PhilippSchmaelzle/speedoino/doc/Pointer/with_light.jpg

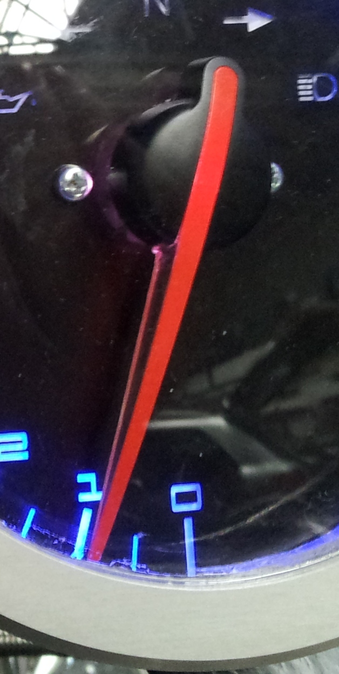
doc/Pointer/with_light.jpg
