PhilippSchmaelzle/speedoino/doc/Pointer/no_light.jpg

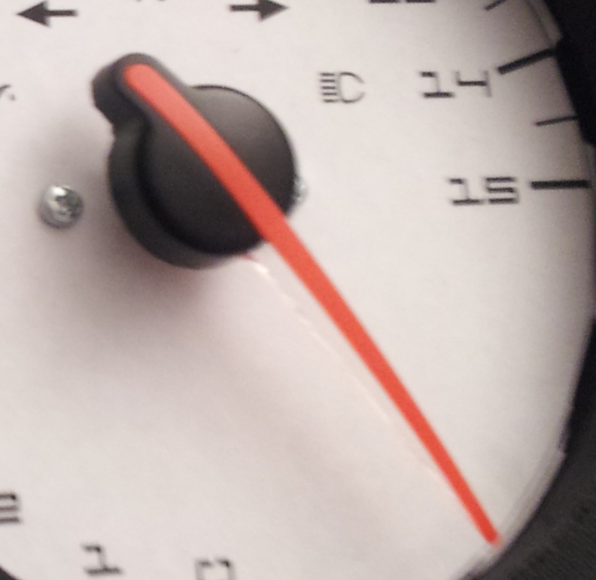
doc/Pointer/no_light.jpg
