PhilippSchmaelzle/speedoino/README.md

# speedoino
A DIY Speedometer with OLED Display, GPS, Bluetooth, etc
Please refer to www.speedoino.de
