PhilippSchmaelzle/speedoino/FirmwareReleases/README.txt

07.04.2013 	Speedoino_Phil_1v1	Lief stabil keine Interrupts auf Ölleuchte, nur polling. Keine MSG 530 Verarbeitung, letze Version aus der Einbauaktion mit Phil

07.04.2013 	Speedoino_1v11		Sollte Stabil laufen, nur schöner programmiert (Interrupts für alle V7 Platinen wenn Triumph nicht aktiv)

08.04.2013 	Speedoino_1v12		Alle Filter, alle lichter, MIL deaktiv im stand

21.06.2013	Speedoino_2v1		CAN stable @Phil (center bug)
								Gear Calibration Menu fixed
								Subdir support added (GPS)
								Demo Mode started
								Animation menu automatic
								Resolve I2C Bug leading to rare reboots
