PhilippSchmaelzle/speedoino/calculations/CAN/USB_CAN_BRIDGE/1M_pegel.BMP

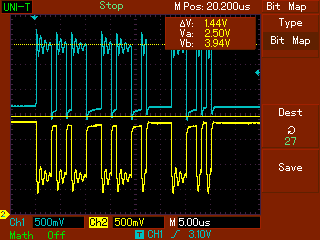
calculations/CAN/USB_CAN_BRIDGE/1M_pegel.BMP
