PhilippSchmaelzle/speedoino/calculations/CAN/USB_CAN_BRIDGE/10khz_adr123.BMP

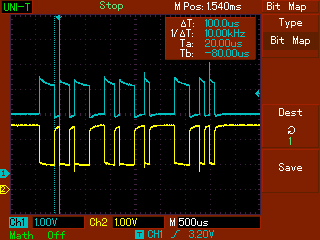
calculations/CAN/USB_CAN_BRIDGE/10khz_adr123.BMP
