PhilippSchmaelzle/speedoino/calculations/CAN/USB_CAN_BRIDGE/10khz_adr555.BMP

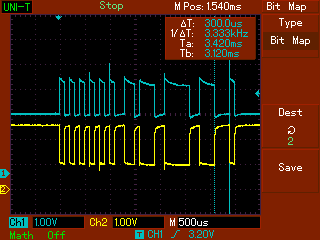
calculations/CAN/USB_CAN_BRIDGE/10khz_adr555.BMP
