PhilippSchmaelzle/speedoino/calculations/CAN/USB_CAN_BRIDGE/500khz_adr123.BMP

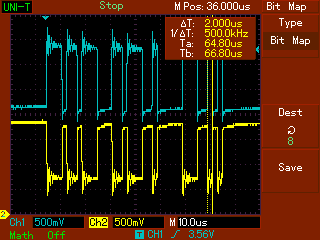
calculations/CAN/USB_CAN_BRIDGE/500khz_adr123.BMP
