PhilippSchmaelzle/speedoino/doc/Pointer/needle.bmp

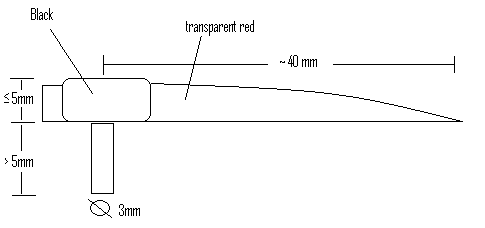
doc/Pointer/needle.bmp
