PhilippSchmaelzle/speedoino/doc/Stepper/avr446/code/IAR/doxygen/graph_legend.png

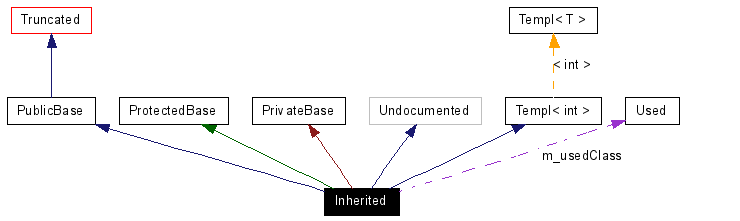
doc/Stepper/avr446/code/IAR/doxygen/graph_legend.png
