PhilippSchmaelzle/speedoino/doc/Stepper/avr446/code/IAR/doxygen/main_8c_a4_cgraph.png

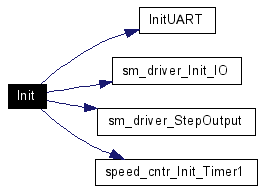
doc/Stepper/avr446/code/IAR/doxygen/main_8c_a4_cgraph.png
