PhilippSchmaelzle/speedoino/doc/Stepper/exel/floating.png

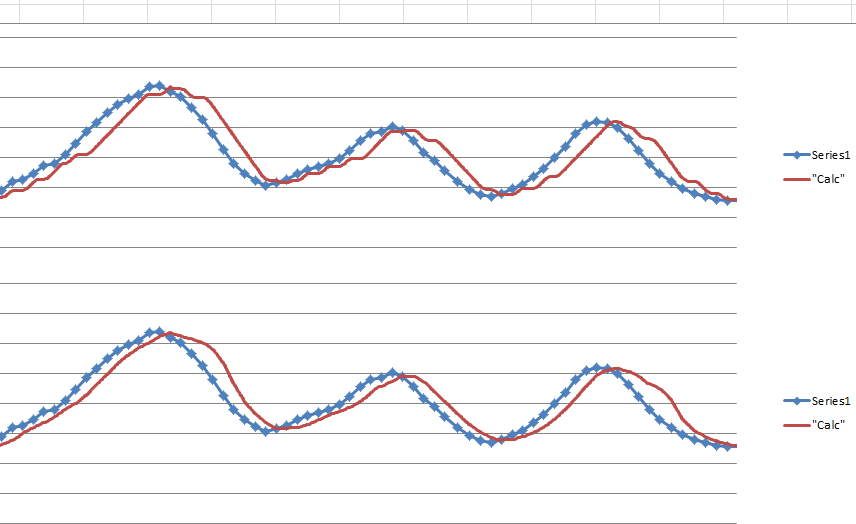
doc/Stepper/exel/floating.png
