PhilippSchmaelzle/speedoino/doc/Stepper/exel/pos_verlauf.png

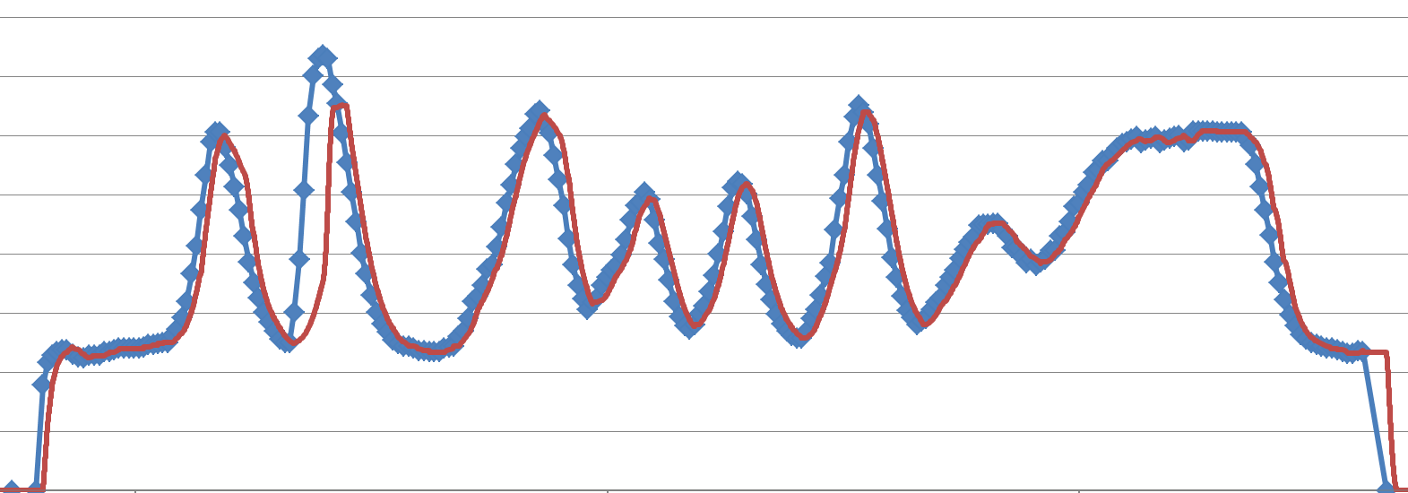
doc/Stepper/exel/pos_verlauf.png
