PhilippSchmaelzle/speedoino/pub/animation/31daf8fb84e5.gif

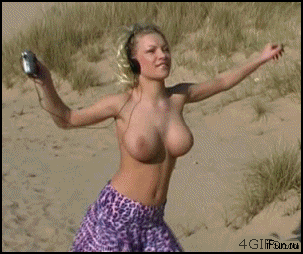
pub/animation/31daf8fb84e5.gif
