PhilippSchmaelzle/speedoino/pub/animation/659.gif

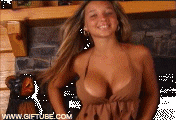
pub/animation/659.gif
