PhilippSchmaelzle/speedoino/pub/animation/Bluetop.gif

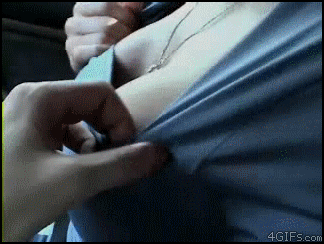
pub/animation/Bluetop.gif
