PhilippSchmaelzle/speedoino/pub/animation/doggy.gif

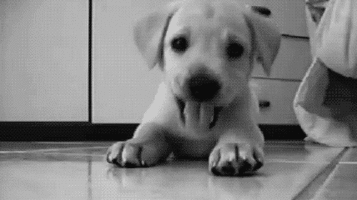
pub/animation/doggy.gif
