PhilippSchmaelzle/speedoino/pub/animation/Fluidboobs1.gif

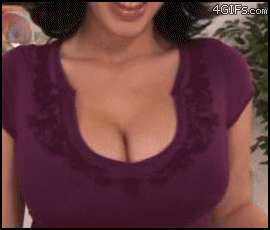
pub/animation/Fluidboobs1.gif
