PhilippSchmaelzle/speedoino/pub/animation/HarleyD.gif

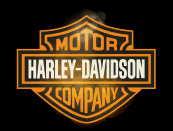
pub/animation/HarleyD.gif
