PhilippSchmaelzle/speedoino/pub/animation/Hitomi_Tanaka_oiled.gif

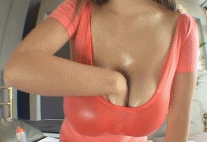
pub/animation/Hitomi_Tanaka_oiled.gif
