PhilippSchmaelzle/speedoino/pub/animation/MILF_boob_squeeze.gif

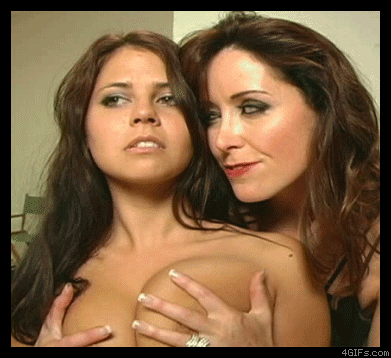
pub/animation/MILF_boob_squeeze.gif
