PhilippSchmaelzle/speedoino/pub/animation/Octojiggle.gif

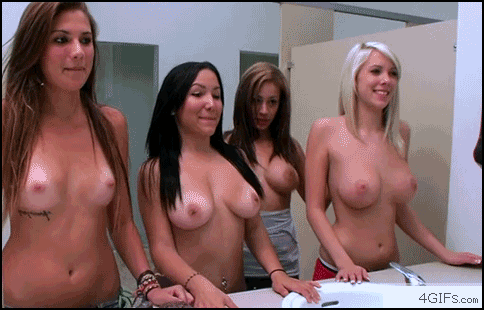
pub/animation/Octojiggle.gif
