PhilippSchmaelzle/speedoino/pub/animation/TgC_comic191.gif

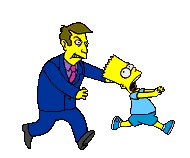
pub/animation/TgC_comic191.gif
