PhilippSchmaelzle/speedoino/pub/animation/Tiara_flasher.gif

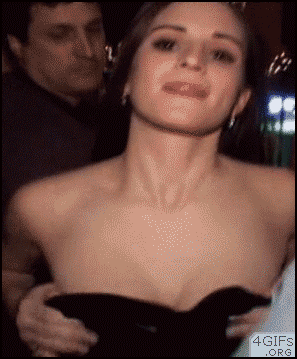
pub/animation/Tiara_flasher.gif
