PhilippSchmaelzle/speedoino/pub/speedoinocasev4zsb.jpg

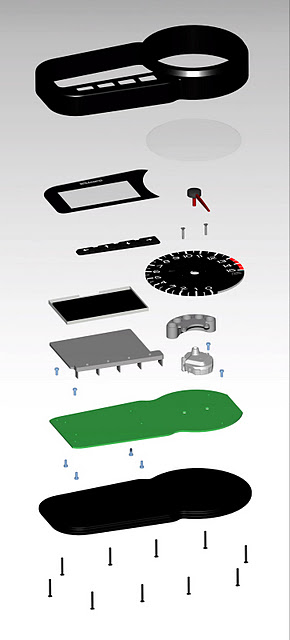
pub/speedoinocasev4zsb.jpg
