PhilippSchmaelzle/speedoino/schematics/Eagle3d/eagleUp_JKW_standalone_board_bottom.png

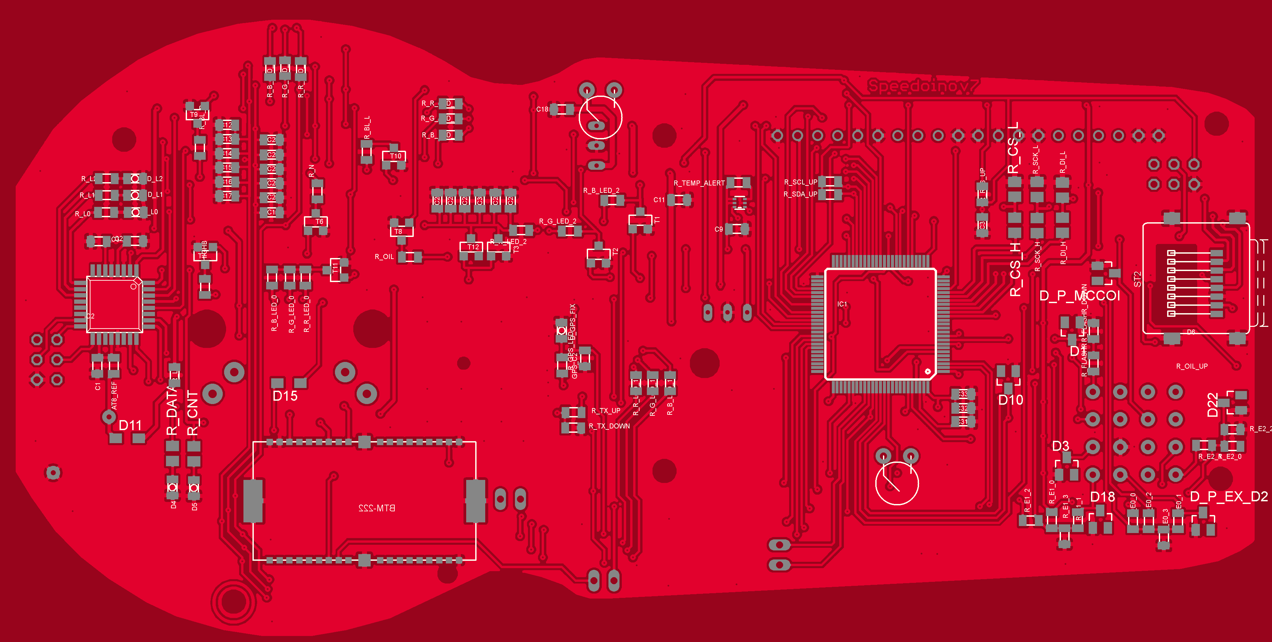
schematics/Eagle3d/eagleUp_JKW_standalone_board_bottom.png
