PhilippSchmaelzle/speedoino/schematics/Eagle3d/eagleUp_JKW_standalone_board_top.png

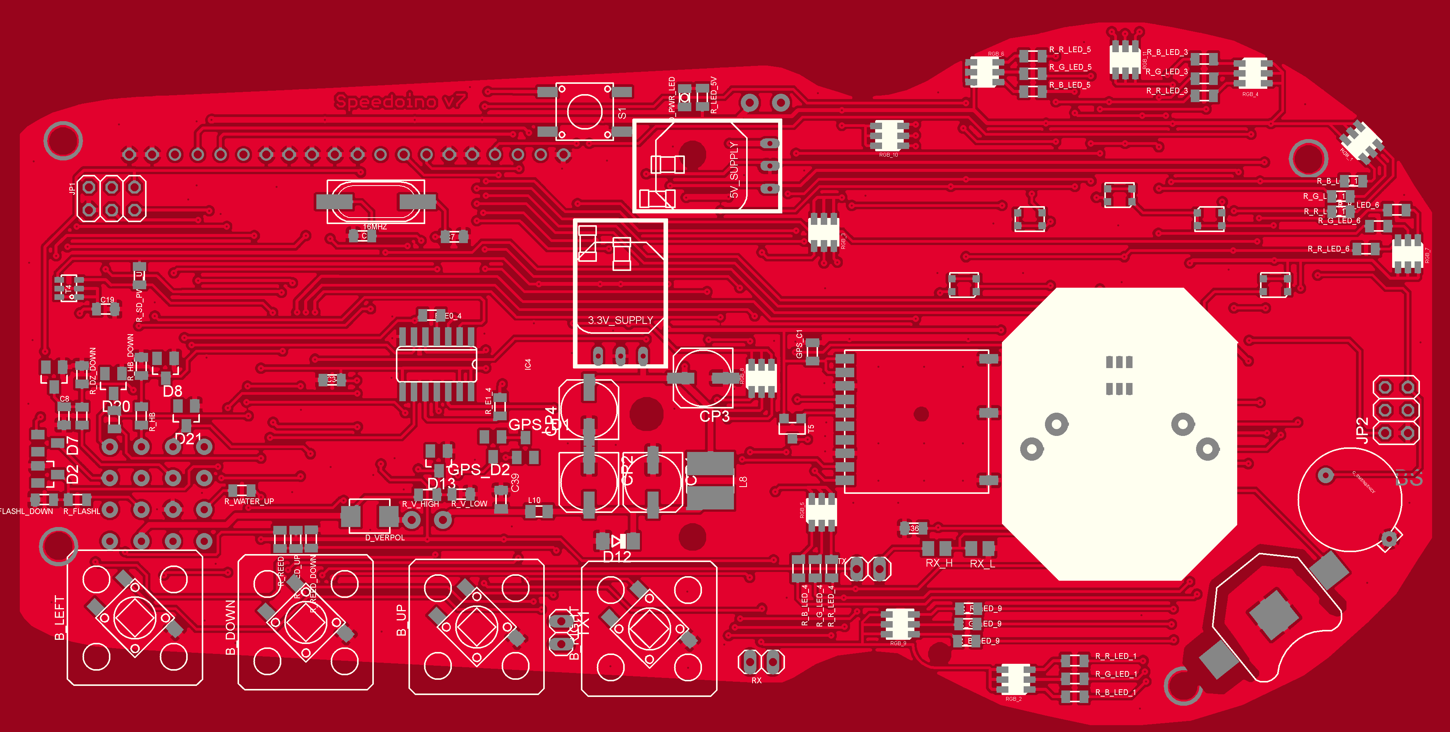
schematics/Eagle3d/eagleUp_JKW_standalone_board_top.png
