PhilippSchmaelzle/speedoino/schematics/Eagle3d/eagleUp_JKW_standalone_imagesize.png

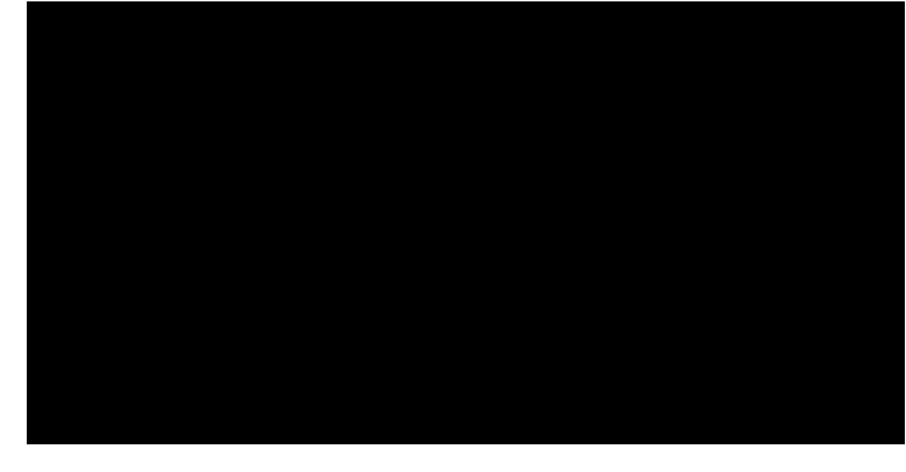
schematics/Eagle3d/eagleUp_JKW_standalone_imagesize.png
