PhilippSchmaelzle/speedoino/schematics/Eagle3d/eagleUp_JKW_standalone_outline.png

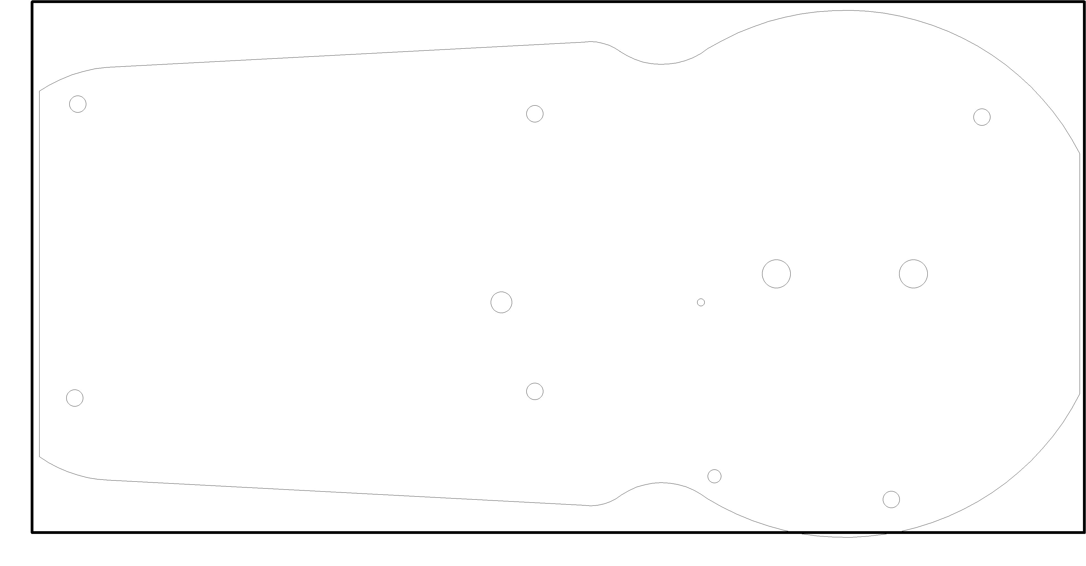
schematics/Eagle3d/eagleUp_JKW_standalone_outline.png
