PhilippSchmaelzle/speedoino/schematics/Eagle3d/eagleUp_JKW_standalone_top.png

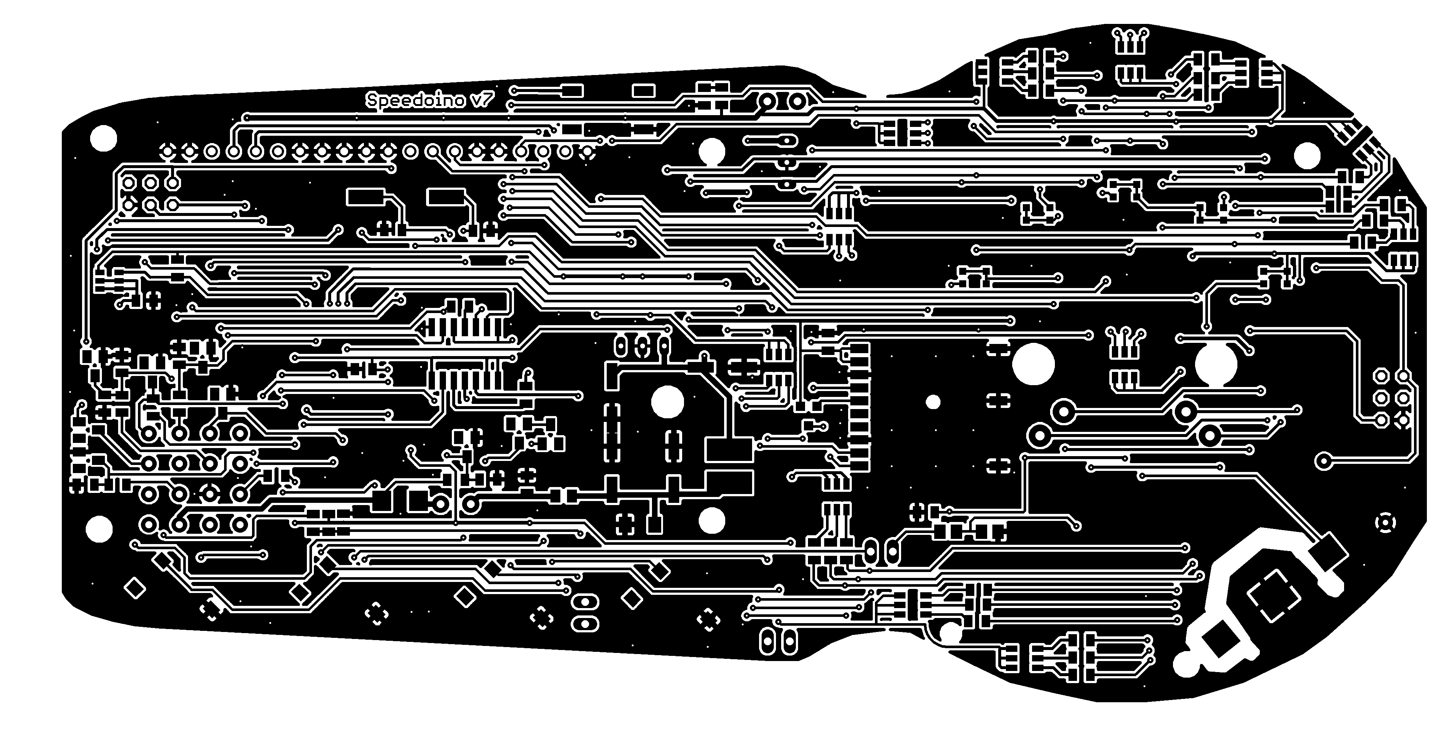
schematics/Eagle3d/eagleUp_JKW_standalone_top.png
