PhilippSchmaelzle/speedoino/schematics/Eagle3d/eagleUp_JKW_standalone_top_mask.png

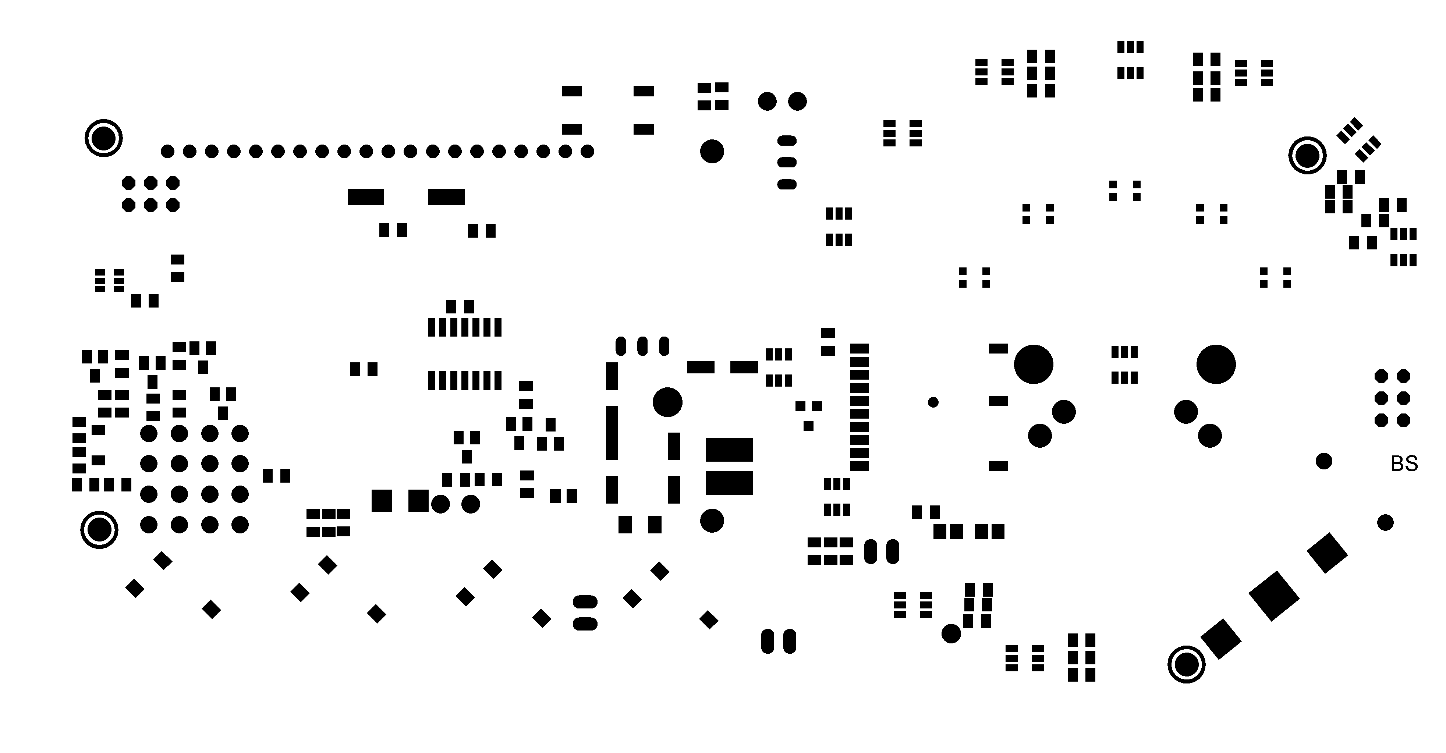
schematics/Eagle3d/eagleUp_JKW_standalone_top_mask.png
