PhilippSchmaelzle/speedoino/Tachofolie/drawing.png

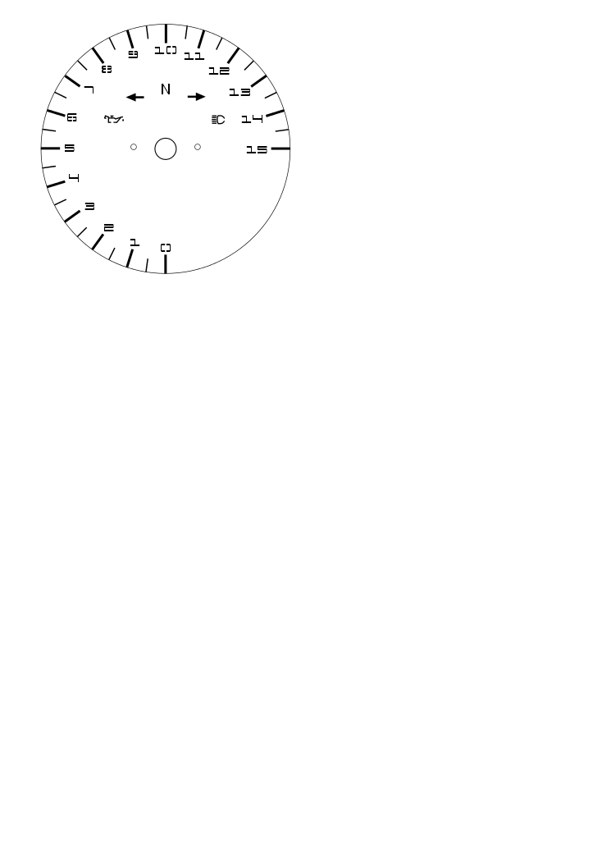
Tachofolie/drawing.png
