PhilippSchmaelzle/speedoino/webpage/kol_33.JPG

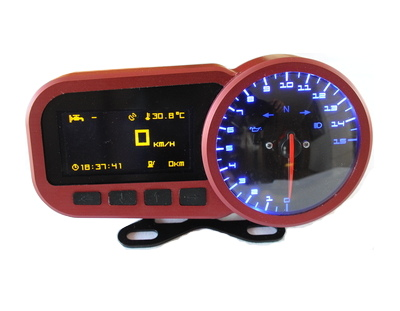
webpage/kol_33.JPG
