PhilippSchmaelzle/speedoino/webpage/status_bg.png

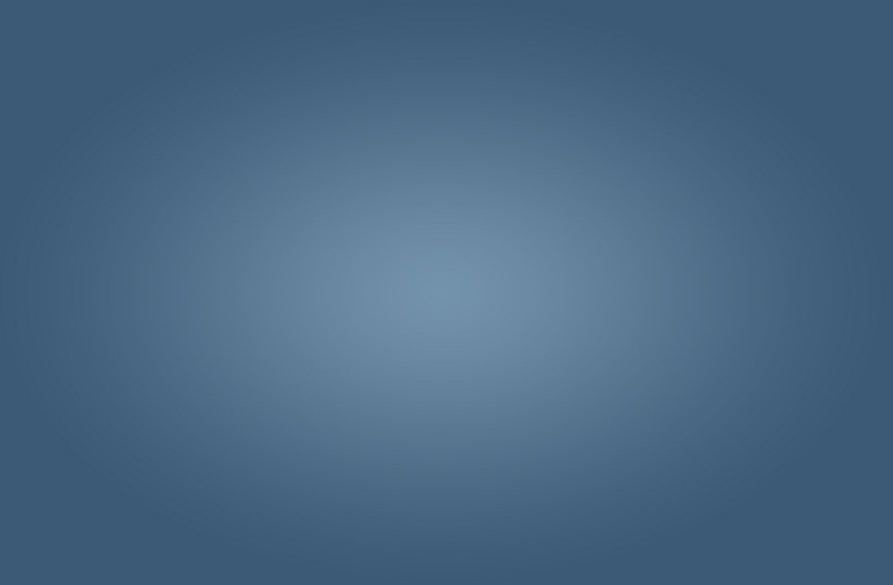
webpage/status_bg.png
