PhilippSchmaelzle/speedoino/Teile/Teileliste_2012_09_30_smd.xlsx

Sheet: Tabelle1
Anzahl | Layout Bez | Beschreibung | Beschaffung
Kondensatoren, Bauform soweit nicht anders angegeben 0805 min 6V
22 | C1, C2, C3, C4, C8, C9, C10, C12, C13, C19, C31, C32, C33, C34, C35, C36, GPS_C1, GPS_C2, GPS_C3, GPS_C4, GPS_C5, PE | 100nF | http://de.mouser.com/ProductDetail/AVX/08055C104JAT2A/
1 | C6 | 10µF min 16V | http://de.mouser.com/ProductDetail/Murata/GRM21BR61C106KE15K/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
2 | C11, C18 | 100 nF min 16V
4 | C5, C7, C_QUA_4, C_QUA_5 | 22pF | http://de.mouser.com/ProductDetail/Xicon/140-CC501N220J-RC/?qs=sGAEpiMZZMvQvaS66kI3TgKhK8TKNbtYmKg4de0aUhE%3d
1 | C39 | 2µ2 min 25V | http://de.mouser.com/ProductDetail/Vishay-Vitramon/VJ0805V225ZXQTW1BC/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
4 | CP1,CP2,CP3,CP4 | 100µF / 16V | http://de.mouser.com/ProductDetail/Panasonic/EEE-1CA101WP/
1 | C_EMERGENCY | n.b. | http://de.mouser.com/ProductDetail/Elna/DX-5R5H334U/
Widerstände, Bauform soweit nicht anders angegeben 0805 0.1W, 5%
11 | R_B_LED_1, R_B_LED_2, R_B_LED_3, R_B_LED_4, R_B_LED_5, R_B_LED_6, R_B_LED_7, R_B_LED_8, R_B_LED_9, R_B_LED_10, R_B_LED_11 | 80
11 | R_R_LED_1, R_R_LED_2, R_R_LED_3, R_R_LED_4, R_R_LED_5, R_R_LED_6, R_R_LED_7, R_R_LED_8, R_R_LED_9, R_R_LED_10, R_R_LED_11 | 92
11 | R_G_LED_1, R_G_LED_2, R_G_LED_3, R_G_LED_4, R_G_LED_5, R_G_LED_6, R_G_LED_7, R_G_LED_8, R_G_LED_9, R_G_LED_10, R_G_LED_11 | 110
1 | AT8_ref | 10 | http://de.mouser.com/ProductDetail/Panasonic-Electronic-Components/ERJ-6GEYJ100V/
2 | R_OIL_UP,R_R_LED_12 | 220 >0,25W | http://de.mouser.com/ProductDetail/Panasonic-Electronic-Components/ERJ-6GEYJ221V/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
2 | R_CNT, R_DATA | 220 | http://de.mouser.com/ProductDetail/Panasonic-Electronic-Components/ERJ-6GEYJ221V/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
2 | RX_H, R_TX_UP | 1,2k | http://de.mouser.com/ProductDetail/Panasonic-Electronic-Components/ERJ-6GEYJ122V/
17 | R_TEMP_OS, R_B_LED_12, R_B_LED_13, R_B_LED_14, R_B_LED_15, R_B_LED_16, R_B_LED_17, R_B_LED_18, R_B_LED_19, R_B_LED_20, R_FLASHL, R_FLASHR, R_HB, R_RES_UP, R_SD_PWR_UP, R_DEAKT_DAUER_P, R_DEAKT_DAUER_P1 | 10k | http://de.mouser.com/ProductDetail/Panasonic-Electronic-Components/ERJ-6GEYJ103V/
10 | R_GPS_LED, R_L0, R_L1, R_L2, R_L3, R_OIL_OV, R_OIL_OV1, R_SCL_UP, R_SDA_UP, R_V_LOW | 1k | http://de.mouser.com/ProductDetail/Panasonic-Electronic-Components/ERJ-6GEYJ102V/
2 | R_TX_DOWN, RX_L | 2,7k | http://de.mouser.com/ProductDetail/Panasonic-Electronic-Components/ERJ-6GEYJ272V/
1 | R_LED_5V | 2k | http://de.mouser.com/ProductDetail/Panasonic-Electronic-Components/ERJ-6GEYJ202V/
5 | R_DZ, R_FLASHL_DOWN, R_FLASHR_DOWN, R_HB_DOWN, R_DEAKT_DAUER_P2 | 5k | http://de.mouser.com/ProductDetail/Vishay-Dale/CRCW08055K00FKTA/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
1 | R_REED | 7k | http://de.mouser.com/ProductDetail/Xicon/292-715K-RC/
0 | R_E0_0, R_E0_2, R_E0_4, R_E1_0, R_E1_2, R_E1_4, R_E2_0, R_E2_2, R_E0_1, R_E0_3, R_E1_1, R_E1_3, R_E2_1 , R_REED_UP, R_REED_DOWN | n.b.
1 | R_DELAY | 300 | http://de.mouser.com/ProductDetail/Bourns/CR0805-JW-301ELF/
4 | R_HB1, R_HB2, R_HB3, R_HB4 | 604 | http://de.mouser.com/ProductDetail/Xicon/292-604-RC/
1 | R_WATER_UP | 390 1% | http://de.mouser.com/ProductDetail/Bourns/CR0805-FX-3900GLF/
2 | R_OIL , R_R_LED_0 | 51 >0,25W for RED LED | http://de.mouser.com/ProductDetail/Panasonic-Electronic-Components/ERJ-P06J510V/
1 | R_HIGHB | 46 >0,25W for BLUE LED | http://de.mouser.com/ProductDetail/KOA-Speer/SG73P2ATTD47R0F/
3 | R_BL_L, R_BL_R, R_N | 33 >0,25W for GREEN LED | http://de.mouser.com/ProductDetail/KOA-Speer/SG73P2ATTD33R0F/
1 | R_V_HIGH | 2,2k | http://de.mouser.com/ProductDetail/Xicon/260-22K-RC/
1 | R_DZ_DOWN | 3,3k | http://de.mouser.com/ProductDetail/Xicon/260-33K-RC/
LEDs, Bauform soweit nicht anders angegeben 0805
5 | D4, D_GPS_FIX, D_PWR_LED ,D_L0, D_L1 | LED 1.7V 20mA Red | https://de.mouser.com/Search/ProductDetail.aspx
2 | D5,D_L2 | LED 3.2V 20mA Blue | https://de.mouser.com/Search/ProductDetail.aspx
2 | U$11, U$22 | CLM4B-RKW-CWAXBAA3 | http://de.mouser.com/ProductDetail/Cree-Inc/CLM4B-RKW-CWAXBAA3/
11 | L1,L2,L3,L4,L5,L6,L7 | RGBLED | http://de.mouser.com/ProductDetail/OSRAM-Opto-Semiconductors/LRTBGFTM-ST7-1+VV9-29+Q5R/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
1 | U$3 | Blue 500mcd CLM4B-BKW-CTBVA363 | http://de.mouser.com/ProductDetail/Cree-Inc/CLM4B-BKW-CTBVA363/
2 | U$11,U$22 | Red 1600mcd CLM4B-RKW-CWAXBAA3 | http://de.mouser.com/ProductDetail/Cree-Inc/CLM4B-RKW-CWAXBAA3/
0 |  | White 14kmcd CLP6B-WKW-CD0E0233 | http://de.mouser.com/ProductDetail/Cree-Inc/CLP6B-WKW-CD0E0233/
3 | R_GR_BL_L, R_GR_BL_R, R_N | Green 1800 mcd CLM4BGKWCWBYA693 | http://de.mouser.com/ProductDetail/Cree-Inc/CLM4B-GKW-CWBYA693/
Dioden, Bauform soweit nicht anders angegeben SOT23
2 | D6, D12 | 20V-Zdiode | http://de.mouser.com/ProductDetail/Vishay-Semiconductors/DZ23C20-V-GS08/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
3 | D7, D12, D14 | 771-PMBD7000235 | http://de.mouser.com/ProductDetail/NXP-Semiconductors/PMBD7000235/
2 | GPS_D1, GPS_D2 | 771-BAV23C,215 | http://de.mouser.com/ProductDetail/NXP/BAV23C215/
9 | D1, D2, D3, D8, D10, D13, D20, D21, D22 | 5.6V Z-Diode 78-MMBZ5232B-V | http://de.mouser.com/ProductDetail/Vishay-Semiconductors/MMBZ5232B-V-GS08/
2 | D9,D15 | 726-BAT60AE6327 | http://de.mouser.com/ProductDetail/Infineon/BAT-60A-E6327/
2 | D_VERPOL, D_VERPOL1 | SS24T3G | http://de.mouser.com/ProductDetail/ON-Semiconductor/SS24T3G/
2 | D18, D_P_MCCOI | ZENER-DIODESOT23 | http://de.mouser.com/ProductDetail/Vishay-Semiconductors/MMBZ5232B-V-GS08/
Sonstige Bauteile
6 | PWR, PWR1, RX, TX, TX1, TX2 | n.b. | http://de.mouser.com/ProductDetail/Molex/22-28-5020/?qs=sGAEpiMZZMtsLRyDR9nM1xLIxIpBOgV0bdXNdjSfe88%3d
1 | NHD_2.7 | n.b. | http://de.mouser.com/ProductDetail/FCI/68001-420HLF/
11 | T1, T2, T3, T6, T7, T8, T9, T10, T11, T12, T13 | 2N7002BKW,215 | http://de.mouser.com/ProductDetail/NXP/2N7002BK215/
2 | JP1,JP2 | n.b. | http://de.mouser.com/ProductDetail/Harwin/M20-9980346/
1 | IC4 | Atmega2560, TQFP100 | http://de.mouser.com/ProductDetail/Atmel/ATmega2560-16AU/?qs=sGAEpiMZZMtkfMPOFRTOl4TPj%252bk4h3O1
1 | IC2 | Atmega8L-8AU, TQFP32 | http://de.mouser.com/ProductDetail/Atmel/ATmega8L-8AU/?qs=sGAEpiMZZMtkfMPOFRTOl3USJvjndwHJ
1 | BAT | n.b. | http://de.mouser.com/ProductDetail/Renata/CR2016-MFRTS/?qs=sGAEpiMZZMuauSEoLDNvSu7sAmakP0ZEzrmnmvSYEgo%3d
1 | BAT_CLIP | Batteriehalter | http://de.mouser.com/ProductDetail/Keystone-Electronics/3000TR/
1 | BTM222 | Bluetooth
1 | 3.3V_SUPPLY | n.b. | http://de.mouser.com/ProductDetail/Murata-Power-Solutions/OKI-78SR-33-15-W36H-C/
1 | 5V_SUPPLY | n.b. | http://de.mouser.com/ProductDetail/Murata-Power-Solutions/OKI-78SR-5-15-W36H-C/
1 | NHD_2.7 | n.b. | http://de.mouser.com/Search/ProductDetail.aspx
1 | DZM | n.b.
1 | ST2 | Micro SD Sockel | https://de.mouser.com/Search/ProductDetail.aspx
1 | GPS | MediaTek MT3339 | http://shop.trenz-electronic.de/catalog/product_info.php?products_id=1000
2 | 5V_F,12V_F1 | n.b. | http://de.mouser.com/ProductDetail/Littelfuse/72R050XU/?qs=sGAEpiMZZMu7EFbsM1w0nYqj83OvMWW8AHhRQEUj9io%3d
2 | 16Mhz | Quarz | http://de.mouser.com/ProductDetail/ABRACON/ABLS-16000MHZ-B4-T/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
4 | S6,S7,S8,S9 | n.b.
1 | IC1 | Schmitttrigger | http://de.mouser.com/ProductDetail/Texas-Instruments/CD4093BNSRG4/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
1 | S1 | Simpler Taster | https://de.mouser.com/Search/ProductDetail.aspx?R=101-0364-EVvirtualkey12040000virtualkey101-0364-EV
1 | SE95D | TempSensor | http://de.mouser.com/ProductDetail/NXP-Semiconductors/SE95D118/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
4 |  | n.b. | http://de.mouser.com/ProductDetail/RAF-Electronic-Hardware/M0503-25-AL/
1 | U$14 | Bus Transiver SD Karte | http://de.mouser.com/ProductDetail/Texas-Instruments/SN74LVCH245APW/
1 | U$19 | MCP23017 Port Expander | http://de.mouser.com/ProductDetail/Microchip-Technology/MCP23017-E-SO/
1 |  | n.b.
1 |  | n.b.
Spulen
1 | L8 | Spitzenfilter, 22µH 1A | http://de.mouser.com/ProductDetail/Sumida/CR54NP-220MC/
1 | L10 | BLM21PG221SN1 | http://de.mouser.com/ProductDetail/Murata/BLM21PG221SN1D/?qs=N%2fLoXOA9PTJ4i6RHFrsqmw%3d%3d
 |  | Transistoren
11 | Q1, Q2, Q3, Q4, Q5, Q6, Q7, Q8, Q9, Q10, Q11 | BSS84 RGB LED Transistoren | http://de.mouser.com/ProductDetail/Fairchild-Semiconductor/BSS84/?qs=sGAEpiMZZMvAvBNgSS9LqoXv9kllCDUW
1 | T5 | 771-2N7002BK215 | http://de.mouser.com/ProductDetail/NXP/2N7002BK215/
2 | T_P_BRIDGE, T_P_BRIDGE1 | PMV160UP215 | http://de.mouser.com/ProductDetail/NXP/PMV160UP215/

Sheet: Patrick
Bluetooth | 13.65 | Summe | 74.94
Mouserparts | 49.75
Atmega | 11.54

Sheet: Tabelle1_2
Menge | Wert | Device | Bauteile
1 | 0R | R0805 | R_L3
8 | 1k | R0805 | R_GPS_LED, | R_L0, | R_L1, | R_L2, | R_SCL_UP, | R_SDA_UP, | R_TEMP_ALERT, | R_V_LOW
1 | 1k2 | R0805 | R_TX_UP
1 | 2k | R0805 | R_LED_5V
1 | 2k2 | R0805 | R_V_HIGH
1 | 2k7 | R0805 | R_TX_DOWN
1 | 3k3 | R0805 | R_DZ_DOWN
1 | 7k | R0805 | R_REED
1 | 10R | R0805 | AT8_REF
5 | 10k | R0805 | R_FLASHL, | R_FLASHR, | R_HB, | R_RES_UP, | R_SD_PWR_UP
3 | 24R | R0805 | R_B_LED_0, | R_G_LED_0, | R_R_LED_0
1 | 490R | R0805 | R_HIGHB
1 | 565R | R0805 | R_OIL
3 | 33R | R0805 | R_BL_L, | R_BL_R, | R_N
12 | 90R | R0805 | R_B_LED_1, | R_B_LED_2, | R_B_LED_3, | R_B_LED_4, | R_B_LED_5, | R_B_LED_6, | R_G_LED_1, | R_G_LED_2, | R_G_LED_3, | R_G_LED_4, | R_G_LED_5, | R_G_LED_6
6 | 100R | R0805 | R_R_LED_1, | R_R_LED_2, | R_R_LED_3, | R_R_LED_4, | R_R_LED_5, | R_R_LED_6
1 | 220R | R0805 | R_OIL_UP
1 | 390R | R0805 | R_WATER_UP
4 | 5k | R0805 | R_DZ, | R_FLASHL_DOWN, | R_FLASHR_DOWN, | R_HB_DOWN
8 | n.b. | R0805 | R_E0_0, | R_E0_2, | R_E0_4, | R_E1_0, | R_E1_2, | R_E1_4, | R_E2_0, | R_E2_2
61 | 0.005 | 0.305
1 | 2µ2/100V | C0805 | C39
1 | 4.7µF | C0805 | C4
1 | 10uF | C0805 | C6
1 | 22p | C0805 | C35
2 | 100n/20V | C0805 | C11, | C18
33 | 100nF | C0805 | C1, | C2, | C3, | C5, | C7, | C8, | C9, | C10, | C12, | C13, | C14, | C15, | C16, | C17, | C19, | C20, | C21, | C22, | C23, | C24, | C25, | C26, | C27, | C28, | C29, | C30, | C31, | C32, | C33, | C34, | C36, | GPS_C1, | GPS_C2
4 | 220µF/16V | C_SMD_SMP | CP1, | CP2, | CP3, | CP4
9 | 5.5V | ZENER-DIODESOT23 | D1, | D2, | D3, | D8, | D10, | D13, | D20, | D21, | D22
1 | 20V-Zdiode | ZENER-DIODESOT23 | D6
3 | 78-MMBZ5232B-V | ZENER-DIODESOT23 | D18, | D_P_EX_D2, | D_P_MCCOI
1 | 20V-Zdiode | ZENER-DIODESOD80C | D12
1 | SS24T3G | D-SSMB-A+K | D_VERPOL
3 | LED0805 | D_L0, | D_L1, | D_L2
3 | PINHD-1X2 | RX, | TX, | TX1
1 | SW-TASTERECO-DIAGONAL | S1
1 | 1.1A | POLY_FUSE | 12V_F1
4 | 1k2 | R-EU_M0805 | RX_H, | R_CS_H, | R_DI_H, | R_SCK_H
4 | 2k7 | R-EU_M0805 | RX_L, | R_CS_L, | R_DI_L, | R_SCK_L
1 | 5k | / | n.b. | (Reed) | R0805 | R_REED_DOWN
1 | 22µH | 1A | LPD54 | L8
2 | 220R | R-EU_M0805 | R_CNT, | R_DATA
1 | 600mA | POLY_FUSE | 5V_F
2 | 771-BAV23C,215 | D-A1-C3 | GPS_D1, | GPS_D2
1 | 771-PMBD7000235 | D-A1-C3 | D7
1 | 4093D | 4093D | IC1
1 | BLM21PG221SN1 | L0808+0603 | L10
1 | Blue | LED0805 | D5
1 | DX-5R5H334U | DX-5R5H334U | C_EMERGENCY
1 | F_908642 | BATTERY12MM | GPS_BAT
1 | HighB | _ | 645-598-8191-107F | CHANGE | LED0805 | D_BL_HB
2 | ICSP | PINHD-2X3 | JP1, | JP2
1 | LXDC2HL33A-055 | LXDC2HL33A-055 | DC3.3
2 | Mouser | 726-BAT60AE6327 | DIODE-SOD323-W | D11, | D15
10 | Mouser: | 771-2N7002BK215 | 0 | N-Channel, | 60V | 350mA, | SOT-23, | 0,052€ | T-P-FETBSS139 | T1, | T2, | T3, | T5, | T6, | T7, | T8, | T9, | T10, | T11
1 | Mouser: | 941-CLP6BWKWCD0E0233 | RGB_LED | POINTER_WHITE
1 | OIL | M | 645-598-8110-107F | CHANGE! | LED0805 | D_RE_OIL
3 | PLCC4_LED | PLCC4_LED | D_GR_BLR, | D_GR_N, | R_GR_BL_L
1 | R-7805-1.0 | R-7805-1.0 | PWR_R78
6 | RGB_LED | RGB_LED | RGB_2, | RGB_3, | RGB_4, | RGB_5, | RGB_6, | RGB_7
3 | Red | LED0805 | D4, | D_GPS_FIX, | D_PWR_LED
4 | SMD_TASTER_MIT_KAPPE | SMD_TASTER_MIT_KAPPE | B_DOWN, | B_LEFT, | B_RIGHT, | B_UP
1 | T-IRLMS6702 | T-IRLMS6702 | T4
1 | TMP102 | TMP102 | TMP102AIDRLT
5 | n.b. | / | 0R | R0805 | R_E0_1, | R_E0_3, | R_E1_1, | R_E1_3, | R_E2_1
1 | n.b. | / | 5k | (Reed) | R0805 | R_REED_UP
1 | 16Mhz | XT-HC49-SMD | 16MHZ
1 | AT-MEGA-8 | AT-MEGA-8 | IC2
1 | ATMEGA2560-16AU | ATMEGA2560-16AU | IC4
1 | STEPPER | STEPPER | STEPPER
1 | NHD_2.7_SOLO_RO | NHD_2.7_SOLO_RO | NHD_2.7
1 | BTM-222 | BTM-222 | BLUETOOTH
1 | SD_MICRO | SD_MICRO | ST2
1 | SPEEDOSTECKER | SPEEDOSTECKER | SPEEDOSTECKER
1 | MT3329 | MT3329 | GPS
