PhilippSchmaelzle/speedoino/calculations/Speedoino_plan.ods

Sheet: Tabelle1
Bestellungen Runde 1
Leute denen ich geschrieben habe: | Status | wer zahlt bis fertig? | Woher? | Gehäusefarbe | Android?
Patrick | voll dabei | Kolja aber falls es eng wird selbst | Essen (200km) | schwarz
Jörn | geht studieren | Kolja aber falls es eng wird selbst | Stuttgart (viel) | ?
Andrej | ohne Gehäuse dabei | Komponenten selbst, vielleicht GPS mit bestellen | Herfort (100km) | -
Phil | voll dabei | Kolja komplett :D Gehäuse abzahlen | ? BadenBaden | schwarz
ICH .. ach ja | aber sowas von | Kolja … | ja... | ROT
Lilith | krank | muss selbst ab start der Elektronik | ? | poliert selbst
Skoripion1976 aka Thomas | scheinbar voll dabei | muss selbst ab start der Elektronik | ? | poliert selbst
Hornissentreiber aka Otmar | meldet sich nicht mehr
Mikki aka Michael | raus
KGR84 aka Roman | raus
Zeitlicher Plan
Datum | Aktion | Kosten |  | Summe
22.09.2012 – 29.9.2012 | Zurückkommen, Gehäuse bekommen | … abzuchecken, erstmal Phil?
01.10.12 | Scheiben und Maßhaltigkeit testen, bestellen | 270,00 € |  | 270
01.10.12 | Elox? | schwer zu sagen, 150 – 500 €, wähle 250€ |  | 550
01.11.2012 / 1.12.2012 | Elektronik bestellen falls Genug Geld da | 1300 € für 5, entsprechend mehr bei Th und Li |  | 1850
 | von Jörn, Patrick und Andrej Geld bekommen | 2*500

Sheet: Tabelle2
id | wann | wofür | wieviel | Patrick Posten |  | Phil Posten |  | Thomas Posten |  | Andre Posten |  | Kolja Posten
0 | 01.09.12 | Gehäuse (400€/10 Stück) | 225,00 € | 1 | 45,00 € | 1 | 45,00 € | 1 | 45,00 € | 1 | 45,00 € | 1 | 45,00 €
1 | 28.09.12 | BTM222 | 63,80 € | 1 | 12,76 € | 1 | 12,76 € | 1 | 12,76 € | 1 | 12,76 € | 1 | 12,76 €
2 | 28.09.12 | MT3339 | 109,72 € | 1 | 21,94 € | 1 | 21,94 € | 1 | 21,94 € | 1 | 21,94 € | 1 | 21,94 €
3 | 01.10.12 | Gewölbte Scheibe | 63,91 € | 1 | 12,78 € | 1 | 12,78 € | 1 | 12,78 € | 1 | 12,78 € | 1 | 12,78 €
4 | 15.09.12 | Bohrer | 8,75 € | 1 | 1,75 € | 1 | 1,75 € | 1 | 1,75 € | 1 | 1,75 € | 1 | 1,75 €
5 | 25.09.12 | Zeiger | 82,13 € | 1 | 16,43 € | 1 | 16,43 € | 1 | 16,43 € | 1 | 16,43 € | 1 | 16,43 €
6 | 26.09.12 | Gewindeschneider | 17,88 € | 1 | 3,58 € | 1 | 3,58 € | 1 | 3,58 € | 1 | 3,58 € | 1 | 3,58 €
7 | 12.10.12 | Schrauben | 12,95 € | 1 | 2,59 € | 1 | 2,59 € | 1 | 2,59 € | 1 | 2,59 € | 1 | 2,59 €
8 | 29.11.12 | Platinen | 791,41 € | 1 | 158,28 € | 1 | 158,28 € | 1 | 158,28 € | 1 | 158,28 € | 1 | 158,28 €
9 | 03.12.12 | Mouser | 221,97 € | 1 | 44,39 € | 1 | 44,39 € | 1 | 44,39 € | 1 | 44,39 € | 1 | 44,39 €
10 | 13.12.12 | ATmega328 | 18,70 € | 1 | 3,74 € | 1 | 3,74 € | 1 | 3,74 € | 1 | 3,74 € | 1 | 3,74 €
11 | 13.12.12 | Stößel | 7,48 € | 1 | 1,50 € | 1 | 1,50 € | 1 | 1,50 € | 1 | 1,50 € | 1 | 1,50 €
12 | 13.12.12 | Taster | 7,53 € | 1 | 1,51 € | 1 | 1,51 € | 1 | 1,51 € | 1 | 1,51 € | 1 | 1,51 €
13 | 19.12.12 | Motoren | 106,51 € | 1 | 21,30 € | 1 | 21,30 € | 1 | 21,30 € | 1 | 21,30 € | 1 | 21,30 €
14 | 19.01.13 | 3x M2 Fräser | 16,35 € | 1 | 3,27 € | 1 | 3,27 € | 1 | 3,27 € | 1 | 3,27 € | 1 | 3,27 €
15 | 17.01.13 | DZM Trägerscheiben | 5,70 € | 1 | 1,14 € | 1 | 1,14 € | 1 | 1,14 € | 1 | 1,14 € | 1 | 1,14 €
16 | 21.01.13 | Tasternegativ | 50,00 € | 1 | 10,00 € | 1 | 10,00 € | 1 | 10,00 € | 1 | 10,00 € | 1 | 10,00 €
17 | 21.01.13 | Sprühkleber, 2k Eproxy, Plastikkleber | 21,40 € | 1 | 4,28 € | 1 | 4,28 € | 1 | 4,28 € | 1 | 4,28 € | 1 | 4,28 €
18 | 21.01.13 | Mobasil | 21,45 € | 1 | 4,29 € | 1 | 4,29 € | 1 | 4,29 € | 1 | 4,29 € | 1 | 4,29 €
19 | 26.01.13 | DZM Trägerscheiben | 21,50 € | 1 | 4,30 € | 1 | 4,30 € | 1 | 4,30 € | 1 | 4,30 € | 1 | 4,30 €
20 | 26.01.13 | Kabeldurchführung | 3,70 € | 1 | 0,93 € | 1 | 0,93 € | 0 | 0 | 1 | 0,93 € | 1 | 0,93 €
21 | 26.01.13 | Geschrotteter ATmega328 | 3,15 € | 1 | 0,63 € | 1 | 0,63 € | 1 | 0,63 € | 1 | 0,63 € | 1 | 0,63 €
22 | 28.01.13 | M2 / M2.5 Schrauben | 13,90 € | 1 | 2,78 € | 1 | 2,78 € | 1 | 2,78 € | 1 | 2,78 € | 1 | 2,78 €
23 | 11.02.13 | Antiflex Plexischeibe | 195,16 € | 1 | 39,03 € | 1 | 39,03 € | 1 | 39,03 € | 1 | 39,03 € | 1 | 39,03 €
24 | 11.02.13 | Sandstrahlen | 20,00 € | 1 | 10,00 € | 0 | 0 | 0 | 0 | 1 | 10,00 € | 0 | 0
25 | 07.03.13 | Eloxieren | 110,00 € | 1 | 27,50 € | 1 | 27,50 € | 0 | 0 | 1 | 27,50 € | 1 | 27,50 €
26 | 22.03.13 | Wasserdichte Stecker | 9,18 € | 1 | 1,84 € | 1 | 1,84 € | 1 | 1,84 € | 1 | 1,84 € | 1 | 1,84 €
27 | 08.01.13 | Kosohalter | 34,15 € | 0 | 0 | 0 | 0 | 0 | 0 | 1 | 17,08 € | 1 | 17,08 €
28 | 01.09.12 | 2. Gehäuse | 40,00 € | 1 | 40,00 € | 0 | 0 | 0 | 0 | 0 | 0 | 0 | 0
29 | 07.04.13 | CAN Modul | 50,00 € | 0 | 0 | 1 | 25,00 € | 1 | 25,00 € | 0 | 0 | 0 | 0
30 | 21.03.13 | Honda Stecker | 51,70 € | 1 | 17,23 € | 0 | 0 | 1 | 17,23 € | 1 | 17,23 € | 0 | 0
Summe |  |  | 2.405,08 € |  | 514,76 € |  | 472,53 € |  | 461,34 € |  | 491,84 € |  | 464,61 €
Gezahlt |  |  |  |  | 514,76 € |  | 500,00 € |  | 400,00 € |  | 250,00 € |  | 999,99 €
 |  |  |  |  | 0,00 € |  | -27,47 € |  | 61,34 € |  | 241,84 € |  | -535,38 €
