PhilippSchmaelzle/speedoino/cnc/Lichtschutz/lichtschutz.stp

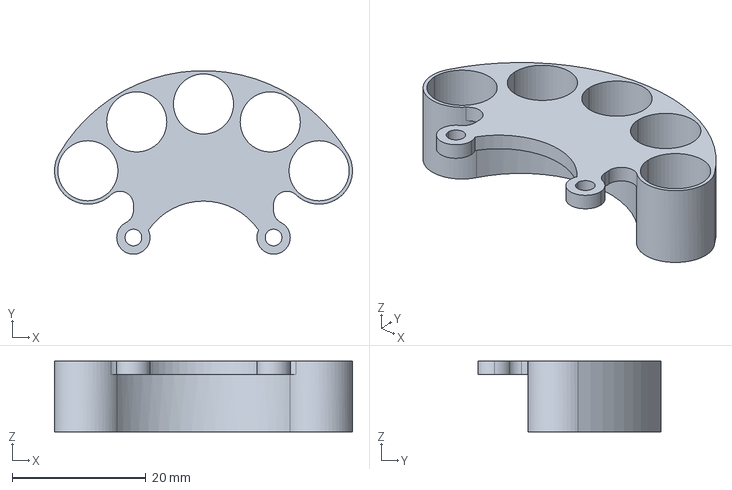
[picture p42: CAD file, 2020-05-02]
cnc/Lichtschutz/lichtschutz.stp
44.6 x 27.5 x 10.6 mm
