PhilippSchmaelzle/speedoino/cnc/Oberteil/2012_06_26/Oberteil.stp

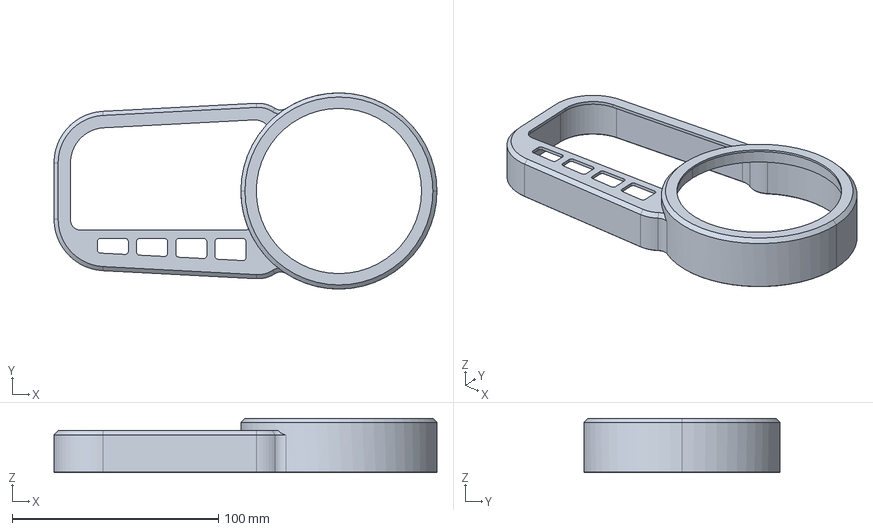
[picture p43: CAD file, 2020-05-02]
cnc/Oberteil/2012_06_26/Oberteil.stp
185.5 x 95.0 x 26.3 mm
