PhilippSchmaelzle/speedoino/cnc/Scheibe/02_06_2012/Scheibe 0.35mm kleiner.STEP

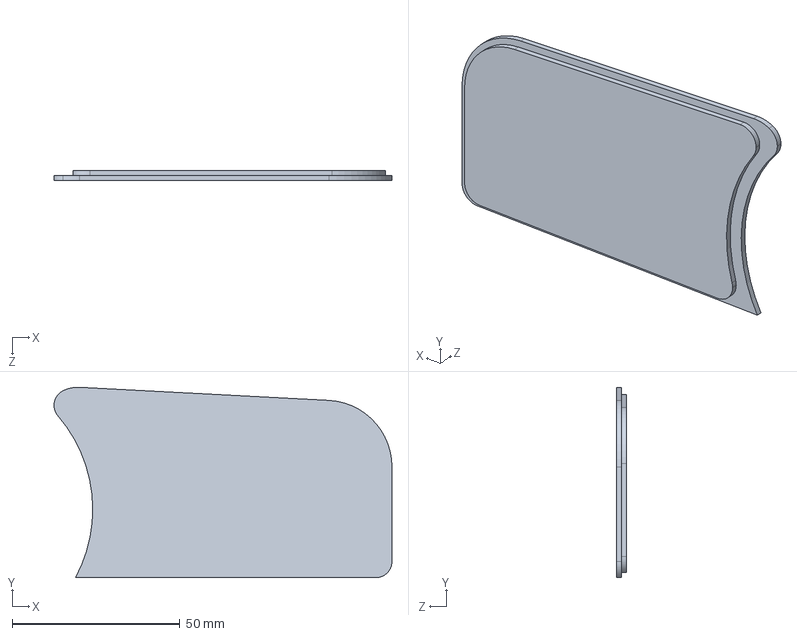
[picture p44: CAD file, 2020-05-02]
cnc/Scheibe/02_06_2012/Scheibe 0.35mm kleiner.STEP
100.7 x 56.7 x 3.00 mm
