PhilippSchmaelzle/speedoino/cnc/Scheibe/26_06_2012/Scheibe 0.35mm kleiner 2D.dxf

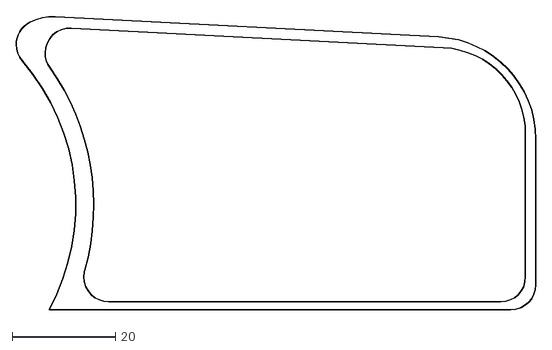
[picture p45: CAD file, 2020-05-02]
cnc/Scheibe/26_06_2012/Scheibe 0.35mm kleiner 2D.dxf
100.7 x 56.8
