PhilippSchmaelzle/speedoino/cnc/Sonstiges/Displayhalterung20111113_1.stp

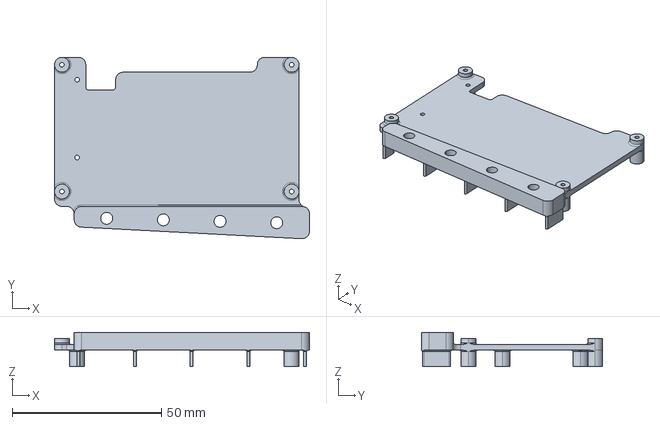
[picture p46: CAD file, 2020-05-02]
cnc/Sonstiges/Displayhalterung20111113_1.stp
85.5 x 60.8 x 11.5 mm
