PhilippSchmaelzle/speedoino/cnc/Taster/2012_08_13/Taster_Gussform.stp

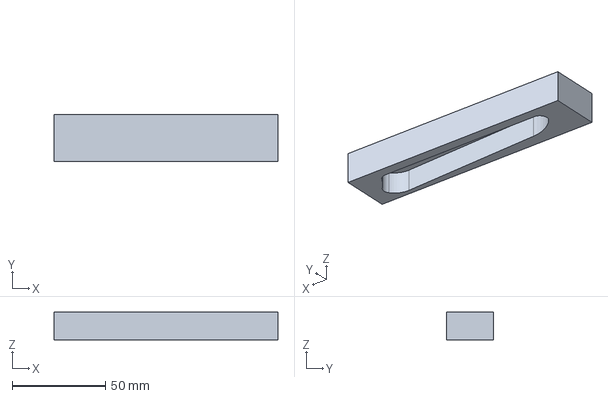
[picture p47: CAD file, 2020-05-02]
cnc/Taster/2012_08_13/Taster_Gussform.stp
120.0 x 25.0 x 15.0 mm
