PhilippSchmaelzle/speedoino/cnc/Unterteil/2012_07_26/Unterteil.stp

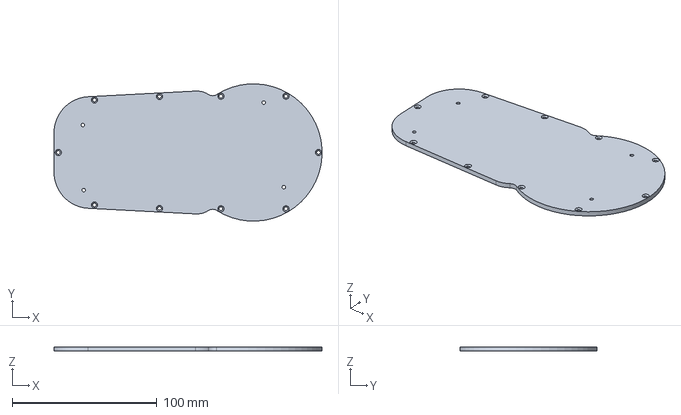
[picture p48: CAD file, 2020-05-02]
cnc/Unterteil/2012_07_26/Unterteil.stp
185.4 x 94.9 x 3.00 mm
