PhilippSchmaelzle/speedoino/cnc/Lichtschutz/Spacer_Ziffernblatt_V2_Patrick_2012-09-02.stp

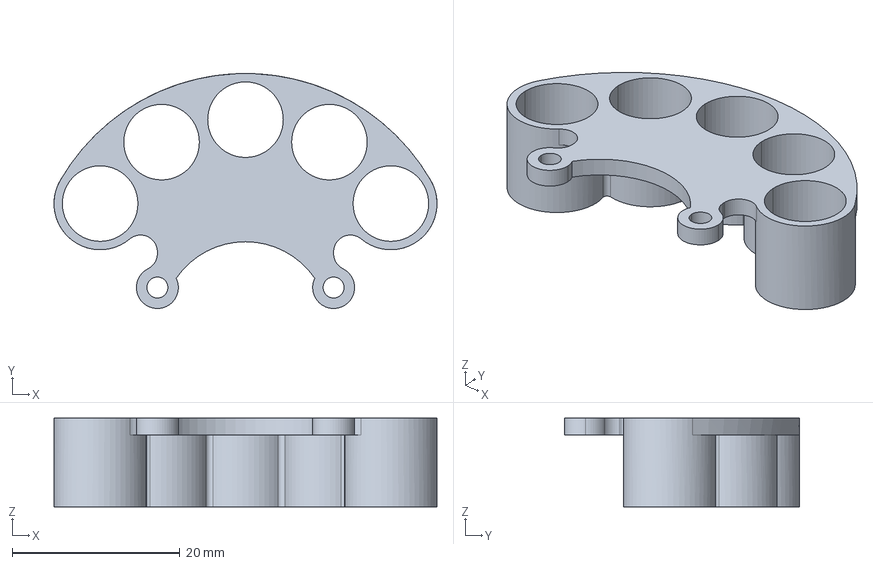
[picture p49: CAD file, 2020-05-02]
cnc/Lichtschutz/Spacer_Ziffernblatt_V2_Patrick_2012-09-02.stp
45.6 x 28.0 x 10.6 mm
