PhilippSchmaelzle/speedoino/cnc/Scheibe/28_10_2012/2012_10_28_Scheibe_2D.dxf

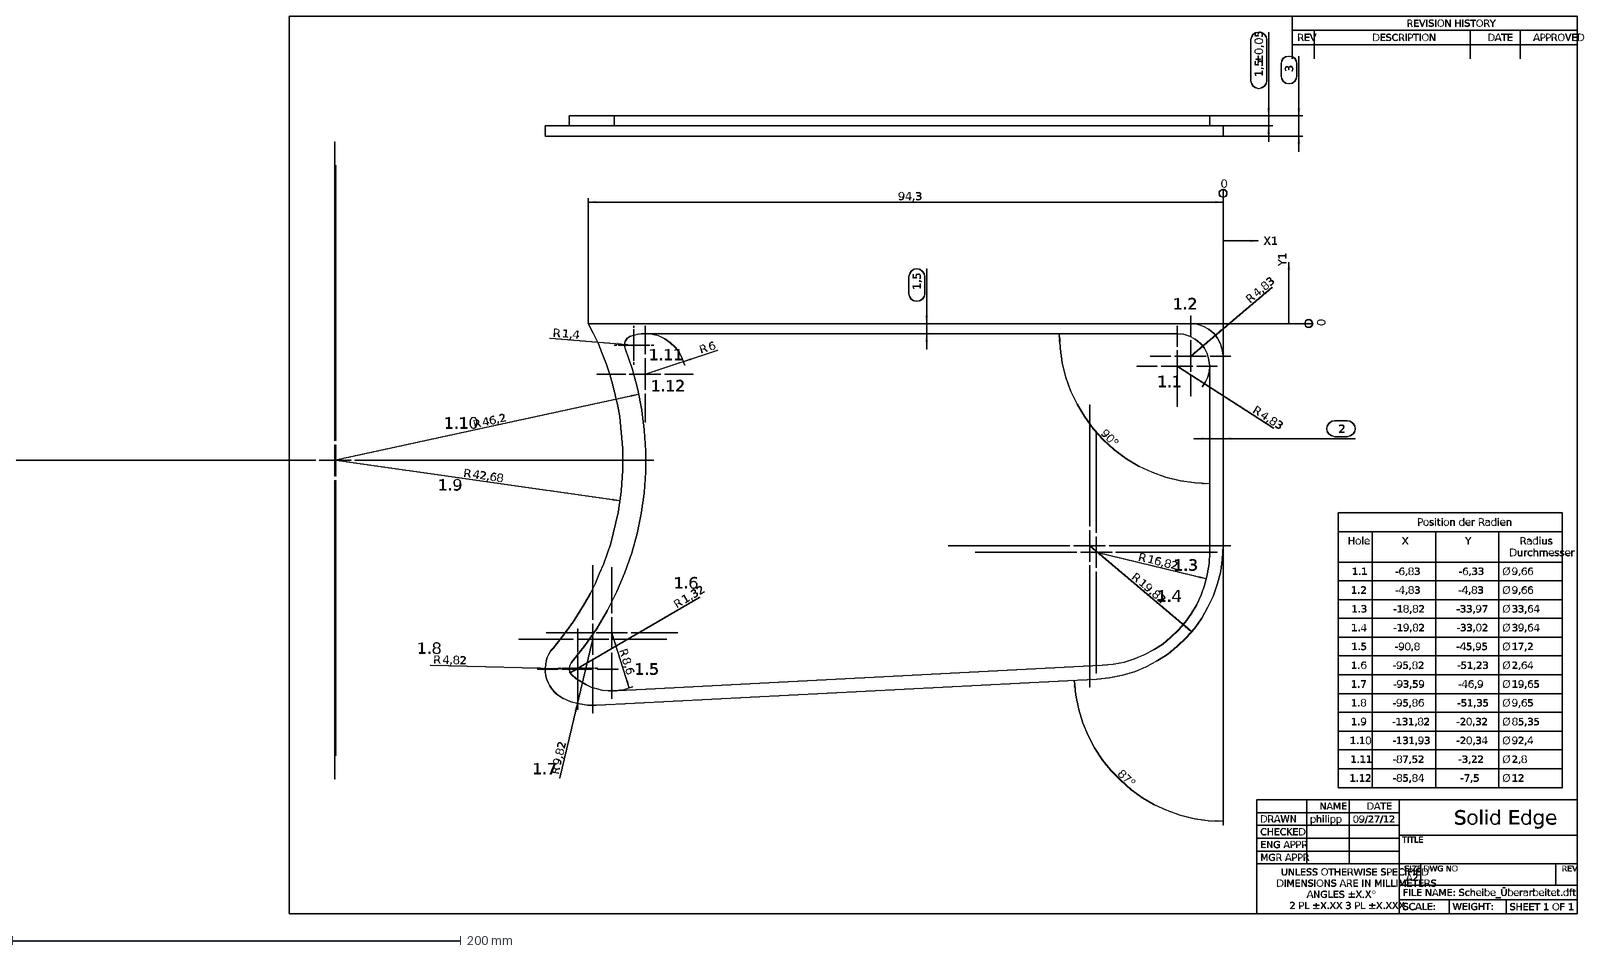
[picture p50: CAD file, 2020-05-02]
cnc/Scheibe/28_10_2012/2012_10_28_Scheibe_2D.dxf
1.1
1.2
1.3
1.4
1.5
1.6
1.7
1.8
1.9
1.10
1.11
1.12
3
1,5
±0,05
0
94,3
R
16,82
19,82
8,6
1,32
46,2
42,68
4,82
9,82
90°
X1
Y1
Position der Radien
Hole
X
Y
Radius
Durchmesser
-6,83
-6,33
Ø
9,66
-4,83
-18,82
-33,97
33,64
-19,82
-33,02
39,64
-90,8
-45,95
17,2
-95,82
-51,23
2,64
-93,59
-46,9
19,65
-95,86
-51,35
9,65
-131,82
-20,32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
