PhilippSchmaelzle/speedoino/cnc/Oberteil/old/Oberteil_prototyp02_2012_01_10_Patrick.stp

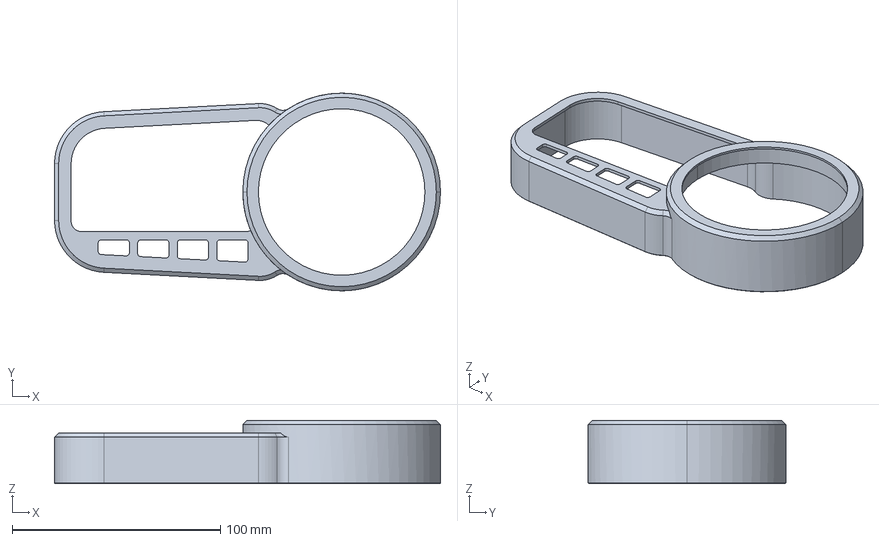
[picture p51: CAD file, 2020-05-02, an earlier design]
cnc/Oberteil/old/Oberteil_prototyp02_2012_01_10_Patrick.stp
185.5 x 95.0 x 30.3 mm
