PhilippSchmaelzle/speedoino/cnc/Taster/old/Taster_Gussform.stp

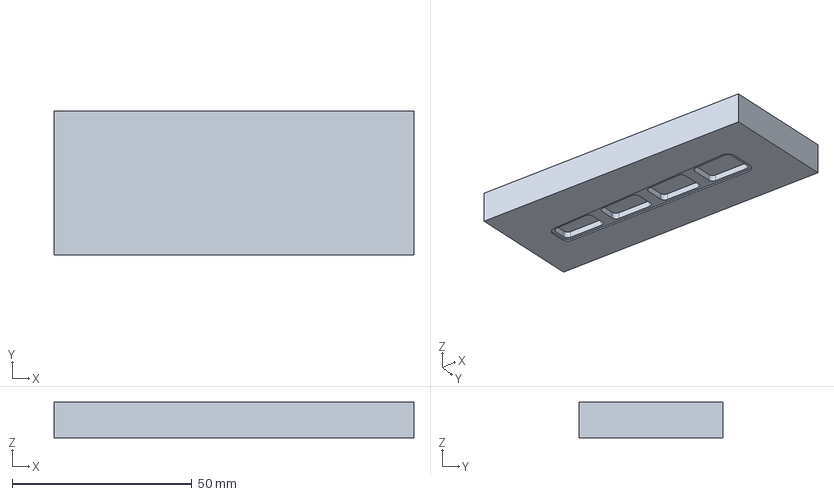
[picture p52: CAD file, 2020-05-02, an earlier design]
cnc/Taster/old/Taster_Gussform.stp
100.0 x 40.0 x 10.0 mm
