PhilippSchmaelzle/speedoino/cnc/Unterteil/old/Unterteil_prototyp02_2012_01_10.stp

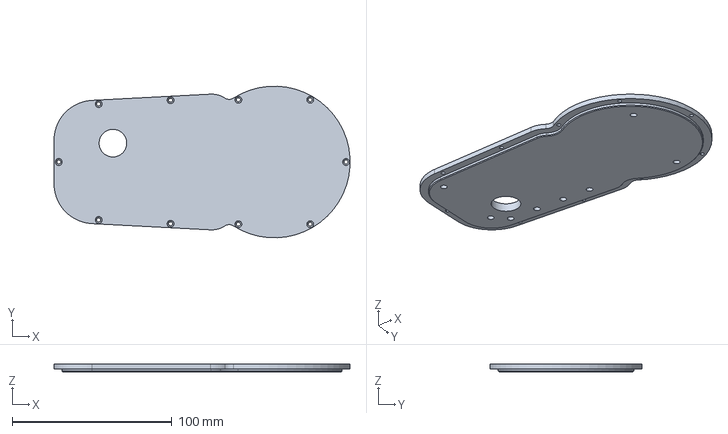
[picture p53: CAD file, 2020-05-02, an earlier design]
cnc/Unterteil/old/Unterteil_prototyp02_2012_01_10.stp
185.4 x 94.9 x 5.00 mm
