PhilippSchmaelzle/speedoino/(list of files, cad)

Other CAD files:
cnc/Scheibe/28_10_2012/2012_10_28_Scheibe.stp
cnc/Scheibe/02_06_2012/Scheibe 0_35mm kleiner.SLDPRT
cnc/Scheibe/old/Display_Scheibe_20111229.stl
cnc/Oberteil/old/Oberteil_prototyp02_2012_01_16.stp
cnc/Scheibe/old/Scheibe_gespiegelt.STEP
cnc/Oberteil/old/OBERTEIL_PROTOTYP02_2012_01_10.DXF
cnc/Oberteil/old/Scheibe_Prototyp_02_2012_01_25.CATPart
cnc/Scheibe/02_06_2012/Scheibe 0_35mm kleiner.DXF
cnc/Scheibe/28_10_2012/2012_10_28_Scheibe.igs
cnc/Scheibe/28_10_2012/2012_10_28_Scheibe_2D.dwg
cnc/Scheibe/old/Display_Scheibe_20111220.stl
cnc/Scheibe/old/Scheibe_Prototyp_02_2012_01_25.stp
cnc/Unterteil/old/UNTERTEIL_PROTOTYP02_2012_01_10.DXF
schematics/Eagle3d/models/0402.skp
schematics/Eagle3d/models/0603.skp
schematics/Eagle3d/models/0805+603.skp
schematics/Eagle3d/models/0805.skp
schematics/Eagle3d/models/1X01.skp
schematics/Eagle3d/models/1X02.skp
schematics/Eagle3d/models/1X08.skp
schematics/Eagle3d/models/1X5_127.skp
schematics/Eagle3d/models/2X03.skp
schematics/Eagle3d/models/2X10.skp
schematics/Eagle3d/models/9Vbatt.skp
schematics/Eagle3d/models/BTM-222.skp
schematics/Eagle3d/models/C0603.skp
schematics/Eagle3d/models/C0805.skp
schematics/Eagle3d/models/C1206.skp
schematics/Eagle3d/models/CT3216.skp
schematics/Eagle3d/models/CT3528.skp
schematics/Eagle3d/models/CT6032.skp
schematics/Eagle3d/models/CT7343.skp
schematics/Eagle3d/models/DIL08.skp
schematics/Eagle3d/models/E5-6.skp
schematics/Eagle3d/models/EL-5-8X13.skp
schematics/Eagle3d/models/EL-5-8X13R.skp
schematics/Eagle3d/models/FPBGA_484.skp
schematics/Eagle3d/models/L-PD54.skp
schematics/Eagle3d/models/LED-0603.skp
schematics/Eagle3d/models/LED-0805.skp
schematics/Eagle3d/models/LED3MM.skp
schematics/Eagle3d/models/M0805.skp
schematics/Eagle3d/models/M1206.skp
schematics/Eagle3d/models/MT3329.skp
schematics/Eagle3d/models/PLCC-4.skp
schematics/Eagle3d/models/PLCC-6.skp
schematics/Eagle3d/models/R0207_10.skp
schematics/Eagle3d/models/R0603.skp
schematics/Eagle3d/models/R0805.skp
schematics/Eagle3d/models/R1206.skp
schematics/Eagle3d/models/RJ45-SCHIRM.skp
schematics/Eagle3d/models/SIP3.skp
schematics/Eagle3d/models/SMA-H.skp
schematics/Eagle3d/models/SMB.skp
schematics/Eagle3d/models/SMD_DRUCKTASTER.skp
schematics/Eagle3d/models/SMD_SMT_6.6_6.6.skp
schematics/Eagle3d/models/SO-16.skp
schematics/Eagle3d/models/SO08-150.skp
schematics/Eagle3d/models/SO08.skp
schematics/Eagle3d/models/SO08W.skp
schematics/Eagle3d/models/SO10.skp
schematics/Eagle3d/models/SO12.skp
schematics/Eagle3d/models/SO14.skp
schematics/Eagle3d/models/SO14W.skp
schematics/Eagle3d/models/SO16.skp
schematics/Eagle3d/models/SO16W.skp
schematics/Eagle3d/models/SO18W.skp
schematics/Eagle3d/models/SO20W.skp
schematics/Eagle3d/models/SO22W.skp
schematics/Eagle3d/models/SO24W.skp
schematics/Eagle3d/models/SO26W.skp
schematics/Eagle3d/models/SO28W.skp
schematics/Eagle3d/models/SOD123.skp
schematics/Eagle3d/models/SOD80.skp
schematics/Eagle3d/models/SOT-23-6.skp
schematics/Eagle3d/models/SOT-23.skp
schematics/Eagle3d/models/SOT223.skp
schematics/Eagle3d/models/SOT23-5L.skp
schematics/Eagle3d/models/SOT23-6.skp
schematics/Eagle3d/models/SOT23.skp
schematics/Eagle3d/models/SOT89.skp
schematics/Eagle3d/models/SSOP28.skp
schematics/Eagle3d/models/STEPPER.skp
schematics/Eagle3d/models/SW-ECO.skp
schematics/Eagle3d/models/Soapbox.skp
schematics/Eagle3d/models/TO252.skp
schematics/Eagle3d/models/TO92.skp
schematics/Eagle3d/models/TQFP-32_7X7.skp
schematics/Eagle3d/models/TQFP100.skp
schematics/Eagle3d/models/TSOP-54.skp
schematics/Eagle3d/models/TSSOP08.skp
schematics/Eagle3d/models/TSSOP10.skp
schematics/Eagle3d/models/TSSOP14.skp
schematics/Eagle3d/models/TSSOP16.skp
schematics/Eagle3d/models/TSSOP18.skp
schematics/Eagle3d/models/TSSOP20.skp
schematics/Eagle3d/models/TSSOP22.skp
schematics/Eagle3d/models/TSSOP24.skp
schematics/Eagle3d/models/TSSOP26.skp
schematics/Eagle3d/models/TSSOP28.skp
schematics/Eagle3d/models/USB_MINIB_HOLE.skp
