PhilippSchmaelzle/speedoino/cnc/Scheibe/28_10_2012/2012_10_28_Scheibe_2D_2.pdf

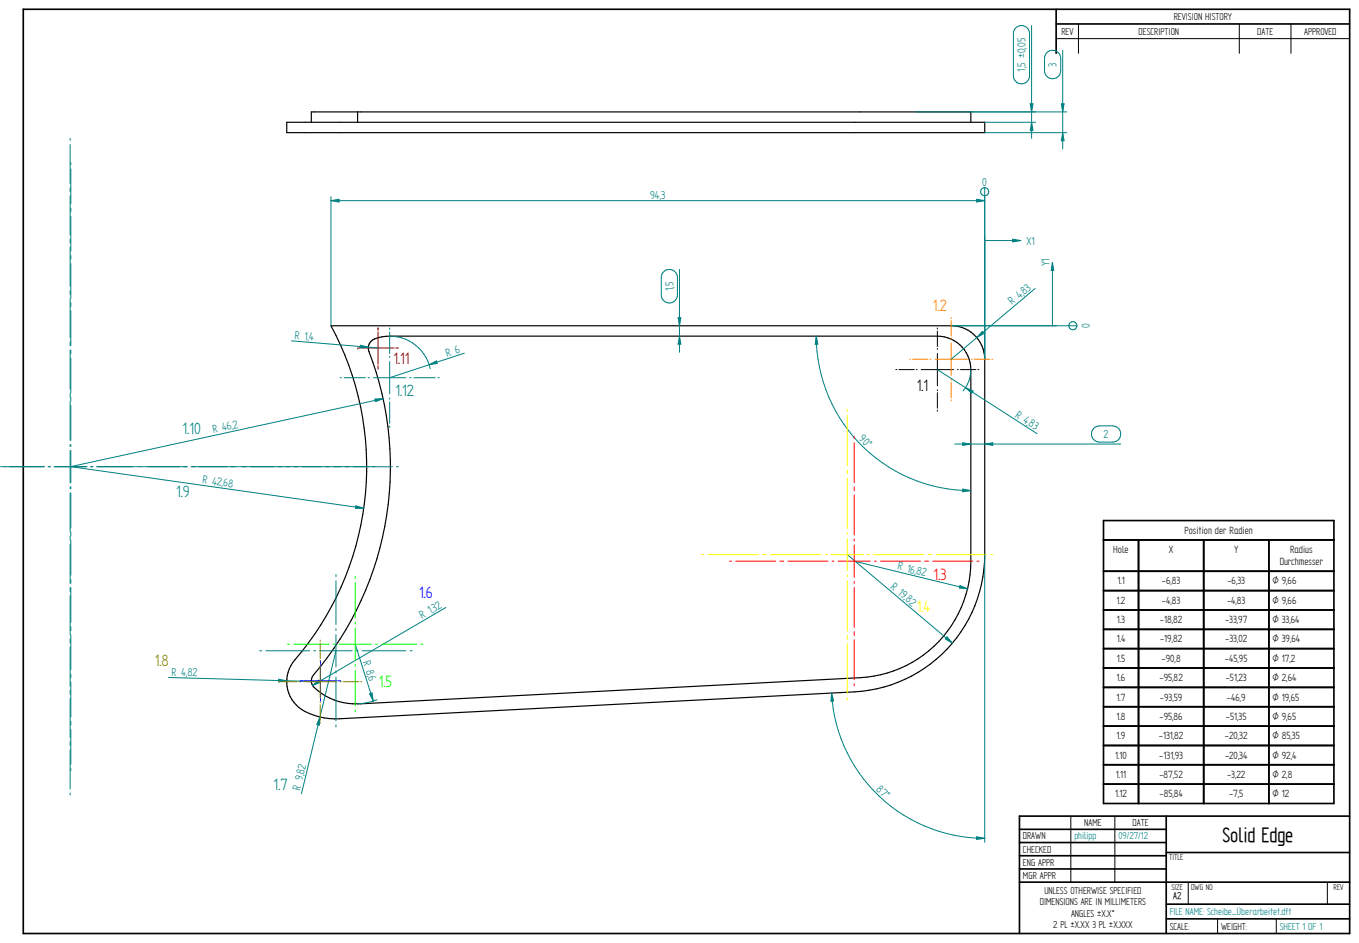
[picture p54: page 1]
TITLE; SCALE:; WEIGHT:; SHEET 1 OF 1

REVISION HISTORY

REV | DESCRIPTION | DATE | APPROVED

Position der Radien

Hole | X | Y | Radius Durchmesser

1.1 | -6,83 | -6,33 | Ø 9,66
1.2 | -4,83 | -4,83 | Ø 9,66
1.3 | -18,82 | -33,97 | Ø 33,64
1.4 | -19,82 | -33,02 | Ø 39,64
1.5 | -90,8 | -45,95 | Ø 17,2
1.6 | -95,82 | -51,23 | Ø 2,64
1.7 | -93,59 | -46,9 | Ø 19,65
1.8 | -95,86 | -51,35 | Ø 9,65
1.9 | -131,82 | -20,32 | Ø 85,35
1.10 | -131,93 | -20,34 | Ø 92,4
1.11 | -87,52 | -3,22 | Ø 2,8
1.12 | -85,84 | -7,5 | Ø 12

NAME | DATE | Solid Edge

DRAWN | philipp | 09/27/12
CHECKED
ENG APPR
MGR APPR
UNLESS OTHERWISE SPECIFIED DIMENSIONS ARE IN MILLIMETERS ANGLES ±X.X° 2 PL ±X.XX 3 PL ±X.XXX | SIZE A2 | DWG NO | REV

FILE NAME: Scheibe_Überarbeitet.dft
