PhilippSchmaelzle/speedoino/pub/JKW_standalone.pdf

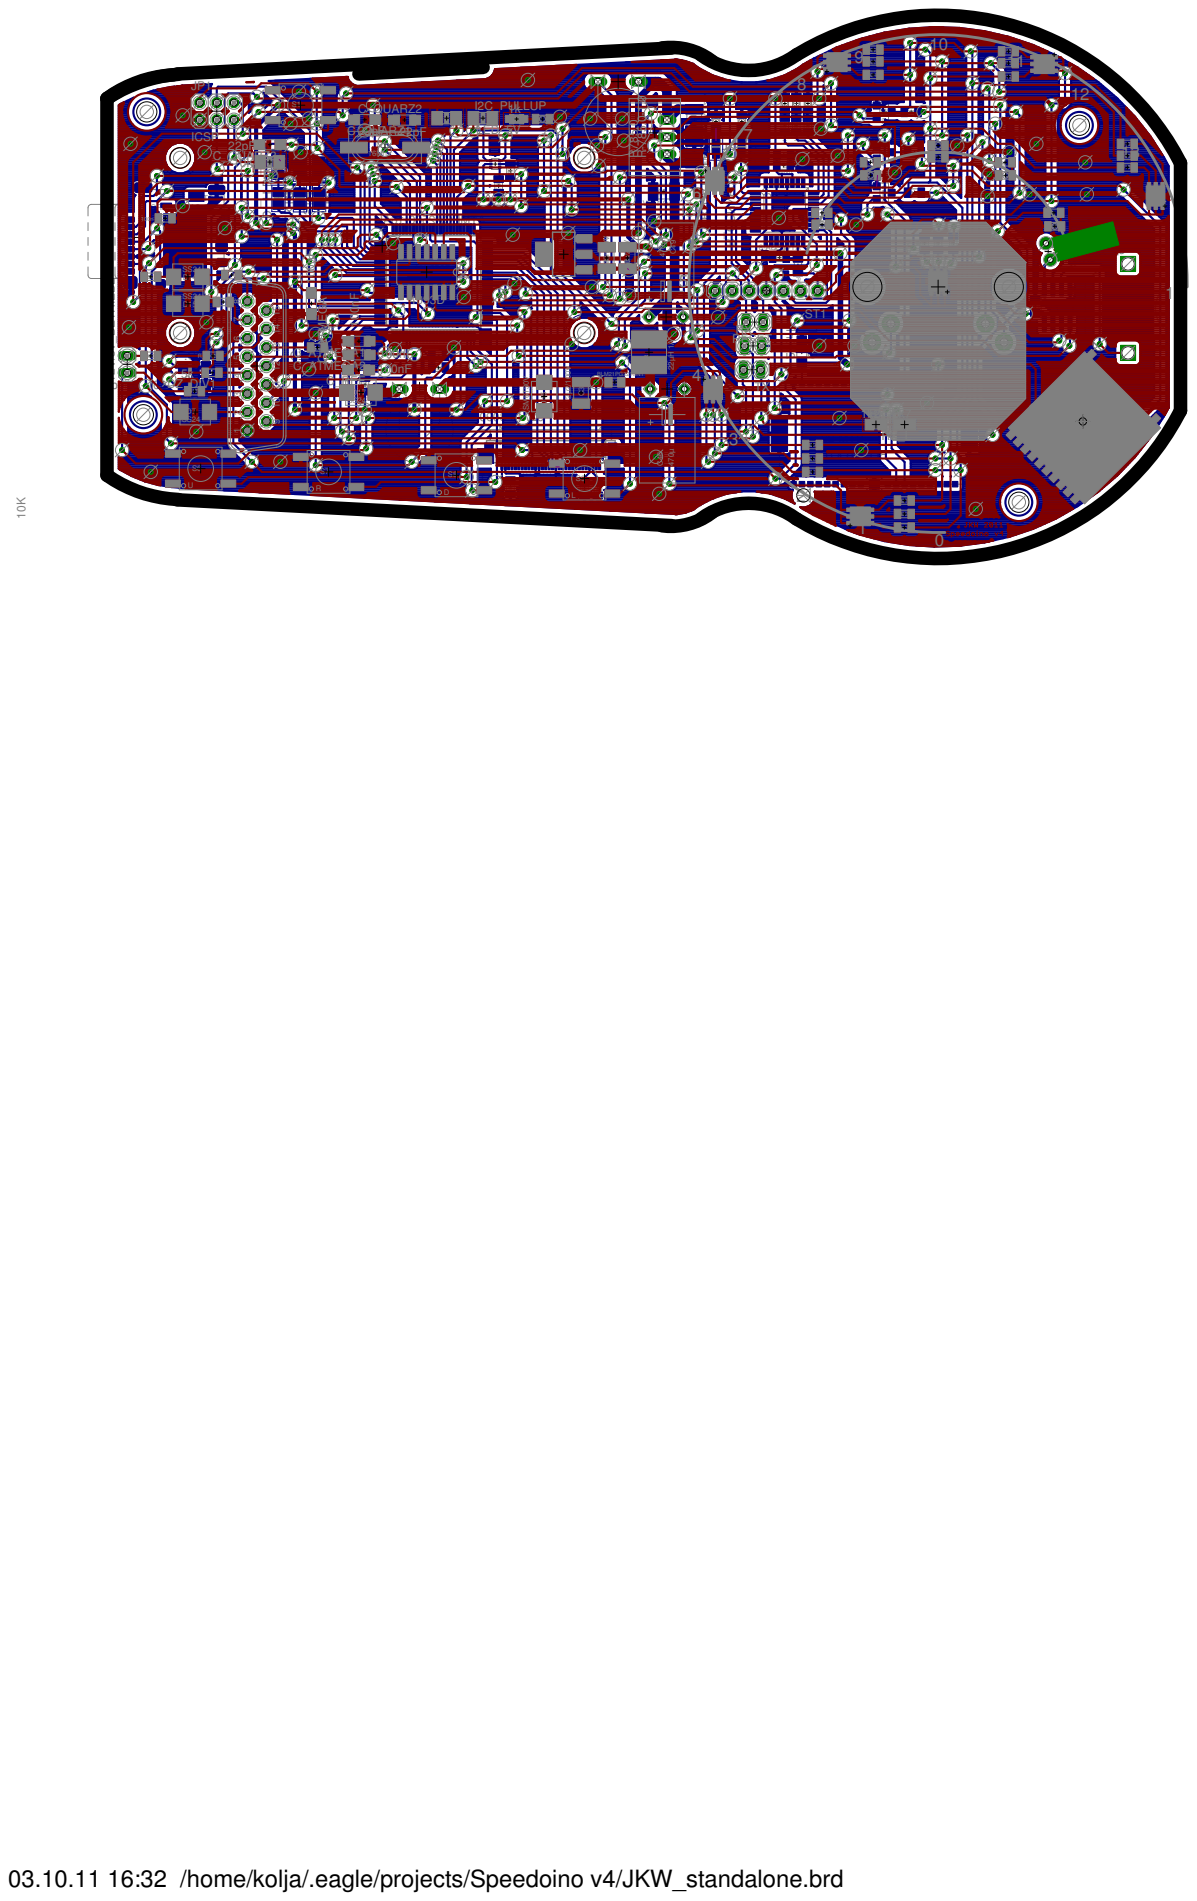
[picture p55: page 1]

03.10.11 16:32 /home/kolja/.eagle/projects/Speedoino v4/JKW_standalone.brd
