PhilippSchmaelzle/speedoino/schematics/alte_designs/v6/v6.brd

## EAGLE design schematics/alte_designs/v6/v6.brd (2020-05-02, an earlier design)

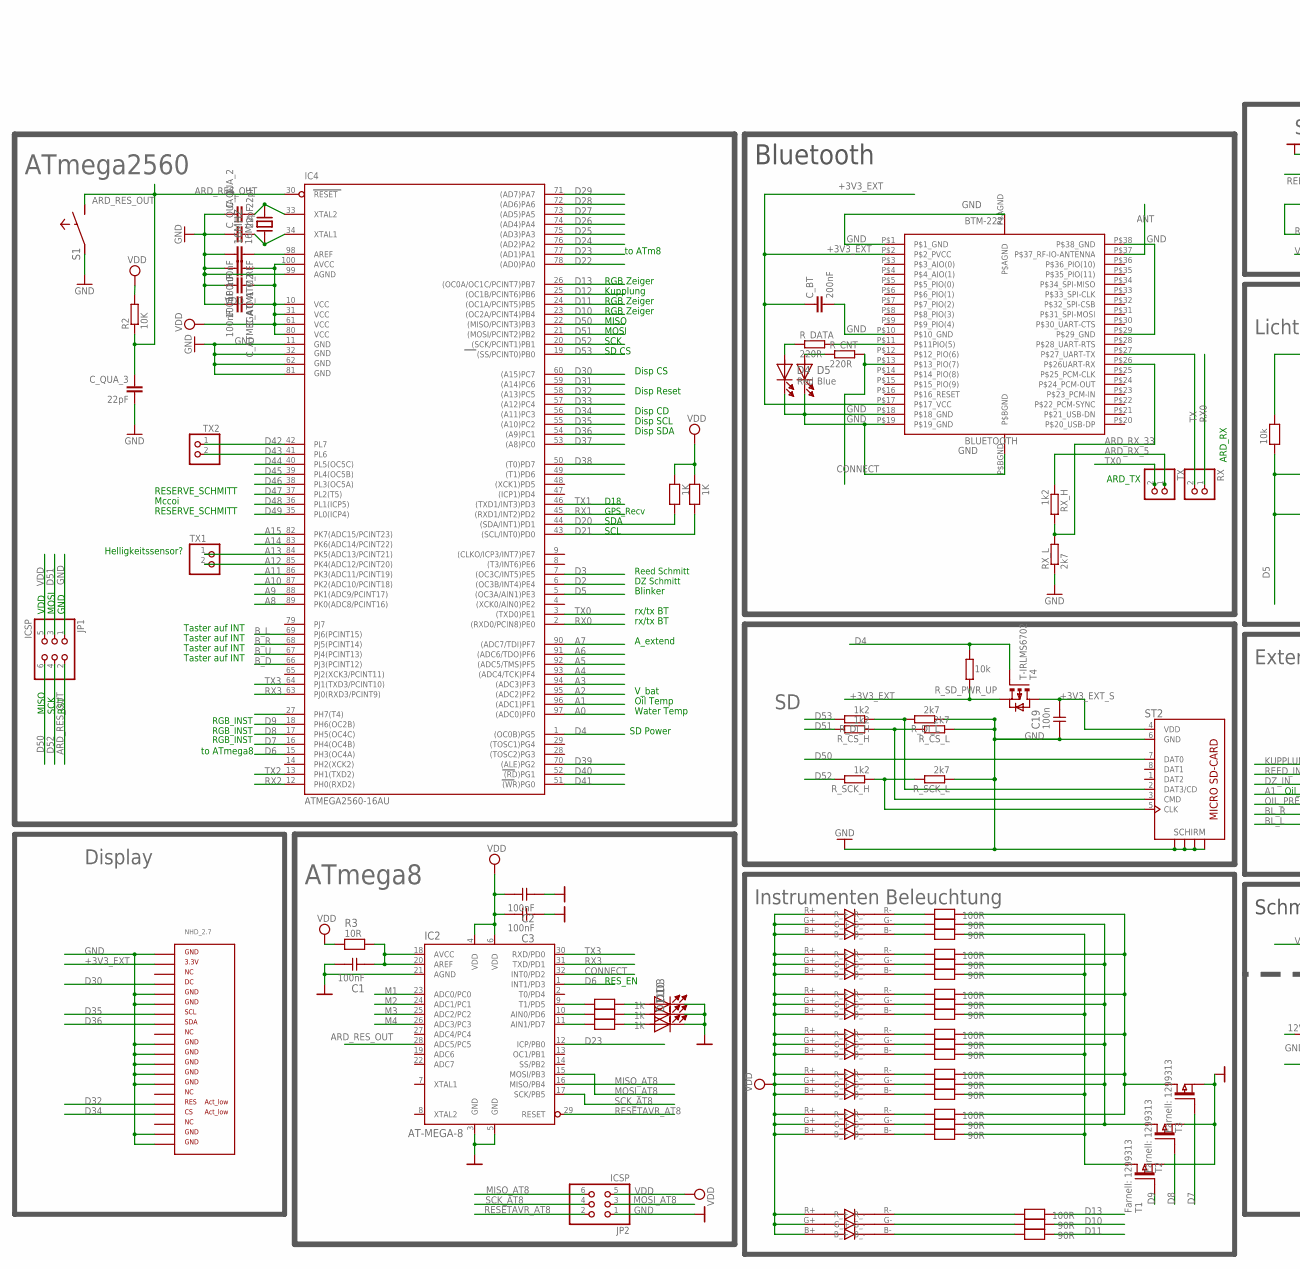
[picture p56: schematic v6.sch, part in row 1, column 1]

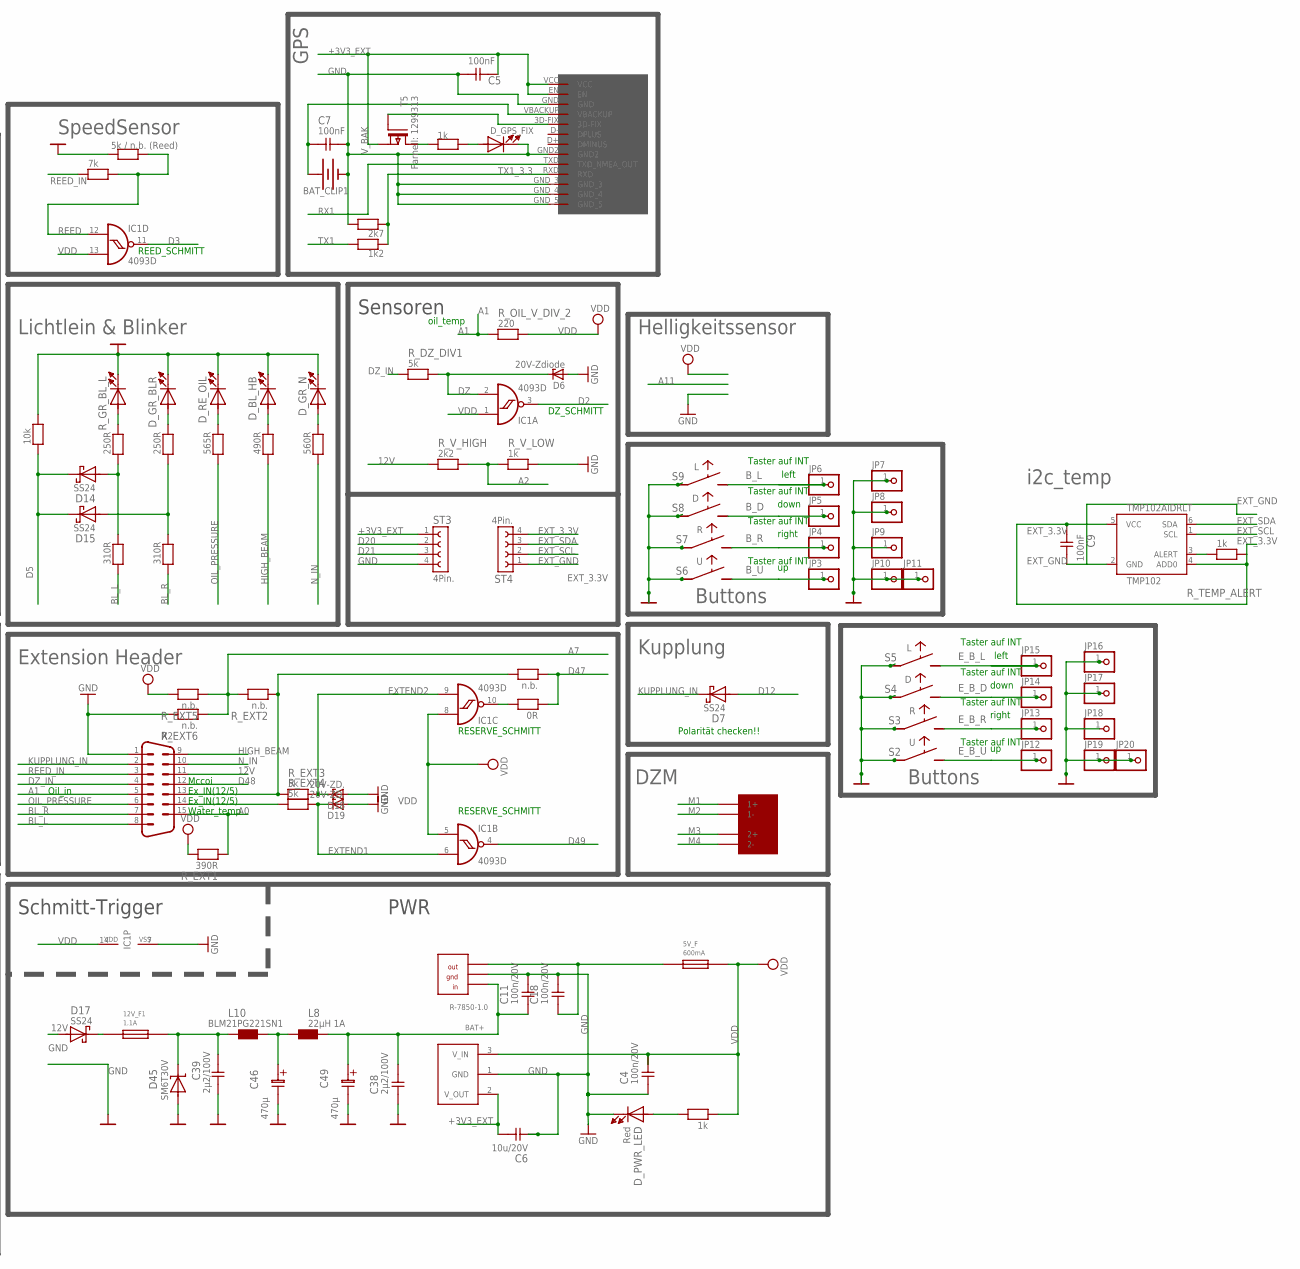
[picture p57: schematic v6.sch, part in row 1, column 2]

Parts:
5V_F: 600mA; POLY_FUSE
12V_F1: 1.1A; POLY_FUSE
16MHZ: 16Mhz; XT-HC49S-SMD
18632422: RGB_LED
BAT_CLIP1: F_908642; BATTCON_12MM
BLUETOOTH: BTM-222
C1, C2, C3, C5, C7, C9: 100nF; 0805
C4, C11, C18: 100n/20V; 0805
C6: 10u/20V; 0805
C19: 100n; 0805
C38, C39: 2µ2/100V; 0805
C46: 470µ; EL-5-8X13R
C49: 470µ; EL-5-8X13
C_ATM1, C_ATM2: 100nF; C0805
C_ATMEGA: 100nF; C0805
C_BT: 200nF; C0805
C_QUA_1, C_QUA_2, C_QUA_3: 22pF; C0805
C_REF: 100nF; C0805
D3, D10, D11: LED0805; LED-0805
D4: Red; LED-0805
D5: Blue; LED-0805
D6: 20V-Zdiode; SMB
D7, D14, D15, D17: SS24; SMB
D18, D19: 20V-ZD.; SMB
D45: SM6T30V; SMB
DCDC53.3: AP1117E33G; SOT223
D_BL_HB: HighB _ 645-598-8191-107F; LED-0805
D_GPS_FIX: Red; LED-0805
D_GR_BLR: BL_R; LED-0805
D_GR_N: N _ M 645-598-8110-107F; LED-0805
D_PWR_LED: Red; LED-0805
D_RE_OIL: OIL M 645-598-8110-107F; LED-0805
GPS: MT3329
IC1: 4093D; SO14
IC2: AT-MEGA-8; TQFP-32_7X7
IC4: ATMEGA2560-16AU; TQFP100
JP1, JP2: ICSP; 2X03
JP3, JP4, JP5, JP6, JP7, JP8, JP9, JP10, JP11, JP12, JP13, JP14, JP15, JP16, JP17, JP18, JP19, JP20: PINHD-1X1; 1X01
L8: 22µH 1A; L-PD54
L10: BLM21PG221SN1; 0805+603
NHD_2.7: NHD_2.7_SOLO_RO
PWR_R78: R-7805-1.0; SIP3
R1, R4: 250R; 0805
R2: 10K; R0805
R3: 10R; 0805
R5: 565R; 0805
R6: 490R; 0805
R7, R8: 310R; 0805
R9: 10k; 0805
R10: 5k / n.b. (Reed); 0805
R11: 7k; 0805
R12, R18, R21, R24, R29, R32, R35: 100R; 0805
R13, R14, R19, R20, R22, R23, R25, R26, R30, R31, R33, R34, R36, R37: 90R; 0805
R15, R16, R17, R28: 1k; 0805
R27: 560R; 0805
R38: 0R; 0805
R39: n.b.; 0805
R40: 2k7; 0805
R41: 1k2; 0805
RX: PINHD-1X2; 1X02
RX_H: 1k2; M0805
RX_L: 2k7; M0805
R_CNT: 220R; M0805
R_CS_H: 1k2; M0805
R_CS_L: 2k7; M0805
R_DATA: 220R; M0805
R_DI_H: 1k2; M0805
R_DI_L: 2k7; M0805
R_DZ_DIV1: 5k; 0805
R_EXT1: 390R; 0805
R_EXT2, R_EXT5, R_EXT6: n.b.; 0805
R_EXT3, R_EXT4: 5k; 0805
R_GR_BL_L: BL_L; LED-0805
R_LED_5V: 1k; 0805
R_OIL_V_DIV_2: 220; 0805
R_SCK_H: 1k2; M0805
R_SCK_L: 2k7; M0805
R_SCL_UP: 1K; 0805
R_SDA_UP: 1K; 0805
R_SD_PWR_UP: 10k; M0805
R_TEMP_ALERT: 1k; 0805
R_V_HIGH: 2k2; 0805
R_V_LOW: 1k; 0805
S1: SW-TASTERECO-DIAGONAL; SW-ECO
S2, S6: U; SW-ECO
S3, S7: R; SW-ECO
S4, S8: D; SW-ECO
S5, S9: L; SW-ECO
ST2: SD_MICRO
ST3, ST4: BU_1X4_BL17-SMD; BL17SMD_1X4
T1, T2, T3, T5: Farnell: 1299313; SOT-23
T4: T-IRLMS6702; SOT-23-6
TMP102AIDRLT: TMP102; SOT563
TX, TX1, TX2: PINHD-1X2; 1X02
U$3: STEPPER
U$14, U$15, U$16, U$18, U$19, U$20: RGB_LED
X2: SUB-D-IP67; IP67-SUB-D

Connections:
12V: D17.A, R_V_HIGH.1, X2.11
12V_SAFE: 12V_F1.P$2, C39.1, D45.K, L10.1
+3V3_EXT: BLUETOOTH.P$2 (P$2_PVCC), BLUETOOTH.P$17 (P$17_VCC), C5.2, C6.2, C_BT.1, DCDC53.3.2 (V_OUT), GPS.EN, GPS.VCC, NHD_2.7.VDD0 (VDD), R_SD_PWR_UP.2, ST3.1, T4.4 (S), T5.2 (S)
+3V3_EXT_S: C19.2, ST2.4 (VDD), T4.1 (D1), T4.2 (D2), T4.5 (D3), T4.6 (D4)
A0: IC4.97 ((ADC0)PF0), R_EXT1.1, X2.15
A1: IC4.96 ((ADC1)PF1), R_OIL_V_DIV_2.1, X2.5
A2: IC4.95 ((ADC2)PF2), R_V_HIGH.2, R_V_LOW.1
A3: IC4.94 ((ADC3)PF3)
A4: IC4.93 ((ADC4/TCK)PF4)
A5: IC4.92 ((ADC5/TMS)PF5)
A6: IC4.91 ((ADC6/TDO)PF6)
A7: IC4.90 ((ADC7/TDI)PF7), R_EXT2.2, R_EXT5.1, R_EXT6.1
A8: IC4.89 (PK0(ADC8/PCINT16))
A9: IC4.88 (PK1(ADC9/PCINT17))
A10: IC4.87 (PK2(ADC10/PCINT18))
A11: IC4.86 (PK3(ADC11/PCINT19))
A12: IC4.85 (PK4(ADC12/PCINT20)), TX1.2
A13: IC4.84 (PK5(ADC13/PCINT21)), TX1.1
A14: IC4.83 (PK6(ADC14/PCINT22))
A15: IC4.82 (PK7(ADC15/PCINT23))
ANT: BLUETOOTH.P$37 (P$37_RF-IO-ANTENNA)
ARD_RES_OUT: C_QUA_3.1, IC2.28 (ADC5/PC5), IC4.30 (RESET), JP1.2, R2.1, S1.4 (2)
ARD_RX_5: RX_H.1, TX.1
ARD_RX_33: BLUETOOTH.P$26 (P$26UART-RX), RX_H.2, RX_L.2
BAT+: C11.1, C38.2, C49.1, L8.2, PWR_R78.IN
BLUE_INSTR: R14.2, R20.2, R23.2, R31.2, R34.2, R37.2, T1.3 (D)
BL_L: R8.1, X2.8
BL_R: R7.1, X2.7
B_D: IC4.66 (PJ3(PCINT12)), JP5.1, S8.4 (2)
B_L: IC4.69 (PJ6(PCINT15)), JP6.1, S9.4 (2)
B_R: IC4.68 (PJ5(PCINT14)), JP4.1, S7.4 (2)
B_U: IC4.67 (PJ4(PCINT13)), JP3.1, S6.4 (2)
CONNECT: BLUETOOTH.P$13 (P$13_PIO(7)), IC2.32 (INT0/PD2), R_CNT.2
D2: IC1.3 (O), IC4.6 ((OC3B/INT4)PE4)
D3: IC1.11 (O), IC4.7 ((OC3C/INT5)PE5)
D4: IC4.1 ((OC0B)PG5), R_SD_PWR_UP.1, T4.3 (G)
D5: D14.K, D15.K, IC4.5 ((OC3A/AIN1)PE3), R9.2
D6: IC2.1 (INT1/PD3), IC4.15 (PH3(OC4A))
D7: IC4.16 (PH4(OC4B)), T3.1 (G)
D8: IC4.17 (PH5(OC4C)), T2.1 (G)
D9: IC4.18 (PH6(OC2B)), T1.1 (G)
D10: IC4.23 ((OC2A/PCINT4)PB4), R25.2
D11: IC4.24 ((OC1A/PCINT5)PB5), R26.2
D12: D7.A, IC4.25 ((OC1B/PCINT6)PB6)
D13: IC4.26 ((OC0A/OC1C/PCINT7)PB7), R24.2
D20: IC4.44 ((SDA/INT1)PD1), R_SDA_UP.2, ST3.2
D21: IC4.43 ((SCL/INT0)PD0), R_SCL_UP.2, ST3.3
D22: IC4.78 ((AD0)PA0)
D23: IC2.12 (ICP/PB0), IC4.77 ((AD1)PA1)
D24: IC4.76 ((AD2)PA2)
D25: IC4.75 ((AD3)PA3)
D26: IC4.74 ((AD4)PA4)
D27: IC4.73 ((AD5)PA5)
D28: IC4.72 ((AD6)PA6)
D29: IC4.71 ((AD7)PA7)
D30: IC4.60 ((A15)PC7), NHD_2.7.DC
D31: IC4.59 ((A14)PC6)
D32: IC4.58 ((A13)PC5), NHD_2.7.RES
D33: IC4.57 ((A12)PC4)
D34: IC4.56 ((A11)PC3), NHD_2.7.CS
D35: IC4.55 ((A10)PC2), NHD_2.7.SCLK (SCL)
D36: IC4.54 ((A9)PC1), NHD_2.7.SDIN (SDA)
D37: IC4.53 ((A8)PC0)
D38: IC4.50 ((T0)PD7)
D39: IC4.70 ((ALE)PG2)
D40: IC4.52 ((RD)PG1)
D41: IC4.51 ((WR)PG0)
D42: IC4.42 (PL7), TX2.1
D43: IC4.41 (PL6), TX2.2
D44: IC4.40 (PL5(OC5C))
D45: IC4.39 (PL4(OC5B))
D46: IC4.38 (PL3(OC5A))
D47: IC4.37 (PL2(T5)), R38.2, R39.2
D48: IC4.36 (PL1(ICP5)), X2.12
D49: IC1.4 (O), IC4.35 (PL0(ICP4))
D50: IC4.22 ((MISO/PCINT3)PB3), JP1.6, ST2.7 (DAT0)
D51: IC4.21 ((MOSI/PCINT2)PB2), JP1.3, R_CS_H.2
D52: IC4.20 ((SCK/PCINT1)PB1), JP1.4, R_SCK_H.2
D53: IC4.19 ((SS/PCINT0)PB0), R_DI_H.2
DZ: D6.C, IC1.2 (I1), R_DZ_DIV1.2
DZ_IN: R_DZ_DIV1.1, X2.4
EXTEND1: D19.C, IC1.6 (I1), R_EXT4.2
EXTEND2: D18.C, IC1.9 (I1), R_EXT3.2
EXT_3.3V: C9.1, R_TEMP_ALERT.2, ST4.4, TMP102AIDRLT.4 (ADD0), TMP102AIDRLT.5 (VCC)
EXT_GND: C9.2, ST4.1, TMP102AIDRLT.2 (GND)
EXT_SCL: ST4.2, TMP102AIDRLT.1 (SCL)
EXT_SDA: ST4.3, TMP102AIDRLT.6 (SDA)
E_B_D: JP14.1, S4.4 (2)
E_B_L: JP15.1, S5.4 (2)
E_B_R: JP13.1, S3.4 (2)
E_B_U: JP12.1, S2.4 (2)
E_GND: JP16.1, JP17.1, JP18.1, JP19.1, JP20.1, S2.1, S3.1, S4.1, S5.1
GND: BAT_CLIP1.GND (-), BLUETOOTH.P$1 (P$1_GND), BLUETOOTH.P$10 (P$10_GND), BLUETOOTH.P$18 (P$18_GND), BLUETOOTH.P$19 (P$19_GND), BLUETOOTH.P$29 (P$29_GND), BLUETOOTH.P$38 (P$38_GND), BLUETOOTH.P$AGND, BLUETOOTH.P$BGND, C1.2, C2.1, C3.1, C4.1, C5.1, C6.1, C7.2, C11.2, C18.2, C19.1, C38.1, C39.2, C46.2, C49.2, C_ATM1.2, C_ATM2.2, C_ATMEGA.2, C_BT.2, C_QUA_1.1, C_QUA_2.1, C_QUA_3.2, C_REF.2, D3.2 (K), D4.2 (K), D5.2 (K), D6.A, D10.2 (K), D11.2 (K), D18.A, D19.A, D45.A, DCDC53.3.1 (GND), D_BL_HB.2 (K), D_GPS_FIX.2 (K), D_GR_BLR.2 (K), D_GR_N.2 (K), D_PWR_LED.2 (K), D_RE_OIL.2 (K), GPS.GND, GPS.GND2, GPS.GND_3, GPS.GND_4, GPS.GND_5, IC1.7 (VSS), IC2.3 (GND), IC2.5 (GND), IC2.21 (AGND), IC4.11 (GND), IC4.32 (GND1), IC4.62 (GND2), IC4.81 (GND3), IC4.99 (AGND), JP1.1, JP2.1, JP7.1, JP8.1, JP9.1, JP10.1, JP11.1, NHD_2.7.GND0 (GND), NHD_2.7.GND1 (GND2), NHD_2.7.GND2 (GND3), NHD_2.7.GND3 (GND4), NHD_2.7.GND4 (GND5), NHD_2.7.GND5 (GND6), NHD_2.7.GND6 (GND7), NHD_2.7.GND7 (GND8), NHD_2.7.GND8 (GND9), NHD_2.7.GND9 (GND10), PWR_R78.GND, R9.1, R10.2, R40.2, RX_L.1, R_CS_L.1, R_DI_L.1, R_EXT6.2, R_GR_BL_L.2 (K), R_SCK_L.1, R_V_LOW.2, S1.1, S6.1, S7.1, S8.1, S9.1, ST2.6 (GND), ST2.GND (SCHIRM1), ST2.GND2 (SCHIRM2), ST2.GND3 (SCHIRM3), ST2.GND4 (SCHIRM), ST3.4, T1.2 (S), T2.2 (S), T3.2 (S), X2.1
GREEN_INSTR: R13.2, R19.2, R22.2, R30.2, R33.2, R36.2, T2.3 (D)
HIGH_BEAM: R6.1, X2.9
KUPPLUNG_IN: D7.K, X2.2
M1: IC2.23 (ADC0/PC0), U$3.1+
M2: IC2.24 (ADC1/PC1), U$3.1-
M3: IC2.25 (ADC2/PC2), U$3.2+
M4: IC2.26 (ADC3/PC3), U$3.2-
MISO_AT8: IC2.16 (MISO/PB4), JP2.6
MOSI_AT8: IC2.15 (MOSI/PB3), JP2.3
unnamed: C46.1, L8.1, L10.2
unnamed: D14.A, R1.1, R8.2
unnamed: C1.1, IC2.18 (AVCC), IC2.20 (AREF), R3.2
unnamed: R_TEMP_ALERT.1, TMP102AIDRLT.3 (ALERT)
unnamed: D5.1 (A), R_CNT.1
unnamed: R31.1, U$18.B- (B_-)
unnamed: R30.1, U$18.G- (G_-)
unnamed: R29.1, U$18.R- (R_-)
unnamed: D_PWR_LED.1 (A), R_LED_5V.2
unnamed: R34.1, U$16.B- (B_-)
unnamed: D15.A, R4.1, R7.2
unnamed: D4.1 (A), R_DATA.1
unnamed: R_CS_H.1, R_CS_L.2, ST2.3 (CMD)
unnamed: IC2.11 (AIN1/PD7), R17.1
unnamed: D_GPS_FIX.1 (A), R28.2
unnamed: GPS.3D-FIX, T5.1 (G)
unnamed: R28.1, T5.3 (D)
unnamed: IC2.10 (AIN0/PD6), R16.1
unnamed: 5V_F.P$1, C18.1, PWR_R78.OUT
unnamed: IC2.9 (T1/PD5), R15.1
unnamed: R33.1, U$16.G- (G_-)
unnamed: R32.1, U$16.R- (R_-)
unnamed: R_SCK_H.1, R_SCK_L.2, ST2.5 (CLK)
unnamed: 12V_F1.P$1, D17.K
unnamed: R_DI_H.1, R_DI_L.2, ST2.2 (DAT3/CD)
unnamed: R37.1, U$14.B- (B_-)
unnamed: R36.1, U$14.G- (G_-)
unnamed: R35.1, U$14.R- (R_-)
unnamed: R1.2, R_GR_BL_L.1 (A)
unnamed: D_GR_BLR.1 (A), R4.2
unnamed: 16MHZ.2, C_QUA_2.2, IC4.33 (XTAL2)
unnamed: 16MHZ.1, C_QUA_1.2, IC4.34 (XTAL1)
unnamed: C_REF.1, IC4.98 (AREF)
unnamed: D_RE_OIL.1 (A), R5.2
unnamed: D_BL_HB.1 (A), R6.2
unnamed: IC1.10 (O), R38.1
unnamed: R12.1, U$15.R- (R_-)
unnamed: R13.1, U$15.G- (G_-)
unnamed: R14.1, U$15.B- (B_-)
unnamed: 18632422.R- (R_-), R18.1
unnamed: 18632422.G- (G_-), R19.1
unnamed: 18632422.B- (B_-), R20.1
unnamed: R21.1, U$19.R- (R_-)
unnamed: R22.1, U$19.G- (G_-)
unnamed: R23.1, U$19.B- (B_-)
unnamed: R24.1, U$20.R- (R_-)
unnamed: R25.1, U$20.G- (G_-)
unnamed: R26.1, U$20.B- (B_-)
unnamed: D_GR_N.1 (A), R27.2
unnamed: R_EXT4.1, X2.14
unnamed: R39.1, R_EXT2.1, R_EXT3.1, X2.13
N_IN: R27.1, X2.10
OIL_PRESSURE: R5.1, X2.6
P0: D3.1 (A), R15.2
P1: D10.1 (A), R16.2
P2: D11.1 (A), R17.2
RED_INSTR: R12.2, R18.2, R21.2, R29.2, R32.2, R35.2, T3.3 (D)
REED: IC1.12 (I0), R10.1, R11.2
REED_IN: R11.1, X2.3
RESETAVR_AT8: IC2.29 (RESET), JP2.2
RX0: IC4.2 ((RXD0/PCIN8)PE0), RX.1
RX1: GPS.TXD (TXD_NMEA_OUT), IC4.45 ((RXD1/INT2)PD2)
RX2: IC4.12 (PH0(RXD2))
RX3: IC2.31 (TXD/PD1), IC4.63 (PJ0(RXD3/PCINT9))
SCK_AT8: IC2.17 (SCK/PB5), JP2.4
TO_DATA_LED: BLUETOOTH.P$11 (P$11PIO(5)), R_DATA.2
TX: BLUETOOTH.P$27 (P$27_UART-TX), RX.2
TX0: IC4.3 ((TXD0)PE1), TX.2
TX1: IC4.46 ((TXD1/INT3)PD3), R41.2
TX1_3.3: GPS.RXD, R40.1, R41.1
TX2: IC4.13 (PH1(TXD2))
TX3: IC2.30 (RXD/PD0), IC4.64 (PJ1(TXD3/PCINT10))
VDD: 5V_F.P$2, 18632422.B+ (B_+), 18632422.G+ (G_+), 18632422.R+ (R_+), C2.2, C3.2, C4.2, C_ATM1.1, C_ATM2.1, C_ATMEGA.1, DCDC53.3.3 (V_IN), IC1.1 (I0), IC1.5 (I0), IC1.8 (I0), IC1.13 (I1), IC1.14 (VDD), IC2.4 (VDD), IC2.6 (VDD), IC4.10 (VCC), IC4.31 (VCC1), IC4.61 (VCC2), IC4.80 (VCC3), IC4.100 (AVCC), JP1.5, JP2.5, R2.2, R3.1, R_EXT1.2, R_EXT5.2, R_LED_5V.1, R_OIL_V_DIV_2.2, R_SCL_UP.1, R_SDA_UP.1, U$14.B+ (B_+), U$14.G+ (G_+), U$14.R+ (R_+), U$15.B+ (B_+), U$15.G+ (G_+), U$15.R+ (R_+), U$16.B+ (B_+), U$16.G+ (G_+), U$16.R+ (R_+), U$18.B+ (B_+), U$18.G+ (G_+), U$18.R+ (R_+), U$19.B+ (B_+), U$19.G+ (G_+), U$19.R+ (R_+), U$20.B+ (B_+), U$20.G+ (G_+), U$20.R+ (R_+)
V_BAK: BAT_CLIP1.PWR@1 (+), C7.1, GPS.VBACKUP

Notes on the sheet:
Schmitt-Trigger
PWR
Sensoren
Bluetooth
Buttons
MOSI
SCK
MISO
SDA
SCL
left
down
right
DZ_SCHMITT
REED_SCHMITT
RESERVE_SCHMITT
oil_temp
ATmega2560
D18
Extension Header
GND
VDD
RST
RES_EN
ARD_RX
ARD_TX
i2c_temp
ATmega8
Lichtlein & Blinker
SpeedSensor
Instrumenten Beleuchtung
RGB_INST
Reed Schmitt
DZ Schmitt
GPS
GPS_Recv
Display
DZM
to ATm8
Oil Temp
to ATmega8
rx/tx BT
Blinker
Disp SDA
Disp SCL
Disp CD
Disp CS
SD CS
Oil_in
Kupplung
Water Temp
Polarität checken!!
V_bat
Mccoi
RGB Zeiger
Ex_IN(12/5)
Water_temp
SD Power
Disp Reset
Helligkeitssensor?
Helligkeitssensor
Taster auf INT
A_extend

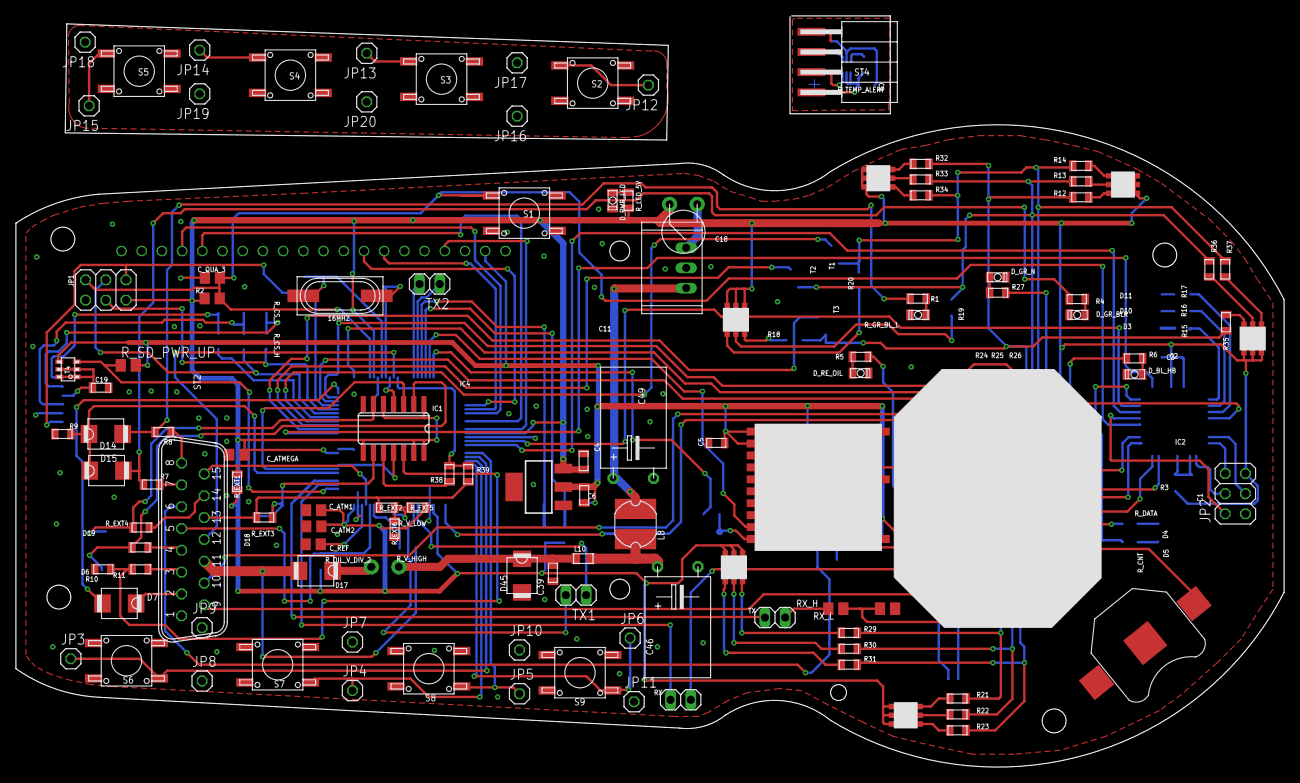
[picture p58: board v6.brd from above]

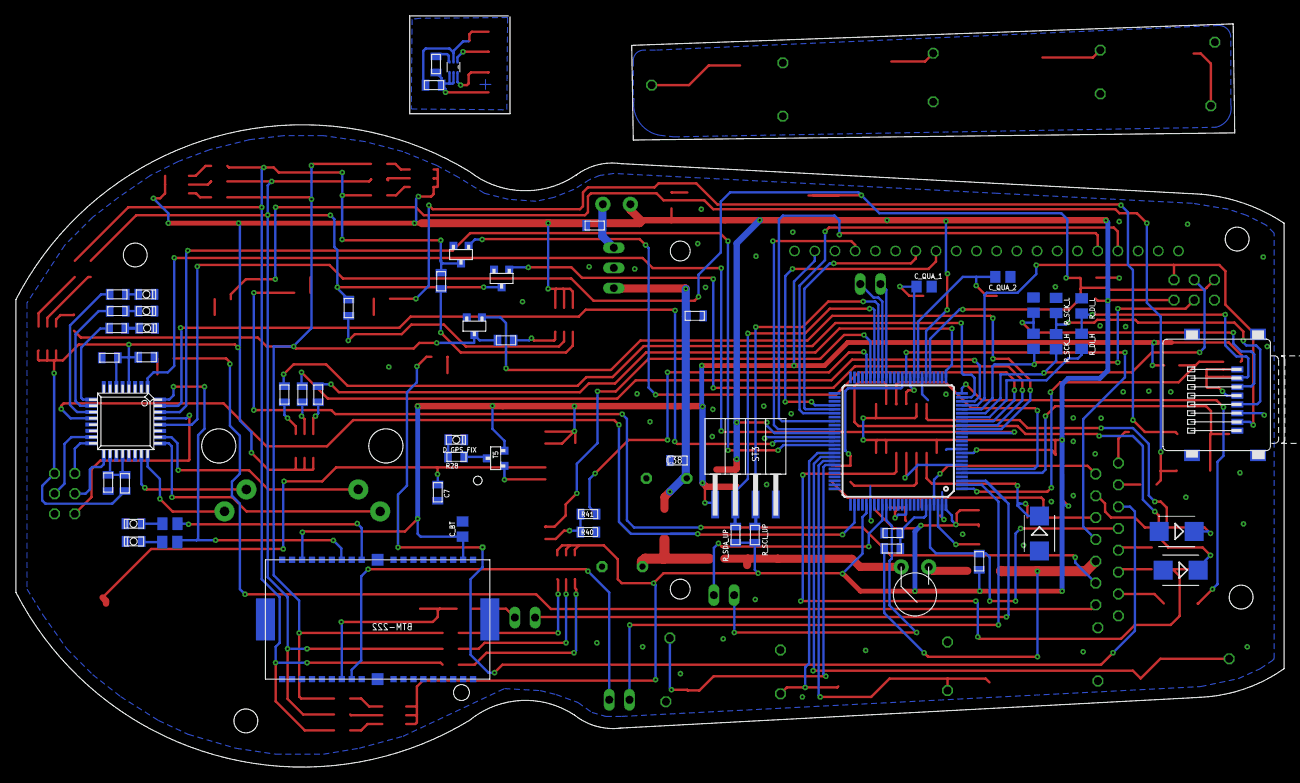
[picture p59: board v6.brd from below]

Board: 2 copper layers, 159.4 x 80.7 mm, 174 parts (58 on the bottom side), 146 nets.
