PhilippSchmaelzle/speedoino/schematics/alte_designs/v7/JKW_standalone.brd

## EAGLE design schematics/alte_designs/v7/JKW_standalone.brd (2020-05-02)

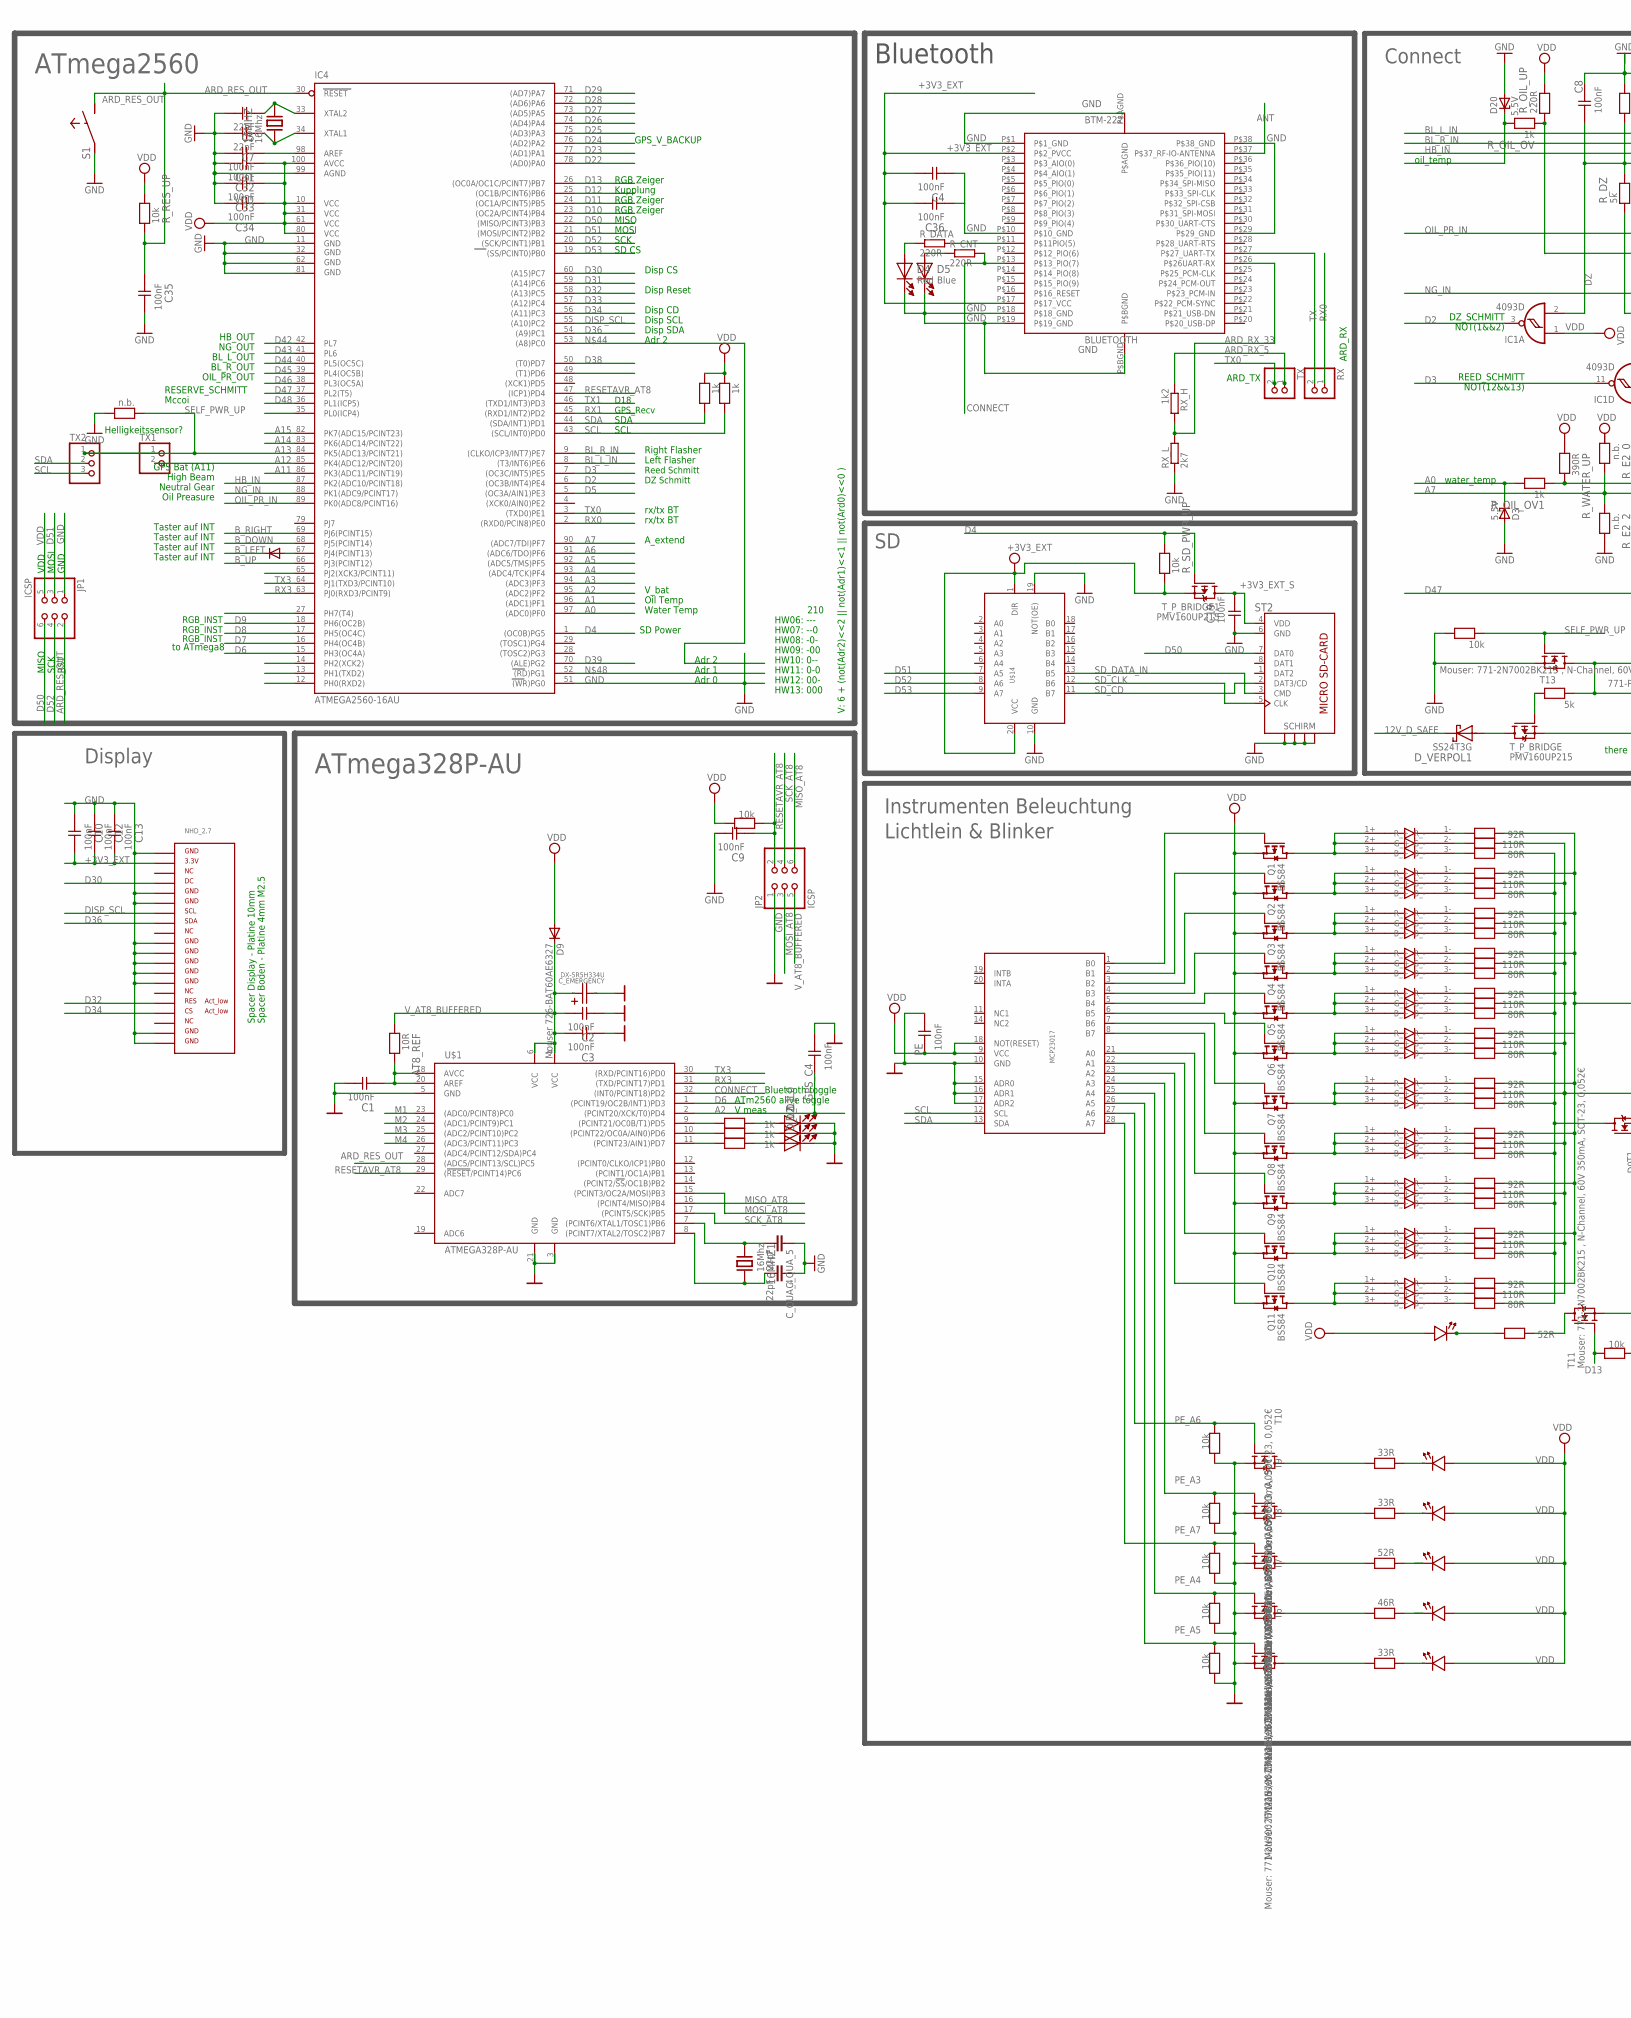
[picture p60: schematic JKW_standalone.sch, part in row 1, column 1]

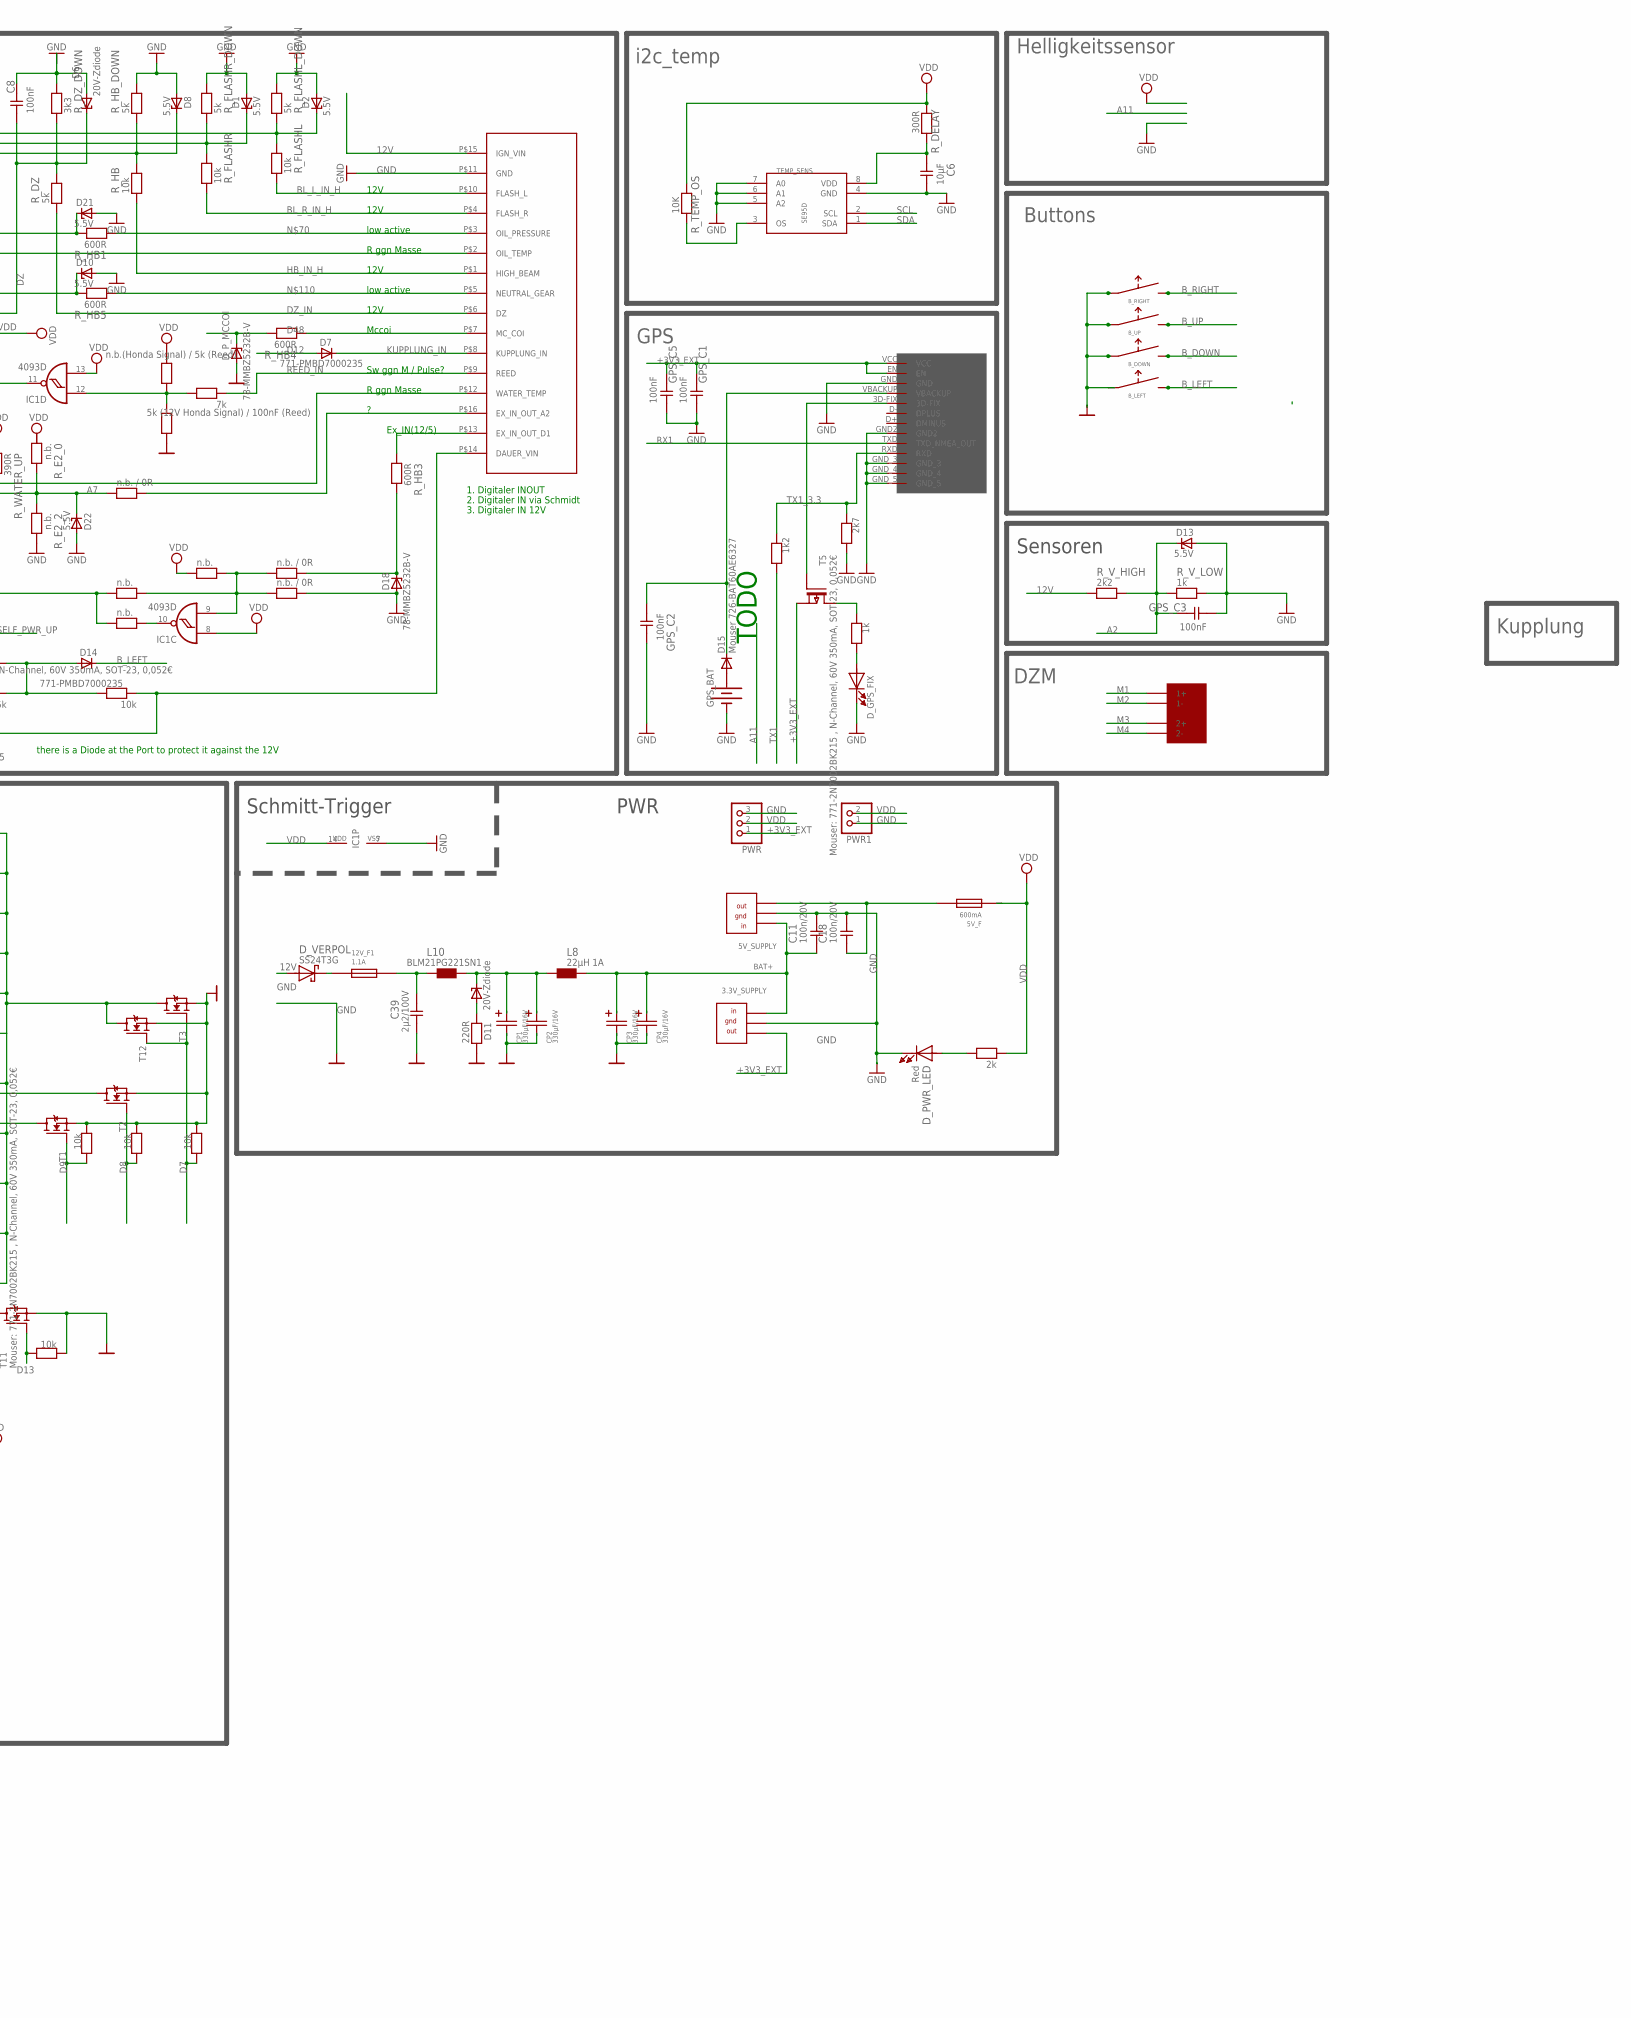
[picture p61: schematic JKW_standalone.sch, part in row 1, column 2]

Parts:
3.3V_SUPPLY: OKI78SR3.31.5WHC; OKI-78SR
5V_F: 600mA; POLY_FUSE
5V_SUPPLY: OKI78SR51.5W36HC; OKI-78SR
12V_F1: 1.1A; POLY_FUSE
16MHZ, 16MHZ1: 16Mhz; XT-HC49S-SMD
AT8_REF: 10R; 0805
BLUETOOTH: BTM-222
B_DOWN: SMD_TASTER_MIT_KAPPE; SMD_DRUCKTASTER
B_LEFT: SMD_TASTER_MIT_KAPPE; SMD_DRUCKTASTER
B_RIGHT: SMD_TASTER_MIT_KAPPE; SMD_DRUCKTASTER
B_UP: SMD_TASTER_MIT_KAPPE; SMD_DRUCKTASTER
C1, C2, C3, C4, C8, C9, C10, C12, C13, C19, C31, C32, C33, C34, C35, C36: 100nF; 0805
C5, C7: 22pF; 0805
C6: 10µF; 0805
C11, C18: 100n/20V; 0805
C39: 2µ2/100V; 0805
CP1, CP2, CP3, CP4: 330µF/16V; SMD/SMT_6.6/6.6
C_EMERGENCY: DX-5R5H334U; GOLDCAP
C_QUA_4, C_QUA_5: 22pF; C0805
D1, D2, D3, D8, D10, D13, D20, D21, D22: 5.5V; SOT23
D4: Red; LED-0805
D5: Blue; LED-0805
D6, D11: 20V-Zdiode; SOT23
D7, D12, D14: 771-PMBD7000235; SOT23
D9, D15: Mouser 726-BAT60AE6327; SOD323-W
D18: 78-MMBZ5232B-V; SOT23
D_GPS_FIX: Red; LED-0805
D_GR_BLR: PLCC4_LED; PLCC-4
D_GR_N: PLCC4_LED; PLCC-4
D_L0, D_L1, D_L2: LED0805; LED-0805
D_PWR_LED: Red; LED-0805
D_P_MCCOI: 78-MMBZ5232B-V; SOT23
D_VERPOL, D_VERPOL1: SS24T3G; SMB
GPS: MT3329
GPS_BAT: F_908642; BATTCON_12MM
GPS_C1, GPS_C2, GPS_C3, GPS_C4, GPS_C5: 100nF; 0805
IC1: 4093D; SO14
IC4: ATMEGA2560-16AU; TQFP100
JP1, JP2: ICSP; 2X03
L8: 22µH 1A; L-PD54
L10: BLM21PG221SN1; 0805+603
NHD_2.7: NHD_2.7_SOLO_RO
PE: 100nF; 0805
PWR: PINHD-1X3; 1X03
PWR1: PINHD-1X2; 1X02
Q1, Q2, Q3, Q4, Q5, Q6, Q7, Q8, Q9, Q10, Q11: BSS84; SOT23
RGB_1, RGB_2, RGB_3, RGB_4, RGB_5, RGB_6, RGB_7, RGB_8, RGB_9, RGB_10, RGB_11: RGB_LED; PLCC-6
RX: PINHD-1X2; 1X02
RX_H: 1k2; M0805
RX_L: 2k7; M0805
R_BL_L: 33R; 0805
R_BL_L1: n.b.; 0805
R_BL_R: 33R; 0805
R_B_LED_1, R_B_LED_2, R_B_LED_3, R_B_LED_4, R_B_LED_5, R_B_LED_6, R_B_LED_7, R_B_LED_8, R_B_LED_9, R_B_LED_10, R_B_LED_11: 80R; 0805
R_B_LED_12, R_B_LED_13, R_B_LED_14, R_B_LED_15, R_B_LED_16, R_B_LED_17, R_B_LED_18, R_B_LED_19, R_B_LED_20: 10k; 0805
R_CNT: 220R; M0805
R_DATA: 220R; M0805
R_DEAKT_DAUER_P, R_DEAKT_DAUER_P1: 10k; 0805
R_DEAKT_DAUER_P2: 5k; 0805
R_DELAY: 300R; 0805
R_DZ: 5k; 0805
R_DZ_DOWN: 3k3; 0805
R_E1_0, R_E1_2, R_E1_4, R_E2_0, R_E2_2: n.b.; 0805
R_E1_1, R_E1_3, R_E2_1: n.b. / 0R; 0805
R_FLASHL: 10k; 0805
R_FLASHL_DOWN: 5k; 0805
R_FLASHR: 10k; 0805
R_FLASHR_DOWN: 5k; 0805
R_GPS_LED: 1k; 0805
R_GR_BL_L: PLCC4_LED; PLCC-4
R_G_LED_1, R_G_LED_2, R_G_LED_3, R_G_LED_4, R_G_LED_5, R_G_LED_6, R_G_LED_7, R_G_LED_8, R_G_LED_9, R_G_LED_10, R_G_LED_11: 110R; 0805
R_HB: 10k; 0805
R_HB1, R_HB3, R_HB4, R_HB5: 600R; 0805
R_HB_DOWN: 5k; 0805
R_HIGHB: 46R; 0805
R_L0, R_L1, R_L2: 1k; 0805
R_L3: 10k; 0805
R_LED_5V: 2k; 0805
R_N: 33R; 0805
R_OIL: 52R; 0805
R_OIL_OV, R_OIL_OV1: 1k; 0805
R_OIL_UP: 220R; 0805
R_REED: 7k; 0805
R_REED_DOWN: 5k (12V Honda Signal) / 100nF (Reed); 0805
R_REED_UP: n.b.(Honda Signal) / 5k (Reed); 0805
R_RES_UP: 10k; 0805
R_R_LED_0: 52R; 0805
R_R_LED_1, R_R_LED_2, R_R_LED_3, R_R_LED_4, R_R_LED_5, R_R_LED_6, R_R_LED_7, R_R_LED_8, R_R_LED_9, R_R_LED_10, R_R_LED_11: 92R; 0805
R_R_LED_12: 220R; 0805
R_SCL_UP: 1k; 0805
R_SDA_UP: 1k; 0805
R_SD_PWR_UP: 10k; 0805
R_TEMP_OS: 10K; 0805
R_TX_DOWN: 2k7; 0805
R_TX_UP: 1k2; 0805
R_V_HIGH: 2k2; 0805
R_V_LOW: 1k; 0805
R_WATER_UP: 390R; 0805
S1: SW-TASTERECO-DIAGONAL; SW-ECO
SPEEDOSTECKER: SPEEDOSTECKER
ST2: SD_MICRO
STEPPER: STEPPER
T1, T2, T3, T6, T7, T8, T9, T10, T11, T12, T13: Mouser: 771-2N7002BK215 , N-Channel, 60V 350mA, S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; SOT23
T5: Mouser: 771-2N7002BK215 , N-Channel, 60V 350mA, S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; SOT-23
TEMP_SENS: SE95D; SOIC8
TX, TX1: PINHD-1X2; 1X02
TX2: PINHD-1X3; 1X03
T_P_BRIDGE, T_P_BRIDGE1: PMV160UP215; SOT23
U$1: ATMEGA328P-AU; TQFP8
U$3: CLM4B-BKW-CTBVA363; PLCC-4
U$11, U$22: CLM4B-RKW-CWAXBAA3; PLCC-4
U$14: 74LVC_LVCH245A; TSSOP20
U$19: MCP23017; SOIC28

Connections:
3D-FIX: GPS.3D-FIX, T5.1 (G)
12V: D_VERPOL.A, R_V_HIGH.1, SPEEDOSTECKER.P$15 (IGN_VIN)
12V_D_SAFE: 12V_F1.P$1, D_VERPOL.K, D_VERPOL1.K
12V_PERMANENT: R_DEAKT_DAUER_P.1, SPEEDOSTECKER.P$14 (DAUER_VIN), T_P_BRIDGE.2 (S)
12V_SAFE: 12V_F1.P$2, C39.1, L10.1
+3V3_EXT: 3.3V_SUPPLY.OUT, BLUETOOTH.P$2 (P$2_PVCC), BLUETOOTH.P$17 (P$17_VCC), C4.2, C10.2, C12.2, C13.2, C36.2, GPS.EN, GPS.VCC, GPS_C1.2, GPS_C5.2, NHD_2.7.VDD0 (VDD), PWR.1, R_SD_PWR_UP.1, T5.2 (S), T_P_BRIDGE1.2 (S), U$14.1 (DIR), U$14.20 (VCC)
+3V3_EXT_S: C19.2, ST2.4 (VDD), T_P_BRIDGE1.3 (D)
A0: D3.3 (C), IC4.97 ((ADC0)PF0), R_OIL_OV1.2
A1: D20.3 (C), IC4.96 ((ADC1)PF1), R_OIL_OV.2
A2: D13.3 (C), GPS_C3.2, GPS_C4.2, IC4.95 ((ADC2)PF2), R_V_HIGH.2, R_V_LOW.1, U$1.2 ((PCINT20/XCK/T0)PD4)
A3: IC4.94 ((ADC3)PF3)
A4: IC4.93 ((ADC4/TCK)PF4)
A5: IC4.92 ((ADC5/TMS)PF5)
A6: IC4.91 ((ADC6/TDO)PF6)
A7: D22.3 (C), IC4.90 ((ADC7/TDI)PF7), R_E2_0.2, R_E2_1.2, R_E2_2.1
A11: IC4.86 (PK3(ADC11/PCINT19))
A12: IC4.85 (PK4(ADC12/PCINT20)), TX1.2
A13: IC4.84 (PK5(ADC13/PCINT21)), R_BL_L1.1, TX1.1, TX2.1
A14: IC4.83 (PK6(ADC14/PCINT22))
A15: IC4.82 (PK7(ADC15/PCINT23))
ANT: BLUETOOTH.P$37 (P$37_RF-IO-ANTENNA)
ARD_RES_OUT: C35.1, IC4.30 (RESET), JP1.2, R_RES_UP.1, S1.4 (2), U$1.28 ((ADC5/PCINT13/SCL)PC5)
ARD_RX_5: RX_H.1, TX.1
ARD_RX_33: BLUETOOTH.P$26 (P$26UART-RX), RX_H.2, RX_L.2
BAT+: 3.3V_SUPPLY.IN, 5V_SUPPLY.IN, C11.1, CP3.POS (PLUS), CP4.POS (PLUS), L8.2
BLUE_INSTR: R_B_LED_1.2, R_B_LED_2.2, R_B_LED_3.2, R_B_LED_4.2, R_B_LED_5.2, R_B_LED_6.2, R_B_LED_7.2, R_B_LED_8.2, R_B_LED_9.2, R_B_LED_10.2, R_B_LED_11.2, T1.3 (D)
BL_L_IN: D2.3 (C), IC4.8 ((T3/INT6)PE6), R_FLASHL.2, R_FLASHL_DOWN.1
BL_L_IN_H: R_FLASHL.1, SPEEDOSTECKER.P$10 (FLASH_L)
BL_R_IN: D1.3 (C), IC4.9 ((CLKO/ICP3/INT7)PE7), R_FLASHR.2, R_FLASHR_DOWN.1
BL_R_IN_H: R_FLASHR.1, SPEEDOSTECKER.P$4 (FLASH_R)
B_DOWN: B_DOWN.OUT, IC4.68 (PJ5(PCINT14))
B_LEFT: B_LEFT.OUT, D12.3 (C), D14.3 (C)
B_RIGHT: B_RIGHT.OUT, IC4.69 (PJ6(PCINT15))
B_UP: B_UP.OUT, IC4.66 (PJ3(PCINT12))
CONNECT: BLUETOOTH.P$13 (P$13_PIO(7)), R_CNT.2, U$1.32 ((INT0/PCINT18)PD2)
D2: IC1.3 (O), IC4.6 ((OC3B/INT4)PE4)
D3: IC1.11 (O), IC4.7 ((OC3C/INT5)PE5)
D4: IC4.1 ((OC0B)PG5), R_SD_PWR_UP.2, T_P_BRIDGE1.1 (G)
D5: IC4.5 ((OC3A/AIN1)PE3)
D6: IC4.15 (PH3(OC4A)), U$1.1 ((PCINT19/OC2B/INT1)PD3)
D7: IC4.16 (PH4(OC4B)), R_B_LED_15.1, T3.1 (G), T12.1 (G)
D8: IC4.17 (PH5(OC4C)), R_B_LED_14.1, T2.1 (G)
D9: IC4.18 (PH6(OC2B)), R_B_LED_13.1, T1.1 (G)
D10: IC4.23 ((OC2A/PCINT4)PB4)
D11: IC4.24 ((OC1A/PCINT5)PB5)
D12: D7.1 (A), IC4.25 ((OC1B/PCINT6)PB6)
D13: IC4.26 ((OC0A/OC1C/PCINT7)PB7), R_B_LED_12.1, T11.1 (G)
D22: IC4.78 ((AD0)PA0)
D23: IC4.77 ((AD1)PA1)
D24: IC4.76 ((AD2)PA2)
D25: IC4.75 ((AD3)PA3)
D26: IC4.74 ((AD4)PA4)
D27: IC4.73 ((AD5)PA5)
D28: IC4.72 ((AD6)PA6)
D29: IC4.71 ((AD7)PA7)
D30: IC4.60 ((A15)PC7), NHD_2.7.DC
D31: IC4.59 ((A14)PC6)
D32: IC4.58 ((A13)PC5), NHD_2.7.RES
D33: IC4.57 ((A12)PC4)
D34: IC4.56 ((A11)PC3), NHD_2.7.CS
D36: IC4.54 ((A9)PC1), NHD_2.7.SDIN (SDA)
D38: IC4.50 ((T0)PD7)
D39: IC4.70 ((ALE)PG2)
D42: IC4.42 (PL7)
D43: IC4.41 (PL6)
D44: IC4.40 (PL5(OC5C))
D45: IC4.39 (PL4(OC5B))
D46: IC4.38 (PL3(OC5A))
D47: IC4.37 (PL2(T5)), R_E1_2.2, R_E1_4.2
D48: D_P_MCCOI.3 (C), IC4.36 (PL1(ICP5)), R_HB4.2
D50: IC4.22 ((MISO/PCINT3)PB3), JP1.6, ST2.7 (DAT0)
D51: IC4.21 ((MOSI/PCINT2)PB2), JP1.3, U$14.7 (A5)
D52: IC4.20 ((SCK/PCINT1)PB1), JP1.4, U$14.8 (A6)
D53: IC4.19 ((SS/PCINT0)PB0), U$14.9 (A7)
DISP_SCL: IC4.55 ((A10)PC2), NHD_2.7.SCLK (SCL)
DZ: C8.1, D6.3 (C), IC1.2 (I1), R_DZ.2, R_DZ_DOWN.1
DZ_IN: R_DZ.1, SPEEDOSTECKER.P$6 (DZ)
GND: 3.3V_SUPPLY.GND, 5V_SUPPLY.GND, BLUETOOTH.P$1 (P$1_GND), BLUETOOTH.P$10 (P$10_GND), BLUETOOTH.P$18 (P$18_GND), BLUETOOTH.P$19 (P$19_GND), BLUETOOTH.P$29 (P$29_GND), BLUETOOTH.P$38 (P$38_GND), BLUETOOTH.P$AGND, BLUETOOTH.P$BGND, B_DOWN.IN, B_DOWN.IN2 (IN), B_LEFT.IN, B_LEFT.IN2 (IN), B_RIGHT.IN, B_RIGHT.IN2 (IN), B_UP.IN, B_UP.IN2 (IN), C1.2, C2.1, C3.1, C4.1, C5.2, C6.2, C7.2, C8.2, C9.2, C10.1, C11.2, C12.1, C13.1, C18.2, C19.1, C31.2, C32.2, C33.2, C34.2, C35.2, C36.1, C39.2, CP1.NEG (GND), CP2.NEG (GND), CP3.NEG (GND), CP4.NEG (GND), C_EMERGENCY.MINUS (GND), C_QUA_4.1, C_QUA_5.1, D1.1 (A), D2.1 (A), D3.1 (A), D4.2 (K), D5.2 (K), D6.1 (A), D8.1 (A), D10.1 (A), D13.1 (A), D18.1 (A), D20.1 (A), D21.1 (A), D22.1 (A), D_GPS_FIX.2 (K), D_L0.2 (K), D_L1.2 (K), D_L2.2 (K), D_PWR_LED.2 (K), D_P_MCCOI.1 (A), GPS.GND, GPS.GND2, GPS.GND_3, GPS.GND_4, GPS.GND_5, GPS_BAT.GND (-), GPS_C1.1, GPS_C2.2, GPS_C3.1, GPS_C4.1, GPS_C5.1, IC1.7 (VSS), IC4.11 (GND), IC4.32 (GND1), IC4.51 ((WR)PG0), IC4.62 (GND2), IC4.81 (GND3), IC4.99 (AGND), JP1.1, JP2.1, NHD_2.7.GND0 (GND), NHD_2.7.GND1 (GND2), NHD_2.7.GND2 (GND3), NHD_2.7.GND3 (GND4), NHD_2.7.GND4 (GND5), NHD_2.7.GND5 (GND6), NHD_2.7.GND6 (GND7), NHD_2.7.GND7 (GND8), NHD_2.7.GND8 (GND9), NHD_2.7.GND9 (GND10), PE.1, PWR.3, PWR1.1, RX_L.1, R_BL_L1.2, R_B_LED_12.2, R_B_LED_13.2, R_B_LED_14.2, R_B_LED_15.2, R_B_LED_16.1, R_B_LED_17.1, R_B_LED_18.1, R_B_LED_19.1, R_B_LED_20.1, R_DEAKT_DAUER_P1.2, R_DZ_DOWN.2, R_E1_3.1, R_E2_2.2, R_FLASHL_DOWN.2, R_FLASHR_DOWN.2, R_HB_DOWN.2, R_REED_DOWN.2, R_R_LED_12.1, R_TX_DOWN.2, R_V_LOW.2, S1.1, SPEEDOSTECKER.P$11 (GND), ST2.6 (GND), ST2.GND (SCHIRM1), ST2.GND2 (SCHIRM2), ST2.GND3 (SCHIRM3), ST2.GND4 (SCHIRM), T1.2 (S), T2.2 (S), T3.2 (S), T6.2 (S), T7.2 (S), T8.2 (S), T9.2 (S), T10.2 (S), T11.2 (S), T12.2 (S), T13.2 (S), TEMP_SENS.4 (GND), TEMP_SENS.5 (A2), TEMP_SENS.6 (A1), TEMP_SENS.7 (A0), U$1.3 (GND), U$1.5 (GND), U$1.21 (GND), U$14.10 (GND), U$14.19 (NOT(OE)), U$19.10 (GND), U$19.15 (ADR0), U$19.16 (ADR1), U$19.17 (ADR2)
GREEN_INSTR: R_G_LED_1.2, R_G_LED_2.2, R_G_LED_3.2, R_G_LED_4.2, R_G_LED_5.2, R_G_LED_6.2, R_G_LED_7.2, R_G_LED_8.2, R_G_LED_9.2, R_G_LED_10.2, R_G_LED_11.2, T2.3 (D)
HB_IN: D8.3 (C), IC4.87 (PK2(ADC10/PCINT18)), R_HB.2, R_HB_DOWN.1
HB_IN_H: R_HB.1, SPEEDOSTECKER.P$1 (HIGH_BEAM)
KUPPLUNG_IN: D7.3 (C), SPEEDOSTECKER.P$8 (KUPPLUNG_IN)
M1: STEPPER.1+, U$1.23 ((ADC0/PCINT8)PC0)
M2: STEPPER.1-, U$1.24 ((ADC1/PCINT9)PC1)
M3: STEPPER.2+, U$1.25 ((ADC2/PCINT10)PC2)
M4: STEPPER.2-, U$1.26 ((ADC3/PCINT11)PC3)
MISO_AT8: JP2.6, U$1.16 ((PCINT4/MISO)PB4)
MOSI_AT8: JP2.3, U$1.15 ((PCINT3/OC2A/MOSI)PB3)
N999: R_OIL_OV.1, R_OIL_UP.1, SPEEDOSTECKER.P$2 (OIL_TEMP)
unnamed: CP1.POS (PLUS), CP2.POS (PLUS), D11.3 (C), L8.1, L10.2
unnamed: AT8_REF.2, C1.1, U$1.18 (AVCC), U$1.20 (AREF)
unnamed: C6.1, R_DELAY.1, TEMP_SENS.8 (VDD)
unnamed: D5.1 (A), R_CNT.1
unnamed: RGB_5.3- (B_-), R_B_LED_4.1
unnamed: RGB_5.2- (G_-), R_G_LED_4.1
unnamed: RGB_5.1- (R_-), R_R_LED_4.1
unnamed: D_PWR_LED.1 (A), R_LED_5V.2
unnamed: RGB_6.3- (B_-), R_B_LED_5.1
unnamed: D15.A, GPS_BAT.PWR@1 (+)
unnamed: D4.1 (A), R_DATA.1
unnamed: Q11.3 (D), RGB_11.1+ (R_+), RGB_11.2+ (G_+), RGB_11.3+ (B_+)
unnamed: R_L2.1, U$1.11 ((PCINT23/AIN1)PD7)
unnamed: D_GPS_FIX.1 (A), R_GPS_LED.2
unnamed: R_R_LED_0.1, U$22.P$4 (CATHODE)
unnamed: R_GPS_LED.1, T5.3 (D)
unnamed: R_L1.1, U$1.10 ((PCINT22/OC0A/AIN0)PD6)
unnamed: 5V_F.P$2, 5V_SUPPLY.OUT, C18.1
unnamed: R_L0.1, U$1.9 ((PCINT21/OC0B/T1)PD5)
unnamed: RGB_6.2- (G_-), R_G_LED_5.1
unnamed: RGB_6.1- (R_-), R_R_LED_5.1
unnamed: Q10.3 (D), RGB_10.1+ (R_+), RGB_10.2+ (G_+), RGB_10.3+ (B_+)
unnamed: R_DEAKT_DAUER_P2.2, T_P_BRIDGE.1 (G)
unnamed: R_OIL.1, U$11.P$4 (CATHODE)
unnamed: Q9.3 (D), RGB_1.1+ (R_+), RGB_1.2+ (G_+), RGB_1.3+ (B_+)
unnamed: RGB_7.3- (B_-), R_B_LED_6.1
unnamed: R_HIGHB.1, U$3.P$4 (CATHODE)
unnamed: RGB_7.2- (G_-), R_G_LED_6.1
unnamed: RGB_7.1- (R_-), R_R_LED_6.1
unnamed: R_BL_L.2, T10.3 (D)
unnamed: R_BL_R.2, T9.3 (D)
unnamed: 16MHZ.2, C5.1, IC4.33 (XTAL2)
unnamed: 16MHZ.1, C7.1, IC4.34 (XTAL1)
unnamed: C31.1, IC4.98 (AREF)
unnamed: IC1.9 (I1), R_E1_0.1, R_E1_1.2, R_E1_2.1, R_E1_3.2
unnamed: R_HIGHB.2, T7.3 (D)
unnamed: IC1.10 (O), R_E1_4.1
unnamed: D12.1 (A), IC4.67 (PJ4(PCINT13))
unnamed: R_HB3.1, SPEEDOSTECKER.P$13 (EX_IN_OUT_D1)
unnamed: R_E2_1.1, SPEEDOSTECKER.P$16 (EX_IN_OUT_A2)
unnamed: D_VERPOL1.A, T_P_BRIDGE.3 (D)
unnamed: RGB_4.1- (R_-), R_R_LED_3.1
unnamed: RGB_4.2- (G_-), R_G_LED_3.1
unnamed: RGB_4.3- (B_-), R_B_LED_3.1
unnamed: RGB_3.1- (R_-), R_R_LED_2.1
unnamed: RGB_3.2- (G_-), R_G_LED_2.1
unnamed: RGB_3.3- (B_-), R_B_LED_2.1
unnamed: RGB_2.1- (R_-), R_R_LED_1.1
unnamed: RGB_2.2- (G_-), R_G_LED_1.1
unnamed: RGB_2.3- (B_-), R_B_LED_1.1
unnamed: R_BL_L.1, R_GR_BL_L.P$4 (CATHODE)
unnamed: 16MHZ1.1, C_QUA_5.2, U$1.7 ((PCINT6/XTAL1/TOSC1)PB6)
unnamed: RGB_11.1- (R_-), R_R_LED_7.1
unnamed: 16MHZ1.2, C_QUA_4.2, U$1.8 ((PCINT7/XTAL2/TOSC2)PB7)
unnamed: D_GR_BLR.P$4 (CATHODE), R_BL_R.1
unnamed: R_N.2, T6.3 (D)
unnamed: R_OIL.2, T8.3 (D)
unnamed: D_GR_N.P$4 (CATHODE), R_N.1
unnamed: R_HB1.1, SPEEDOSTECKER.P$3 (OIL_PRESSURE)
unnamed: R_R_LED_0.2, T11.3 (D)
unnamed: RGB_11.2- (G_-), R_G_LED_7.1
unnamed: RGB_11.3- (B_-), R_B_LED_7.1
unnamed: RGB_10.1- (R_-), R_R_LED_8.1
unnamed: RGB_10.2- (G_-), R_G_LED_8.1
unnamed: RGB_10.3- (B_-), R_B_LED_8.1
unnamed: RGB_9.1- (R_-), R_R_LED_9.1
unnamed: RGB_9.2- (G_-), R_G_LED_9.1
unnamed: RGB_9.3- (B_-), R_B_LED_9.1
unnamed: RGB_8.1- (R_-), R_R_LED_10.1
unnamed: RGB_8.2- (G_-), R_G_LED_10.1
unnamed: RGB_8.3- (B_-), R_B_LED_10.1
unnamed: RGB_1.1- (R_-), R_R_LED_11.1
unnamed: RGB_1.2- (G_-), R_G_LED_11.1
unnamed: RGB_1.3- (B_-), R_B_LED_11.1
unnamed: Q8.3 (D), RGB_8.1+ (R_+), RGB_8.2+ (G_+), RGB_8.3+ (B_+)
unnamed: Q7.3 (D), RGB_9.1+ (R_+), RGB_9.2+ (G_+), RGB_9.3+ (B_+)
unnamed: Q1.3 (D), RGB_7.1+ (R_+), RGB_7.2+ (G_+), RGB_7.3+ (B_+)
unnamed: D18.3 (C), R_E1_1.1, R_HB3.2
unnamed: R_TEMP_OS.1, TEMP_SENS.3 (OS)
unnamed: R_HB4.1, SPEEDOSTECKER.P$7 (MC_COI)
unnamed: Q2.3 (D), RGB_6.1+ (R_+), RGB_6.2+ (G_+), RGB_6.3+ (B_+)
unnamed: Q3.3 (D), RGB_5.1+ (R_+), RGB_5.2+ (G_+), RGB_5.3+ (B_+)
unnamed: Q4.3 (D), RGB_4.1+ (R_+), RGB_4.2+ (G_+), RGB_4.3+ (B_+)
unnamed: Q6.3 (D), RGB_2.1+ (R_+), RGB_2.2+ (G_+), RGB_2.3+ (B_+)
unnamed: Q5.3 (D), RGB_3.1+ (R_+), RGB_3.2+ (G_+), RGB_3.3+ (B_+)
unnamed: Q1.1 (G), U$19.1 (B0)
unnamed: Q2.1 (G), U$19.2 (B1)
unnamed: Q3.1 (G), U$19.3 (B2)
unnamed: Q4.1 (G), U$19.4 (B3)
unnamed: Q5.1 (G), U$19.5 (B4)
unnamed: Q6.1 (G), U$19.6 (B5)
unnamed: Q7.1 (G), U$19.7 (B6)
unnamed: Q8.1 (G), U$19.8 (B7)
unnamed: Q9.1 (G), U$19.21 (A0)
unnamed: Q10.1 (G), U$19.22 (A1)
unnamed: Q11.1 (G), U$19.23 (A2)
unnamed: D11.1 (A), R_R_LED_12.2
unnamed: R_HB5.1, SPEEDOSTECKER.P$5 (NEUTRAL_GEAR)
unnamed: R_OIL_OV1.1, R_WATER_UP.2, SPEEDOSTECKER.P$12 (WATER_TEMP)
NET12: D14.1 (A), R_DEAKT_DAUER_P.2, R_DEAKT_DAUER_P2.1, T13.3 (D)
NG_IN: D10.3 (C), IC4.88 (PK1(ADC9/PCINT17)), R_HB5.2
OIL_PR_IN: D21.3 (C), IC4.89 (PK0(ADC8/PCINT16)), R_HB1.2
P0: D_L0.1 (A), R_L0.2
P1: D_L1.1 (A), R_L1.2
P2: D_L2.1 (A), R_L2.2
PE_A3: R_B_LED_17.2, T9.1 (G), U$19.24 (A3)
PE_A4: R_B_LED_19.2, T7.1 (G), U$19.25 (A4)
PE_A5: R_B_LED_20.2, T6.1 (G), U$19.26 (A5)
PE_A6: R_B_LED_16.2, T10.1 (G), U$19.27 (A6)
PE_A7: R_B_LED_18.2, T8.1 (G), U$19.28 (A7)
RED_INSTR: R_R_LED_1.2, R_R_LED_2.2, R_R_LED_3.2, R_R_LED_4.2, R_R_LED_5.2, R_R_LED_6.2, R_R_LED_7.2, R_R_LED_8.2, R_R_LED_9.2, R_R_LED_10.2, R_R_LED_11.2, T3.3 (D), T12.3 (D)
REED: IC1.12 (I0), R_REED.2, R_REED_DOWN.1, R_REED_UP.2
REED_IN: R_REED.1, SPEEDOSTECKER.P$9 (REED)
RESETAVR_AT8: C9.1, IC4.47 ((ICP1)PD4), JP2.2, R_L3.2, U$1.29 ((!RESET!/PCINT14)PC6)
RX0: IC4.2 ((RXD0/PCIN8)PE0), RX.1
RX1: GPS.TXD (TXD_NMEA_OUT), IC4.45 ((RXD1/INT2)PD2)
RX3: IC4.63 (PJ0(RXD3/PCINT9)), U$1.31 ((TXD/PCINT17)PD1)
SCK_AT8: JP2.4, U$1.17 ((PCINT5/SCK)PB5)
SCL: IC4.43 ((SCL/INT0)PD0), R_SCL_UP.2, TEMP_SENS.2 (SCL), TX2.3, U$19.12 (SCL)
SDA: IC4.44 ((SDA/INT1)PD1), R_SDA_UP.2, TEMP_SENS.1 (SDA), TX2.2, U$19.13 (SDA)
SD_CD: ST2.2 (DAT3/CD), U$14.11 (B7)
SD_CLK: ST2.5 (CLK), U$14.12 (B6)
SD_DATA_IN: ST2.3 (CMD), U$14.13 (B5)
SELF_PWR_UP: IC4.35 (PL0(ICP4)), R_DEAKT_DAUER_P1.1, T13.1 (G)
TO_DATA_LED: BLUETOOTH.P$11 (P$11PIO(5)), R_DATA.2
TX: BLUETOOTH.P$27 (P$27_UART-TX), RX.2
TX0: IC4.3 ((TXD0)PE1), TX.2
TX1: IC4.46 ((TXD1/INT3)PD3), R_TX_UP.2
TX1_3.3: GPS.RXD, R_TX_DOWN.1, R_TX_UP.1
TX3: IC4.64 (PJ1(TXD3/PCINT10)), U$1.30 ((RXD/PCINT16)PD0)
VDD: 5V_F.P$1, C32.1, C33.1, C34.1, D9.A, D_GR_BLR.P$1 (ANODE), D_GR_BLR.P$2 (ANODE), D_GR_BLR.P$3 (ANODE), D_GR_N.P$1 (ANODE), D_GR_N.P$2 (ANODE), D_GR_N.P$3 (ANODE), IC1.1 (I0), IC1.8 (I0), IC1.13 (I1), IC1.14 (VDD), IC4.10 (VCC), IC4.31 (VCC1), IC4.61 (VCC2), IC4.80 (VCC3), IC4.100 (AVCC), JP1.5, PE.2, PWR.2, PWR1.2, Q1.2 (S), Q2.2 (S), Q3.2 (S), Q4.2 (S), Q5.2 (S), Q6.2 (S), Q7.2 (S), Q8.2 (S), Q9.2 (S), Q10.2 (S), Q11.2 (S), R_DELAY.2, R_E1_0.2, R_GR_BL_L.P$1 (ANODE), R_GR_BL_L.P$2 (ANODE), R_GR_BL_L.P$3 (ANODE), R_L3.1, R_LED_5V.1, R_OIL_UP.2, R_REED_UP.1, R_RES_UP.2, R_SCL_UP.1, R_SDA_UP.1, R_TEMP_OS.2, R_WATER_UP.1, U$3.P$1 (ANODE), U$3.P$2 (ANODE), U$3.P$3 (ANODE), U$11.P$1 (ANODE), U$11.P$2 (ANODE), U$11.P$3 (ANODE), U$19.9 (VCC), U$19.18 (NOT(RESET)), U$22.P$1 (ANODE), U$22.P$2 (ANODE), U$22.P$3 (ANODE)
V_AT8_BUFFERED: AT8_REF.1, C2.2, C3.2, C_EMERGENCY.PLUS, D9.C, JP2.5, U$1.4 (VCC), U$1.6 (VCC)
V_BAT: D15.C, GPS.VBACKUP, GPS_C2.1

Notes on the sheet:
Schmitt-Trigger
PWR
Sensoren
Bluetooth
Buttons
MOSI
SCK
MISO
SDA
SCL
DZ_SCHMITT
REED_SCHMITT
oil_temp
ATmega2560
D18
GND
VDD
RST
ATm2560 alive toggle
ARD_RX
ARD_TX
i2c_temp
ATmega328P-AU
Lichtlein & Blinker
Instrumenten Beleuchtung
RGB_INST
Reed Schmitt
DZ Schmitt
GPS
GPS_Recv
Display
DZM
Oil Temp
rx/tx BT
Disp SDA
Disp SCL
Disp CD
Disp CS
SD CS
Water Temp
V_bat
RESERVE_SCHMITT
Mccoi
RGB Zeiger
Kupplung
Ex_IN(12/5)
SD Power
Disp Reset
Helligkeitssensor?
Helligkeitssensor
Taster auf INT
A_extend
NOT(1&&2)
NOT(12&&13)
Left Flasher
Right Flasher
Oil Preasure
Neutral Gear
High Beam
to ATmega8
HB_OUT
NG_OUT
BL_L_OUT
BL_R_OUT
OIL_PR_OUT
1. Digitaler INOUT
2. Digitaler IN via Schmidt
3. Digitaler IN 12V
Connect
low active
12V
R ggn Masse
Sw ggn M / Pulse?
water_temp
GPS Bat (A11)
GPS_V_BACKUP
Adr 0
Adr 1
Adr 2
HW06: ---
HW07: --0
HW08: -0-
HW09: -00
HW10: 0--
HW11: 0-0
HW12: 00-
HW13: 000
V: 6 + (not(Adr2)<<2 || not(Adr1)<<1 || not(Ard0)<<0 )
210
Spacer Display - Platine 10mm
Spacer Boden - Platine 4mm M2.5
Bluetooth toggle
V meas
there is a Diode at the Port to protect it against the 12V
TODO

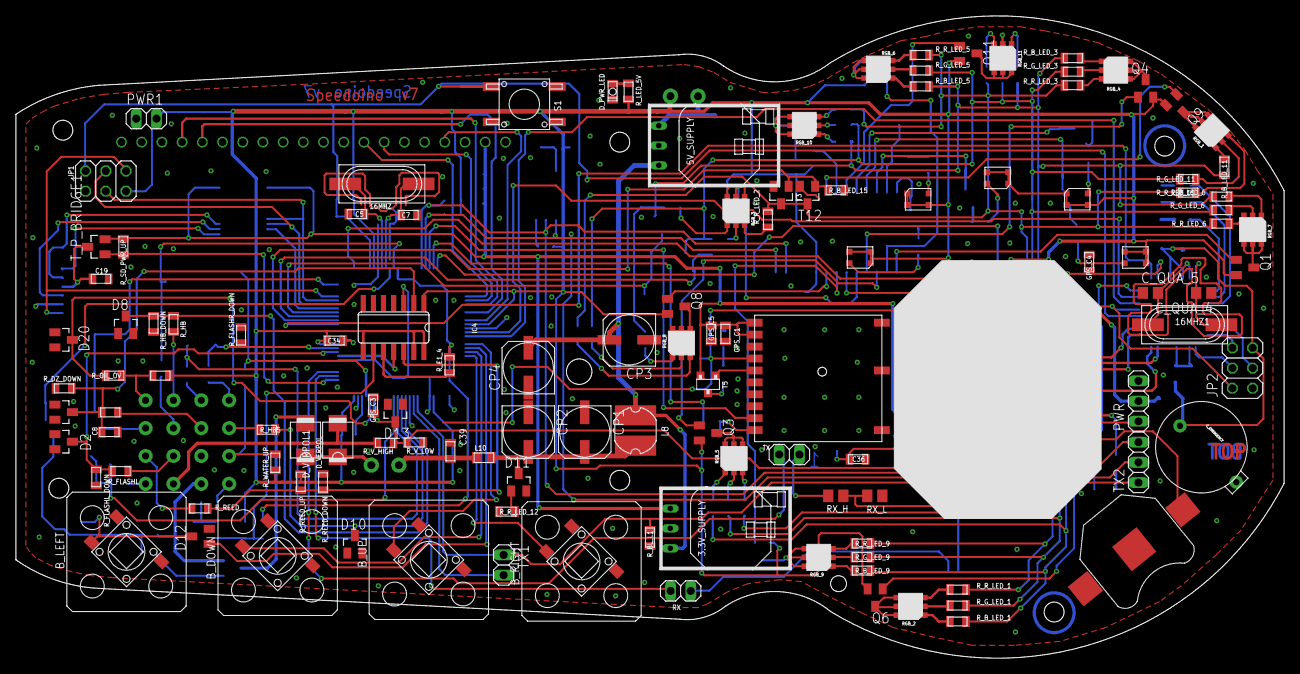
[picture p62: board JKW_standalone.brd from above]

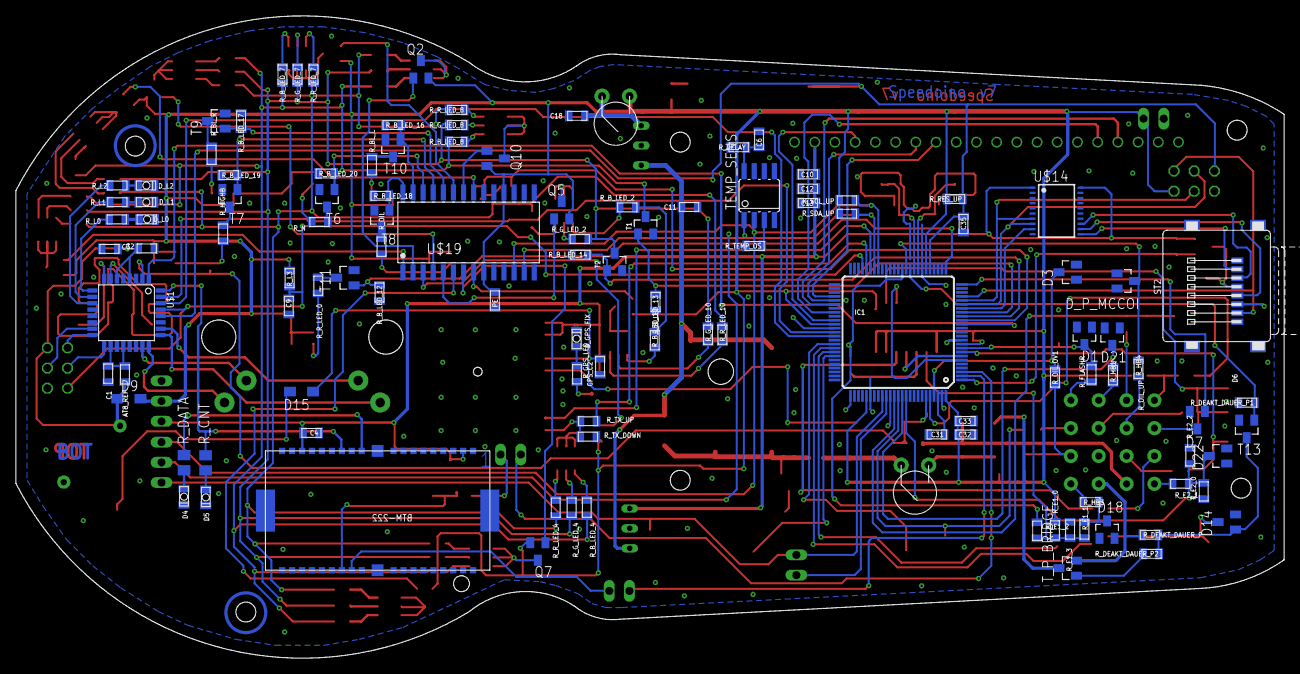
[picture p63: board JKW_standalone.brd from below]

Board: 2 copper layers, 159.4 x 80.7 mm, 239 parts (114 on the bottom side), 194 nets.
