PhilippSchmaelzle/speedoino/schematics/plugins/canbus_shield-v1.brd

## EAGLE design schematics/plugins/canbus_shield-v1.brd (2020-05-02)

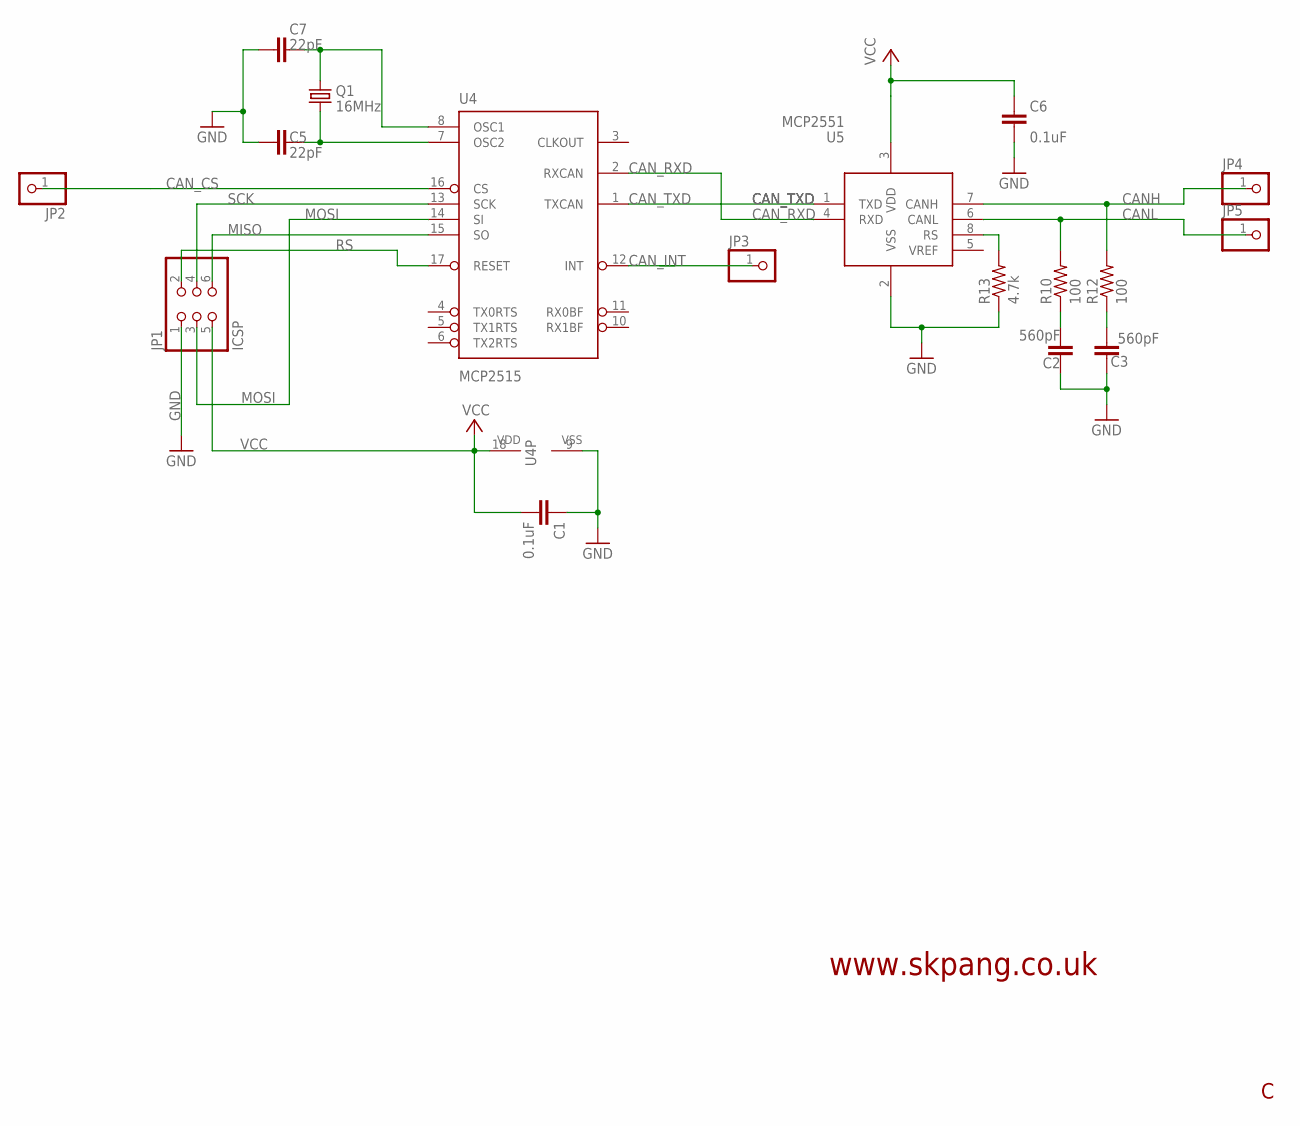
[picture p64: schematic canbus_shield-v1.sch]

Parts:
C1, C6: 0.1uF; 0603-CAP
C2, C3: 560pF; 0603-CAP
C5, C7: 22pF; 0603-CAP
JP1: ICSP; 2X03
JP2, JP3, JP4, JP5: PINHD-1X1; 1X01
Q1: 16MHz; CRYSTAL-SMD-5X3
R10, R12: 100; 0603-RES
R13: 4.7k; 0603-RES
U4: MCP2515; SO-18W
U5: MCP2551; SO-08M

Connections:
CANH: JP4.1, R12.2, U5.7 (CANH)
CANL: JP5.1, R10.2, U5.6 (CANL)
CAN_CS: JP2.1, U4.16 (CS)
CAN_INT: JP3.1, U4.12 (INT)
CAN_RXD: U4.2 (RXCAN), U5.4 (RXD)
CAN_TXD: U4.1 (TXCAN), U5.1 (TXD)
GND: C1.1, C2.1, C3.1, C5.1, C6.1, C7.1, JP1.1, R13.1, U4.9 (VSS), U5.2 (VSS)
MISO: JP1.6, U4.15 (SO)
MOSI: JP1.3, U4.14 (SI)
unnamed: C2.2, R10.1
unnamed: C3.2, R12.1
unnamed: R13.2, U5.8 (RS)
unnamed: C7.2, Q1.3 (2), U4.8 (OSC1)
unnamed: C5.2, Q1.1, U4.7 (OSC2)
RS: JP1.2, U4.17 (RESET)
SCK: JP1.4, U4.13 (SCK)
VCC: C1.2, C6.2, JP1.5, U4.18 (VDD), U5.3 (VDD)

Notes on the sheet:
www.skpang.co.uk

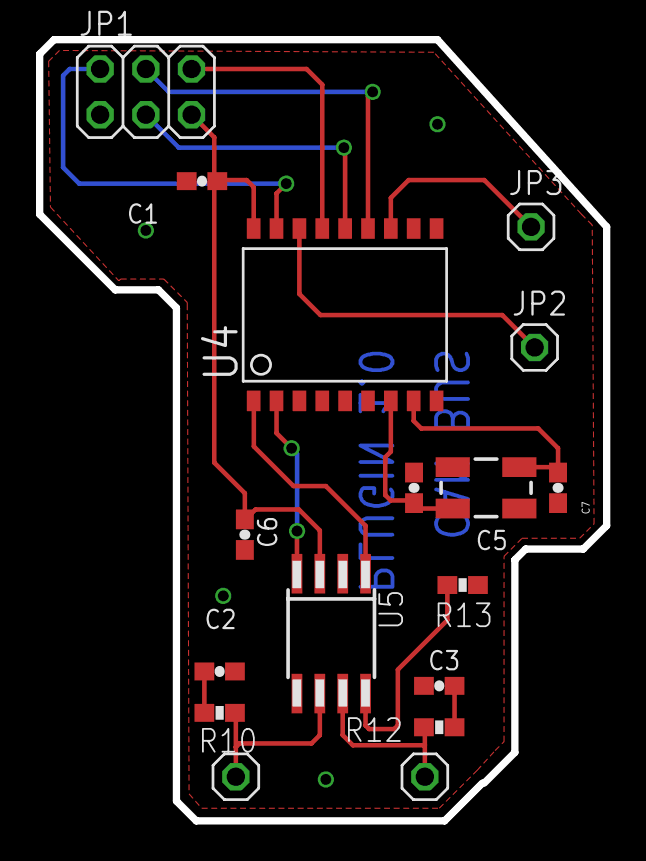
[picture p65: board canbus_shield-v1.brd from above]

Board: 2 copper layers, 31.5 x 43.4 mm, 17 parts (0 on the bottom side), 17 nets.
