PhilippSchmaelzle/speedoino/STm32F4_Firmware/src/main.cpp

#include "global.h"


timing 			Millis;
uart 			Serial;
ILI9325 		TFT;
sensing 		Sensors;
akting      	Aktors;
debugging 		Debug;
timer       	Timer;
speedo  		Speedo;
filemanager_v2 	Filemanager_v2;
sd				SD;
configuration	Config;
menu         	Menu;        // pins aktivieren, sonst nix

sprint      	Sprint;
LapTime  		LapTimer;
speedcams   	SpeedCams;
#ifdef DEMO_MODE
speedo_demo Demo;
#endif



void init_speedo(void){
	Millis.init();
	Serial.init(USART1,115200);
	Serial.init(USART2,115200);
	Serial.init(USART3,115200);



	Serial.puts_ln(USART1,"=== Speedoino ===");
	Serial.puts(USART1,GIT_REV);                // print Software release
	Serial.puts(USART1," HW:");
	Serial.puts_ln(USART1,Config.get_hw_version());    // print Hardware release

	// first, set all variables to a zero value
	Sensors.init();
	Speedo.clear_vars();        // refresh cycle
	// read configuration file from sd card
	SD.init();                 // try open SD Card
	Config.read(CONFIG_FOLDER,"BASE.TXT",READ_MODE_CONFIGFILE,"");     	// load base config
	Config.read(CONFIG_FOLDER,"SPEEDO.TXT",READ_MODE_CONFIGFILE,"");    // speedovalues, avg,max,time
	Config.read(CONFIG_FOLDER,"GANG.TXT",READ_MODE_CONFIGFILE,"");   	// gang
	Config.read(CONFIG_FOLDER,"TEMPER.TXT",READ_MODE_CONFIGFILE,"");    // Temperatur
	Config.read_skin();        // skinning
	//	check if read SD read was okay, if not: load your default backup values
	Aktors.check_vars();        // check if color of outer LED are OK
	Sensors.check_vars();        // check if config read was successful
	Speedo.check_vars();        // rettet das Skinning wenn SD_failed von den sensoren auf true gesetzt wird
	Sensors.single_read();    // read all sensor values once to ensure we are ready to show them
	Aktors.init();            // Start outer LEDs // ausschlag des zeigers // Motorausschlag und block bis motor voll ausgeschlagen, solange das letzte intro bild halten
	TFT.init();
	//	pOLED.init_speedo();         // Start Screen //execute this AFTER Config->init(), init() will load  phase,config,startup. PopUp will be shown if sd access fails
	Menu.init();                 // Start butons // adds the connection between pins and vars
	Menu.display();             // execute this AFTER pOLED.init_speedo!! this will show the menu and, if state==11, draws speedosymbols
	Speedo.reset_bak();         // reset all storages, to force the redraw of the speedo
	Config.ram_info();
	Serial.puts_ln(USART1,"=== Setup finished ===");

}


int main(void) {
	init_speedo();


//	const uint8_t Emo2_Jpg_Table[] = {
//	0xFF,0xD8,0xFF,0xE0,0x00,0x10,0x4A,0x46,0x49,0x46,0x00,0x01,0x01,0x01,0x00,0x60,
//	0x00,0x60,0x00,0x00,0xFF,0xDB,0x00,0x43,0x00,0x08,0x06,0x06,0x07,0x06,0x05,0x08,
//	0x07,0x07,0x07,0x09,0x09,0x08,0x0A,0x0C,0x14,0x0D,0x0C,0x0B,0x0B,0x0C,0x19,0x12,
//	0x13,0x0F,0x14,0x1D,0x1A,0x1F,0x1E,0x1D,0x1A,0x1C,0x1C,0x20,0x24,0x2E,0x27,0x20,
//	0x22,0x2C,0x23,0x1C,0x1C,0x28,0x37,0x29,0x2C,0x30,0x31,0x34,0x34,0x34,0x1F,0x27,
//	0x39,0x3D,0x38,0x32,0x3C,0x2E,0x33,0x34,0x32,0xFF,0xDB,0x00,0x43,0x01,0x09,0x09,
//	0x09,0x0C,0x0B,0x0C,0x18,0x0D,0x0D,0x18,0x32,0x21,0x1C,0x21,0x32,0x32,0x32,0x32,
//	0x32,0x32,0x32,0x32,0x32,0x32,0x32,0x32,0x32,0x32,0x32,0x32,0x32,0x32,0x32,0x32,
//	0x32,0x32,0x32,0x32,0x32,0x32,0x32,0x32,0x32,0x32,0x32,0x32,0x32,0x32,0x32,0x32,
//	0x32,0x32,0x32,0x32,0x32,0x32,0x32,0x32,0x32,0x32,0x32,0x32,0x32,0x32,0xFF,0xC0,
//	0x00,0x11,0x08,0x00,0x78,0x00,0xA0,0x03,0x01,0x22,0x00,0x02,0x11,0x01,0x03,0x11,
//	0x01,0xFF,0xC4,0x00,0x1F,0x00,0x00,0x01,0x05,0x01,0x01,0x01,0x01,0x01,0x01,0x00,
//	0x00,0x00,0x00,0x00,0x00,0x00,0x00,0x01,0x02,0x03,0x04,0x05,0x06,0x07,0x08,0x09,
//	0x0A,0x0B,0xFF,0xC4,0x00,0xB5,0x10,0x00,0x02,0x01,0x03,0x03,0x02,0x04,0x03,0x05,
//	0x05,0x04,0x04,0x00,0x00,0x01,0x7D,0x01,0x02,0x03,0x00,0x04,0x11,0x05,0x12,0x21,
//	0x31,0x41,0x06,0x13,0x51,0x61,0x07,0x22,0x71,0x14,0x32,0x81,0x91,0xA1,0x08,0x23,
//	0x42,0xB1,0xC1,0x15,0x52,0xD1,0xF0,0x24,0x33,0x62,0x72,0x82,0x09,0x0A,0x16,0x17,
//	0x18,0x19,0x1A,0x25,0x26,0x27,0x28,0x29,0x2A,0x34,0x35,0x36,0x37,0x38,0x39,0x3A,
//	0x43,0x44,0x45,0x46,0x47,0x48,0x49,0x4A,0x53,0x54,0x55,0x56,0x57,0x58,0x59,0x5A,
//	0x63,0x64,0x65,0x66,0x67,0x68,0x69,0x6A,0x73,0x74,0x75,0x76,0x77,0x78,0x79,0x7A,
//	0x83,0x84,0x85,0x86,0x87,0x88,0x89,0x8A,0x92,0x93,0x94,0x95,0x96,0x97,0x98,0x99,
//	0x9A,0xA2,0xA3,0xA4,0xA5,0xA6,0xA7,0xA8,0xA9,0xAA,0xB2,0xB3,0xB4,0xB5,0xB6,0xB7,
//	0xB8,0xB9,0xBA,0xC2,0xC3,0xC4,0xC5,0xC6,0xC7,0xC8,0xC9,0xCA,0xD2,0xD3,0xD4,0xD5,
//	0xD6,0xD7,0xD8,0xD9,0xDA,0xE1,0xE2,0xE3,0xE4,0xE5,0xE6,0xE7,0xE8,0xE9,0xEA,0xF1,
//	0xF2,0xF3,0xF4,0xF5,0xF6,0xF7,0xF8,0xF9,0xFA,0xFF,0xC4,0x00,0x1F,0x01,0x00,0x03,
//	0x01,0x01,0x01,0x01,0x01,0x01,0x01,0x01,0x01,0x00,0x00,0x00,0x00,0x00,0x00,0x01,
//	0x02,0x03,0x04,0x05,0x06,0x07,0x08,0x09,0x0A,0x0B,0xFF,0xC4,0x00,0xB5,0x11,0x00,
//	0x02,0x01,0x02,0x04,0x04,0x03,0x04,0x07,0x05,0x04,0x04,0x00,0x01,0x02,0x77,0x00,
//	0x01,0x02,0x03,0x11,0x04,0x05,0x21,0x31,0x06,0x12,0x41,0x51,0x07,0x61,0x71,0x13,
//	0x22,0x32,0x81,0x08,0x14,0x42,0x91,0xA1,0xB1,0xC1,0x09,0x23,0x33,0x52,0xF0,0x15,
//	0x62,0x72,0xD1,0x0A,0x16,0x24,0x34,0xE1,0x25,0xF1,0x17,0x18,0x19,0x1A,0x26,0x27,
//	0x28,0x29,0x2A,0x35,0x36,0x37,0x38,0x39,0x3A,0x43,0x44,0x45,0x46,0x47,0x48,0x49,
//	0x4A,0x53,0x54,0x55,0x56,0x57,0x58,0x59,0x5A,0x63,0x64,0x65,0x66,0x67,0x68,0x69,
//	0x6A,0x73,0x74,0x75,0x76,0x77,0x78,0x79,0x7A,0x82,0x83,0x84,0x85,0x86,0x87,0x88,
//	0x89,0x8A,0x92,0x93,0x94,0x95,0x96,0x97,0x98,0x99,0x9A,0xA2,0xA3,0xA4,0xA5,0xA6,
//	0xA7,0xA8,0xA9,0xAA,0xB2,0xB3,0xB4,0xB5,0xB6,0xB7,0xB8,0xB9,0xBA,0xC2,0xC3,0xC4,
//	0xC5,0xC6,0xC7,0xC8,0xC9,0xCA,0xD2,0xD3,0xD4,0xD5,0xD6,0xD7,0xD8,0xD9,0xDA,0xE2,
//	0xE3,0xE4,0xE5,0xE6,0xE7,0xE8,0xE9,0xEA,0xF2,0xF3,0xF4,0xF5,0xF6,0xF7,0xF8,0xF9,
//	0xFA,0xFF,0xDA,0x00,0x0C,0x03,0x01,0x00,0x02,0x11,0x03,0x11,0x00,0x3F,0x00,0xEF,
//	0x2E,0x2F,0x14,0x93,0xC8,0xAC,0xBB,0x8B,0xA1,0x9E,0x2B,0x1A,0x5D,0x4C,0x67,0xEF,
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
//	};
//
//
//	//--------------------------------------------------------------
//	// Picture-Struktur
//	//--------------------------------------------------------------
//	UB_Picture Emo2_Jpg = {
//	  Emo2_Jpg_Table, // Picture-Daten
//	  5714,         // Anzahl der Bytes
//	};
//
//	uint32_t start=Millis.get();
//	TFT.UB_Graphic_DrawJpg(&Emo2_Jpg,60,10);
//	Serial.puts(USART1,"Time:");
//	Serial.puts(USART1,(int)(Millis.get()-start));
//	while(1);

//	TFT.draw_bmp(0,0,(uint8_t*)"/kojla.bmp");
//	_delay_ms(5000);
	TFT.clear_screen();
	TFT.draw_bmp(0,100,(uint8_t*)"/logo.bmp");
	_delay_ms(1000);
	TFT.clear_screen();

	//	TFT.draw_bmp(0,0,"test.bmp");

	/******************** setup procedure ********************************************
	 * all initialisations must been made before the main loop, before THIS
	 ******************** setup procedure ********************************************/
	unsigned long   previousMillis = 0;
#ifdef LOAD_CALC
	unsigned long load_calc=0;
	unsigned long lasttime_calc=0;
#endif

	for (;;) {
		Sensors.mCAN.check_message();
		//////////////////////////////////////////////////
		//		Sensors.m_reset->set_deactive(false,false);
		//		Serial3.end();
		//		Serial3.begin(115200);
		//		while(true){
		//			while(Serial3.available()>0){
		//				Serial.print(Serial3.read(),BYTE);
		//			}
		//			while(Serial.available()>0){
		//				Serial3.print(Serial.read(),BYTE);
		//			}
		//		}
		//////////////////////////////////////////////////
		Sensors.mReset.toggle(); 		// toggle pin, if we don't toggle it, the ATmega8 will reset us, kind of watchdog<
		Debug.speedo_loop(21,1,0," "); 	// intensive debug= EVERY loop access reports the Menustate
		Sensors.mGPS.check_flag();    	// check if a GPS sentence is ready
		//		pAktors.check_flag(); 				// updated expander
		Sensors.pull_values();			// very important, updates all the sensor values

		/************************* timer *********************/
		Timer.every_sec();		// 1000 ms
		Timer.every_qsec();			// 250  ms
		Timer.every_custom();  		// one custom timer, redrawing the speedo, time is defined by "refresh_cycle" in the base.txt
		/************************* push buttons *********************
		 * using true as argument, this will activate bluetooth input as well
		 ************************* push buttons*********************/
		//Menu.button_test(true,false);     // important!! if we have a pushed button we will draw something, depending on the menustate
		if(Menu.button_test(true,false)){ // important!! if we have a pushed button we will draw something, depending on the menustate
			Serial.puts(USART1,"Menustate:");
			Serial.puts_ln(USART1,Menu.state);
		}
		/************************ every deamon activity is clear, now draw speedo ********************
		 * we are round about 0000[1]1 - 0000[1]9
		 ************************ every deamon activity is clear, now draw speedo ********************/
		Sensors.mCAN.check_message();

		if((Menu.state/10)==1 || Menu.state==7311111)  {
			Speedo.loop(previousMillis);
		}
		//////////////////// Sprint Speedo ///////////////////
		else if( Menu.state==MENU_SPRINT*10+1 ) {
			Sprint.loop();
		}
		////////////////// Clock Mode ////////////////////////
		else if(Menu.state==291){
			Sensors.mClock.loop();
		}
		////////////////// Speed Cam Check - Mode ////////////////////////
		else if(Menu.state==BMP(0,0,0,0,M_TOUR_ASSISTS,SM_TOUR_ASSISTS_SPEEDCAM_STATUS,1)){
			//			SpeedCams.calc();
			//			SpeedCams.interface();
		}
		////////////////// race mode ////////////////////
		else if(Menu.state==M_LAP_T*100+11){
			LapTimer.waiting_on_speed_up();
		}
		else if(Menu.state==M_LAP_T*1000+111){
			LapTimer.race_loop();
		}
		////////////////// set gps point ////////////////////
		else if(Menu.state==M_LAP_T*10000L+3111){
			LapTimer.gps_capture_loop();
		}
		//////////////////// voltage mode ///////////////////
		else if(Menu.state==531){
			Sensors.addinfo_show_loop();
		}
		//////////////////// stepper mode ///////////////////
		else if(Menu.state==541){
			//			Aktors.mStepper.loop();
		}
		//////////////////// gps scan ///////////////////
		else if(Menu.state==511){
			Sensors.mGPS.loop();
		}
		//////////////////// outline scan ///////////////////
		else if(Menu.state==721){
			Sensors.mSpeed.check_umfang();
		}
		////////////////// gear scan ///////////////
		else if(floor(Menu.state/100)==71){
			Sensors.mGear.calibrate();
		}

#ifdef LOAD_CALC
		load_calc++;
		if(millis()-lasttime_calc>1000){
			Serial.print(load_calc);
			Serial.println(" cps"); // 182 w/o interrupts, 175 w/ interrupts, 172 w/ much interrupts
			load_calc=0;
			lasttime_calc=millis();
		}
#endif
	} // end for
}
