PhilippSchmaelzle/speedoino/ATm328_Firmware/sm_driver.h

/*This file has been prepared for Doxygen automatic documentation generation.*/
/*! \file *********************************************************************
 *
 * \brief Header file for sm_driver.c.
 *
 * - File:               sm_driver.h
 * - Compiler:           IAR EWAAVR 4.11A
 * - Supported devices:  All devices with a 16 bit timer can be used.
 *                       The example is written for ATmega48
 * - AppNote:            AVR446 - Linear speed control of stepper motor
 *
 * \author               Atmel Corporation: http://www.atmel.com \n
 *                       Support email: avr@atmel.com
 *
 * $Name: RELEASE_1_0 $
 * $Revision: 1.2 $
 * $RCSfile: sm_driver.h,v $
 * $Date: 2006/05/08 12:25:58 $
 *****************************************************************************/

#ifndef SM_DRIVER_H
#define SM_DRIVER_H

// Direction of stepper motor movement
#define CW  1
#define CCW 0

/*! \Brief Define stepping mode to use in stepper motor.
 *
 * Either halfsteps (HALFSTEPS) or fullsteps (FULLSTEPS) are allowed.
 *
 */
//#define HALFSTEPS
#define FULLSTEPS

/*! \Brief Define IO port and pins
 *
 * Set the desired drive port and pins to support your device
 *
 */
#define SM_PORT         PORTC
#define SM_DRIVE        DDRC
#define A1    PC0 //!< Stepper motor winding A positive pole.
#define A2    PC1 //!< Stepper motor winding A negative pole.
#define B1    PC2 //!< Stepper motor winding B positive pole.
#define B2    PC3 //!< Stepper motor winding B negative pole.

void sm_driver_Init_IO(void);
unsigned char sm_driver_StepCounter(signed char inc);
void sm_driver_StepOutput(unsigned char pos);

//! Position of stepper motor.
extern int stepPosition;

#endif
