PhilippSchmaelzle/speedoino/ATm2560_Firmware/gps.cpp

/* Speedoino - This file is part of the firmware.
 * Copyright (C) 2011 Kolja Windeler
 *
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
 * You should have received a copy of the GNU General Public License
 * along with this program.  If not, see <http://www.gnu.org/licenses/>.
 */

#include "global.h"

// init & clean buffer
speedo_gps::speedo_gps(){
	// parsen
	memset(gps_buffer1,'*',SERIAL_BUFFER_SIZE); // leere internen buffer
	memset(gps_buffer2,'*',SERIAL_BUFFER_SIZE); // '*' ist endchar fuer gps signale, super "filler"

	ringbuf_counter=0;
	first_dataset=true;
	gps_ready1=false;
	gps_ready2=false;
	gps_state=0;
	written_gps_points=0;
	gps_fix_temp=0;
	gps_sats_temp=0;
	gps_alt_temp=0;
	// parsen

	// navigation
	valid=99;
	entf=0;
	winkel=0; // 0-359
	inner_circle=false; // navigation
	navi_active=false; // navigation
	note_this_place=0;
	// navigation

	// speichern
	gps_count=-1;
	// speichern

	// Debug
	gps_write_status=0;
	speed=0;

	motion_start=-1;
	active_file=0; //default datei navi0.smf

	navi_ziel_lati=0;
	navi_ziel_long=0;
	navi_ziel_rl=0;
	navi_point=0;

	gps_timestamp=0;
	for(int i=0; i<30; i++){
		gps_speed_arr[i]=0;
		gps_course[i]=0;
		gps_sats[i]=0;
		gps_fix[i]=0;
		gps_special[i]=0;
		gps_alt[i]=0;
		gps_date[i]=0;
		gps_time[i]=0;
	}

	use_compressed_log_format=false; // reduces filesize to 24%

	gps_goody.latitude=0;
	gps_goody.longitude=0;
	gps_lati_cos=100;							// current location weight factor
	checksum=0x00;
};

speedo_gps::~speedo_gps(){
};

// redirect to statemachine
ISR(USART1_RX_vect){
	pSensors->m_gps->recv_data();
};

void speedo_gps::init(){
	// interrupt + UART
#ifndef F_CPU
#warning "F_CPU war noch nicht definiert, wird nun nachgeholt mit 16Mhz"
#define F_CPU 16000000UL // Systemtakt in Hz - Definition als unsigned long beachten
#endif
#define UART_BAUD_SELECT(baudRate,xtalCpu) (((float)(xtalCpu))/(((float)(baudRate))*8.0)-1.0+0.5)
#define BAUDRATE_9600 9600
#define BAUDRATE_19200 19200
#define BAUDRATE_115200 115200
	// set own UART datarate to 19200 @16MHz clock
	// $GPRMC,191410,A,4735.5634,N,00739.3538,E,0.0,0.0,181102,0.4,E,A*19\0D\0A$GPGGA,191410,4735.5634,N,00739.3538,E,1,04,4.4,351.5,M,48.0,M,,*45\0D\0A
	// At 100ms spacing: 141*10 = byte per sec
	// 1410 byte per sec * 10(baud/byte) = 14100 baud -> use 19200
	UBRR1L	=	UART_BAUD_SELECT(BAUDRATE_19200,F_CPU); // new since 29.8.
	UCSR1B |=	(1<<RXEN1)|(1<<TXEN1)|(1<<RXCIE1); // rx,tx,rx interrupt
	UCSR1A |= 	(1<<U2X1); // Double the USART Transmission Speed
	sei();


	pDebug->sprintlnp(PSTR("GPS init done"));
};


int speedo_gps::check_vars(){
	if(navi_active){
		generate_new_order();
	}
	return 0;
};

bool speedo_gps::wait_on_gps(){
	return first_dataset;
}

void speedo_gps::update_rate_1Hz(){
	SendString(PSTR("$PMTK220,1000*1F\r\n"));
	SendString(PSTR("$PMTK314,0,1,0,1,0,0,0,0,0,0,0,0,0,0,0,0,0*28\r\n"));
}

void speedo_gps::update_rate_10Hz(){
	SendString(PSTR("$PMTK220,100*2F\r\n"));
	SendString(PSTR("$PMTK314,0,1,0,5,0,0,0,0,0,0,0,0,0,0,0,0,0*2C\r\n"));
}


void speedo_gps::reconfigure(){
	//Serial.println("GPS failed, reconfiguring");
	// Berechnungen
	unsigned long baud_rates[3]={9600,19200,115200};
	for(uint8_t i=0;i<sizeof(baud_rates)/sizeof(baud_rates[0]);i++){
		UBRR1L	=	UART_BAUD_SELECT(baud_rates[i],F_CPU);
		UCSR1B |= (1<<RXEN1)|(1<<TXEN1)|(1<<RXCIE1); // rx,tx,rx interrupt
		UCSR1A |= (1 <<U2X1); // Double the USART Transmission Speed
		sei(); // global anschalten, falls sie es nicht ohnehin schon sind
		SendString(PSTR("$PMTK314,0,1,0,1,0,0,0,0,0,0,0,0,0,0,0,0,0*28\r\n"));
		// set GPS UART datarate to 19200:
		SendString(PSTR("$PMTK251,19200*22\r\n"));
		_delay_ms(100); // time needed to send the last char
	}

	UBRR1L	=	UART_BAUD_SELECT(BAUDRATE_19200,F_CPU);
	UCSR1B |=	(1<<RXEN1)|(1<<TXEN1)|(1<<RXCIE1); // rx,tx,rx interrupt
	UCSR1A |= 	(1<<U2X1); // Double the USART Transmission Speed
	sei();
}

// wird als interrupt aufgerufen
// prüft ob daten da sind, die valid sind
// wenn ja dann wird get_GPS damit aufgerufen
void speedo_gps::recv_data(){
	char byteGPS = UDR1;
//	Serial.print(byteGPS); // remove me
	switch(gps_state){
	case 0:  // hier sitzen wir und warten auf das startzeichen
		if(byteGPS=='$'){
			gps_state=1;
			checksum=0x00;
		};
		break;
	case 1:  // das wird dann ein "G" sein
		gps_state=2;
		checksum^=byteGPS;
		break;
	case 2: // ein "P"
		gps_state=3;
		checksum^=byteGPS;
		break;
	case 3: // hier wirds interessant: isses ein ein R oder G ?
		if(byteGPS=='R'){
			gps_state=4;
			checksum^=byteGPS;
		} else if(byteGPS=='G'){
			gps_state=14; // hier mal einfach um 10 weiterspringen
			checksum^=byteGPS;
		} else {
			gps_state=0;
		};
		break;
	case 4: // auch noch interessant, hier müsste auf das R ein M folgen
		if(byteGPS=='M'){ // jaha
			gps_state=5;
			checksum^=byteGPS;
		} else {			// schade, doch nüscht
			gps_state=0;
		}
		break;
	case 5: // soweit gut $GPRM fehlt das C
		if(byteGPS=='C'){// jaha, ab in den "lese modus"
			ringbuf_counter=0; // position in die geschrieben werden soll
			gps_state=6;
			checksum^=byteGPS;
		} else			// schade, doch nüscht
			gps_state=0;
		break;
	case 6:
		if(ringbuf_counter>=SERIAL_BUFFER_SIZE-1){ gps_state=0; break; }    // überlauf, kein gps wert ist länger als 75 Byte. Mist
		gps_buffer1[ringbuf_counter]=byteGPS;   // in den buffer schmei�?en
		if(byteGPS=='*'){                // * das ist mein end signal dann is ende im gelände und abmarsch
			gps_state=7;
		} else if(byteGPS=='$'){ // damn da haben wir was verpasst
			checksum=0x00;
			gps_state=1; // jump start
		} else { // es scheint also ein ganz normales zeichen zu sein, dann könnte nur noch der hier schief gehen
			ringbuf_counter++;
			checksum^=byteGPS;
		}
		break;
	case 7: // checksum
		if(byteGPS>='A' && byteGPS<='F'){
			byteGPS=byteGPS-'A'+10;
		} else {
			byteGPS=byteGPS-'0';
		}
		checksum-=(byteGPS<<4);
		gps_state=8;
		break;
	case 8:
		if(byteGPS>='A' && byteGPS<='F'){
			byteGPS=byteGPS-'A'+10;
		} else {
			byteGPS=byteGPS-'0';
		}

		if(byteGPS==checksum){
			gps_ready1=true;
		}
		gps_state=0;
		break;
	case 14: // auch noch interessant, hier müsste auf das GPG ein G und dann ein A folgen
		if(byteGPS=='G'){ // jaha
			gps_state=15;
			checksum^=byteGPS;
		} else			// schade, doch nüscht
			gps_state=0;
		break;
	case 15: // jetzt fehlt nur noch das A
		if(byteGPS=='A'){ // jaha
			ringbuf_counter=0; // position in die geschrieben werden soll
			gps_state=16;
			checksum^=byteGPS;
		} else			// schade, doch nüscht
			gps_state=0;
		break;
	case 16:
		if(ringbuf_counter>=SERIAL_BUFFER_SIZE){ gps_state=0; break; }    // überlauf, kein gps wert ist länger als 75 Byte. Mist
		gps_buffer2[ringbuf_counter]=byteGPS;   // in den buffer schmei�?en
		if(byteGPS=='*'){                // * das ist mein end signal dann is ende im gelände und abmarsch
			gps_state=17;
		} else if(byteGPS=='$'){ // damn da haben wir was verpasst
			gps_state=1; // jump start
			checksum=0x00;
		} else { // es scheint also ein ganz normales zeichen zu sein, dann könnte nur noch der hier schief gehen
			ringbuf_counter++;
			checksum^=byteGPS;
		}
		break;
	case 17: // checksum
		if(byteGPS>='A' && byteGPS<='F'){
			byteGPS=byteGPS-'A'+10;
		} else {
			byteGPS=byteGPS-'0';
		}
		checksum-=(byteGPS<<4);
		gps_state=18;
		break;
	case 18:
		if(byteGPS>='A' && byteGPS<='F'){
			byteGPS=byteGPS-'A'+10;
		} else {
			byteGPS=byteGPS-'0';
		}

		if(byteGPS==checksum){
			gps_ready2=true;
		}
		gps_state=0;
		break;
		// end case 
	}
};

/* diese funktion wird in jeder for schleife abgegra�?t und fall hier ein flag auf true steht
 * werden die daten geparst
 */
void speedo_gps::check_flag(){
	if(gps_ready1){
		// debug
#ifdef GPS_DEBUG
		pDebug->sprintlnp(PSTR("calling get_gps buffer1:"));
		Serial.println(gps_buffer1);
#endif
#ifdef TACHO_SMALLDEBUG
		pDebug->sprintp(PSTR("-g"));
#endif
		// debug
		parse(gps_buffer1,1);         // Daten übergeben
		gps_ready1=false;
#ifdef TACHO_SMALLDEBUG
		pDebug->sprintlnp(PSTR("."));
#endif
	};

	if(gps_ready2){
		// debug
#ifdef GPS_DEBUG
		pDebug->sprintlnp(PSTR("calling get_gps buffer2:"));
		Serial.println(gps_buffer2);
#endif
#ifdef TACHO_SMALLDEBUG
		pDebug->sprintp(PSTR("-g"));
#endif
		// debug
		parse(gps_buffer2,2);         // Daten übergeben
		gps_ready2=false;
#ifdef TACHO_SMALLDEBUG
		pDebug->sprintlnp(PSTR("."));
#endif
	};
};

/* parsen von nmea daten zu gps daten
 * im dümmsten fall haben wir die beiden Datensätze direkt hinter einander
 * dann haben wir durch die Statemashine 2 Byte für die Prüfsumme und 6 Byte für die anfangssequnz bis wir
 * in den gleichen serial_buffer reinschreiben
 * bei 4800 Baud sind das 1,6 ms für den Spass hier unten .. nicht gerade üppig
 * datensatz=1 => $GPRMC
 */
void speedo_gps::parse(char linea[SERIAL_BUFFER_SIZE],int datensatz){
	int cont=0;
	char status;
	int indices[13]; // positionsmarker für die kommata

	//debug
#ifdef GPS_DEBUG
	pDebug->sprintlnp(PSTR("get_gps hat bekommen: "));
	for(int i=0;i<SERIAL_BUFFER_SIZE;i++){
		Serial.print(linea[i]);
	};
	Serial.println("");
#endif
	//debug
	// seperatorstellen suchen
	for (int i=0;i<SERIAL_BUFFER_SIZE;i++){
		if (linea[i]==','){    // check for the position of the  "," separator
			indices[cont]=i;
			cont=(cont+1)%13; // to prevent buffer overrun
		}
	}
	// modus 1, $gprmc empfangen
	if(datensatz==1){ // lat,long,fix,time,Course,date
		/*
	        $GPRMC,191410,A,4735.5634,N,00739.3538,E,0.0,0.0,181102,0.4,E,A*19
				   ^      ^ ^           ^            ^   ^   ^      ^     ^
				   |      | |           |            |   |   |      |     |
				   |      | |           |            |   |   |      |     Neu in NMEA 2.3:
				   |      | |           |            |   |   |      |     Art der Bestimmung
				   |      | |           |            |   |   |      |     A=autonomous (selbst)
				   |      | |           |            |   |   |      |     D=differential
				   |      | |           |            |   |   |      |     E=estimated (geschätzt)
				   |      | |           |            |   |   |      |     N=not valid (ungültig)
				   |      | |           |            |   |   |      |     S=simulator
				   |      | |           |            |   |   |      |
				   |      | |           |            |   |   |      Missweisung (mit Richtung)
				   |      | |           |            |   |   |
				   |      | |           |            |   |   Datum: 18.11.2002
				   |      | |           |            |   |
				   |      | |           |            |   Bewegungsrichtung in Grad (wahr)
				   |      | |           |            |
				   |      | |           |            Geschwindigkeit über Grund (Knoten)
				   |      | |           |
				   |      | |           Längengrad mit (Vorzeichen)-Richtung (E=Ost, W=West)
				   |      | |           007° 39.3538' Ost
				   |      | |
				   |      | Breitengrad mit (Vorzeichen)-Richtung (N=Nord, S=Süd)
				   |      | 46° 35.5634' Nord
				   |      |
				   |      Status der Bestimmung: A=Active (gültig); V=void (ungültig)
				   |
				   Uhrzeit der Bestimmung: 19:14:10 (UTC-Zeit)
		 *
		 */
		status=linea[indices[1]+1];

		// zeit in jedem fall berechnen, auch wenn das sample nicht valid ist, das ist der RTC
		long temp_gps_time=0;
		long temp_gps_date=0;
		for (int j=indices[0]+1;j<indices[1];j++){ // format 234500.000 für füddelvorzwölf
			if(linea[j]>='0' && linea[j]<='9'){
				temp_gps_time=temp_gps_time*10+(linea[j]-'0');
			}
		}

		for (int j=indices[8]+1;j<(indices[9]) && linea[j]>='0' && linea[j]<='9';j++){
			temp_gps_date=temp_gps_date*10+(linea[j]-'0'); //181102 für 18.Nov 2002
		}

		if(first_dataset || status=='A'){ // wenn die daten gültig sind oder es der erste datensatz ist
			if(temp_gps_date>=010100 && temp_gps_date<=311299 && temp_gps_date%100!=180){ // 0X0180 is power up date <- ignore that
				pSensors->m_clock->set_date_time(
						int(mod(temp_gps_date,100)),
						int(floor(temp_gps_date/100))%100,
						int(floor(temp_gps_date/10000)),
						int(floor(temp_gps_time/10000000))%24, 						// 234512000 für füddelvorzwölf -> 234512000/10000000 = 23 -> 23%24=23
						int(floor(temp_gps_time/100000))%100,  						// 234512000 für füddelvorzwölf -> 234512000/100000 = 2345 -> 2345%100=45
						int(mod((unsigned long)(floor(temp_gps_time/1000)),100)), 	// 234512000 für füddelvorzwölf -> 234512000/1000 = 234512 -> 234512 mod 100 = 12 // std "%" can be use case 23.45.12 > 32768
						first_dataset
				);
			};

			if(first_dataset){
				//Serial.println("GPS connected, configuring data");
				pConfig->day_trip_check();
				//configure GPS
				update_rate_1Hz();
				first_dataset=false;
			}
		};

		if(status=='A'){ // only evaluate if valid (A means valid)
			valid=0;
			if(gps_count<(signed(sizeof(gps_time)/sizeof(gps_time[0])-1))){ // [0] .. [29] = 30 Einträge
				gps_count++;
			}
			// alle leeren
			gps_long[gps_count]=0;
			gps_lati[gps_count]=0;
			gps_speed_arr[gps_count]=0;
			gps_course[gps_count]=0;
			gps_special[gps_count]=note_this_place;
			set_gps_mark(STD_MARK); // reset
			gps_time[gps_count]=temp_gps_time;
			gps_date[gps_count]=temp_gps_date;
			// calc some nice values
			gps_timestamp=GpsTimeToTimeStamp(temp_gps_time);

			for (int j=indices[7]+1;j<(indices[8])-2;j++){ // keine Nachkommastelle mehr
				if(linea[j]!=46){
					gps_course[gps_count]=gps_course[gps_count]*10+(linea[j]-48);
				};
			}
			for (int j=indices[2]+1;j<(indices[3]);j++){ // keine Nachkommastelle mehr, punktkiller format 1-3 vorkomma und immer 6(!) nachkomma
				if(linea[j]!=46){
					gps_lati[gps_count]=gps_lati[gps_count]*10+(linea[j]-48);
				};
			}

			for (int j=indices[4]+1;j<(indices[5]);j++){ // keine Nachkommastelle mehr, punktkiller format 1-3 vorkomma und immer 6(!) nachkomma
				if(linea[j]!=46){
					gps_long[gps_count]=gps_long[gps_count]*10+(linea[j]-48);
				};
			}

			for (int j=indices[6]+1;j<(indices[7]);j++){
				if(linea[j]!=46){
					gps_speed_arr[gps_count]=gps_speed_arr[gps_count]*10+(linea[j]-48);
				};
			}
			gps_speed_arr[gps_count]=round(gps_speed_arr[gps_count]/54);//round((gps_speed_arr[gps_count]*1.852)/100); // auf kmh umbbiegen
			speed=gps_speed_arr[gps_count];

			gps_alt[gps_count]=gps_alt_temp;
			gps_sats[gps_count]=gps_sats_temp;
			gps_fix[gps_count]=gps_fix_temp;

			// notify other modules
			if(pMenu->state==11 || pMenu->state==M_TOUR_ASSISTS*100+SM_TOUR_ASSISTS_SPEEDCAM_STATUS*10+1){ // regular speedo or "show" mode
				if(pSpeedCams->get_active()){
					pSpeedCams->set_gps_outdated();
				}
			}


			// debug
#ifdef GPS_DEBUG
			pDebug->sprintp(PSTR("Time in UTC (HhMmSs): "));
			Serial.println(gps_time[gps_count]);
			pDebug->sprintp(PSTR("Date UTC (DdMmAa) "));
			Serial.println(gps_date[gps_count]);
			pDebug->sprintp(PSTR("Heading in degrees:(*10)"));
			Serial.println(gps_course[gps_count]);
			pDebug->sprintp(PSTR("Latitude: "));
			Serial.println(gps_lati[gps_count]);
			pDebug->sprintp(PSTR("Longitude: "));
			Serial.println(gps_long[gps_count]);
			pDebug->sprintp(PSTR("Speed kmh: "));
			Serial.println(gps_speed_arr[gps_count]);
#endif
			//Debug
			// uiuiuiuiuiuiui
#ifdef NAVI_DEBUG
			pDebug->sprintp(PSTR("Zeit vorm gps_navi: "));
			Serial.println(millis());
#endif
			if(navi_active){ // only calc if needed
				calc_navi();
			}

#ifdef NAVI_DEBUG
			pDebug->sprintp(PSTR("Zeit nach gps_navi: "));
			Serial.println(millis());
#endif
			// uiuiuiuiuiuiui
		}
		set_drive_status(speed,int(floor(temp_gps_time/1000))%100,gps_sats[gps_count],status);
	} // anderer modus, gpgga empfangen
	else if(datensatz==2){ // altitude, fix ok?,sats,
		/* GPS Datensatz 2:
        $GPGGA,191410,4735.5634,N,00739.3538,E,1,04,4.4,351.5,M,48.0,M,,*45
			   ^      ^           ^            ^ ^  ^   ^       ^
			   |      |           |            | |  |   |       |
			   |      |           |            | |  |   |       Höhe Geoid minus
			   |      |           |            | |  |   |       Höhe Ellipsoid (WGS84)
			   |      |           |            | |  |   |       in Metern (48.0,M)
			   |      |           |            | |  |   |
			   |      |           |            | |  |   Höhe über Meer (über Geoid)
			   |      |           |            | |  |   in Metern (351.5,M)
			   |      |           |            | |  |
			   |      |           |            | |  HDOP (horizontal dilution
			   |      |           |            | |  of precision) Genauigkeit
			   |      |           |            | |
			   |      |           |            | Anzahl der erfassten Satelliten
			   |      |           |            |
			   |      |           |            Qualität der Messung
			   |      |           |            (0 = ungültig)
			   |      |           |            (1 = GPS)
			   |      |           |            (2 = DGPS)
			   |      |           |            (6 = geschätzt nur NMEA-0183 2.3)
			   |      |           |
			   |      |           Längengrad
			   |      |
			   |      Breitengrad
			   |
			   Uhrzeit
		 *
		 *	fix=Qualität der Messung (zwischen dem 5. und 6. ",")
		 *	sats=Anzahl der erfassten Satelliten (zwischen dem 6. und 7. ",")
		 *
		 */
		gps_alt_temp=0;
		gps_sats_temp=0;
		for (int j=indices[5]+1;j<(indices[6]);j++){
			gps_fix_temp=(linea[j]-48);
		};
		if(gps_fix_temp>0 && valid<5){ //innerhalb der letzten 5 sec ein valid bekommen && fix>0
			for (int j=indices[6]+1;j<(indices[7]);j++){
				gps_sats_temp=gps_sats_temp*10+(linea[j]-48);
			}
			for (int j=indices[8]+1;j<(indices[9]);j++){
				if(linea[j]!=46){
					gps_alt_temp=gps_alt_temp*10+(linea[j]-48);
				};
			}
			if(gps_alt_temp>100000){ // sind wir höher als 10 km?
				gps_alt_temp=0;
			}
		};

		//debug
#ifdef GPS_DEBUG
		pDebug->sprintp(PSTR("alt: "));
		Serial.println(gps_alt_temp);
		pDebug->sprintp(PSTR("sats: "));
		Serial.println(gps_sats_temp);
		pDebug->sprintp(PSTR("fix? 1==ja: "));
		Serial.println(gps_fix_temp);
#endif
		//debug
	};
	if(gps_count>=29){ // save every 30 datapoints as burst ... compromise between RAM usage and burst size

#ifdef SD_DEBUG
		pDebug->sprintlnp(PSTR("Vor store_to_sd()"));
		Serial.println(millis());
#endif

		gps_write_status=1;
		if(pSensors->get_RPM(RPM_TYPE_DIRECT)>0){
			if(store_to_sd()>=0){ //to save 30 datapoints about 70ms SD write time are needed
				gps_count=-1; // after writing the points to sd => erase them, parse will count up to 0 for us
			}
		};

#ifdef SD_DEBUG
		pDebug->sprintlnp(PSTR("nach store_to_sd()"));
		Serial.println(millis());
#endif
	} else {
#ifdef SD_DEBUG
		pDebug->sprintp(PSTR("store_to_sd() not enough records "));
		Serial.print(gps_count);
		Serial.print(" written ");
		Serial.print(written_gps_points);
		Serial.print(" datensatz ");
		Serial.print(datensatz);
		Serial.print(" ");
		Serial.println(millis());
#endif
	}
};

// return values of the gps_field, convertet as long
long speedo_gps::get_info(unsigned char select){
	int inner_gps_count=gps_count;
	if(gps_count==-1){
		inner_gps_count=29;
	};

	switch(select){
	case 0:
		return floor(gps_time[inner_gps_count]/1000);
		break;
	case 1:
		return gps_date[inner_gps_count];
		break;
	case 2:
#ifdef GPS_FAKE_MODE
		//return 9456000+(int)(floor(millis()/50))%200;
		return 6960577;
#endif
		return gps_long[inner_gps_count];
		break;
	case 3:
#ifdef GPS_FAKE_MODE
		//return 52123000+(int)(floor(millis()/50))%200;
		return 50937661;
#endif
		return gps_lati[inner_gps_count];
		break;
	case 4:
		return gps_alt[inner_gps_count];
		break;
	case 5:
		return long(gps_speed_arr[inner_gps_count]);
		break;
	case 6:
#ifdef GPS_FAKE_MODE
		return 6;
#endif
		if(valid>=3){ return 0; };
		if(long(gps_sats[inner_gps_count])>20) { return 20; }; //höhö
		if(long(gps_sats[inner_gps_count])<0) { return 0; };
		return long(gps_sats[inner_gps_count]);
		break;
	case 7:
		return long(gps_fix[inner_gps_count]);
		break;
	case 8:
		return long(gps_course[inner_gps_count]);
		break;
	case 9:
#ifdef GPS_FAKE_MODE
		return 0; //todo
#endif
		return valid;
		break;
	case 10:
#ifdef GPS_FAKE_MODE
		return floor(millis()/100)*100; //
#endif
		return gps_time[inner_gps_count];
		break;
	case 11:
#ifdef GPS_FAKE_MODE
		return floor(millis()/100)*100; //
#endif
		return gps_timestamp;
	}
	return -1;
};

// alle 30 gültigen gps sample einmalauf der SD speichern bitte
// im kolja_gps format -> yeah blo�? nix bekanntes, kompatibles verwenden, alles properitär machen :D
int speedo_gps::store_to_sd(){
	// generate filename && store
	char *filename;
	filename = (char*) malloc (11);
	if (filename==NULL) pDebug->sprintlnp(PSTR("Malloc failed"));
	else memset(filename,'\0',11);

	// 20.3.2011 => 110320
	if(pSensors->m_clock->get_long_date()!=999999){
		sprintf(filename,"%06lu.GPS",pSensors->m_clock->get_long_date());
#ifdef SD_DEBUG
		pDebug->sprintlnp(PSTR("filename is "));
		Serial.println(filename);
#endif
	} else {
		return -1;
	}


	gps_write_status=2;
	// das kann auch ruhig alle 30 sec gemacht werden
	//pSensors->m_clock->store();
	pConfig->storage_outdated=true; // damit geschrieben werden darf
	gps_write_status=3;
	pConfig->write(filename); // schreiben

	free(filename);
	//done
	return 0;
};

/********* berechnung der distanz ***********
 * eingabe als ul in dezimalgrad*10^6 => 9473208.0;
 * aktuelle Position ist im array gps_lati/gps_long
 * LATI ist immer !! 111km pro Grad und ist quasi die y koodinate
 * LONG ist x Richtung und im Abstand ist abhängig von der Latitude, bei 0 ist er auch 111km bei 90° = 0km
 * Ausgabe als meter! och dann können wir maximal ein paar mio km fahren, wirs nix mit zum mars ..
 * Laufzeit ca 757µs bei 16MHz = 12112 Takte .. puh
 ********************************************/
unsigned long speedo_gps::calc_dist(unsigned long longitude,unsigned long latitude){
	if(valid>5) return -1; // rollt über und ist dann unendlich riesig

	float dist_y,dist_x; // abstands vars
	unsigned long actual_long=nmea_to_dec(gps_long[gps_count]);
	unsigned long actual_lati=nmea_to_dec(gps_lati[gps_count]);

	// können wir nicht mit abs machen, weil das unsigned ist
	if( actual_lati > latitude){
		dist_y=(float)(actual_lati - latitude); // direkt
	} else {
		dist_y=(float)(latitude - actual_lati); // direkt
	}
	// können wir nicht mit abs machen, weil das unsigned ist
	if( actual_long > longitude){
		// hier kommen grad*106 raus
		dist_x=(float)(actual_long - longitude); // erstmal ungewichtet
	} else {
		dist_x=(float)(longitude - actual_long); // erstmal ungewichtet
	}

	dist_x=round(dist_x*cos(floor((latitude+actual_lati)/2000000.0)*2*M_PI/360)); // gewichtet
	return round((unsigned long)sqrt((dist_x*dist_x)+(dist_y*dist_y))*0.111);// berechne distanz
};
// get distance between aktueller und ziel punkt

// overloaded function  - see below
unsigned long speedo_gps::calc_dist_supported(simple_coordinate A){
	return calc_dist_supported(gps_goody,A,gps_lati_cos,false);
}

// overloaded function  - see below
unsigned long speedo_gps::calc_dist_supported(simple_coordinate A,bool return_square){
	return calc_dist_supported(gps_goody,A,gps_lati_cos,return_square);
}

// 3000 calc = 397ms  ==> 1 calc ~ 132 us == 2112 Ticks
unsigned long speedo_gps::calc_dist_supported(simple_coordinate A,simple_coordinate B,float gps_lati_cos,bool return_square){

	float dist_y,dist_x; // abstands vars
	// dont use abs() its unsigned
	if( B.latitude > A.latitude){
		dist_y=(float)(B.latitude - A.latitude); // direkt
	} else {
		dist_y=(float)(A.latitude - B.latitude); // direkt
	}
	// dont use abs() its unsigned
	if( A.longitude > B.longitude){
		// hier kommen grad*106 raus
		dist_x=(((float)(A.longitude - B.longitude))*gps_lati_cos)/100; // gewichtet, GPS_lati_cos is *100
	} else {
		dist_x=(((float)(B.longitude - A.longitude))*gps_lati_cos)/100; // gewichtet, GPS_lati_cos is *100
	}

	//	if(return_square){
	//		return ((unsigned long)(((unsigned long)dist_x*(unsigned long)dist_x)+((unsigned long)dist_y*(unsigned long)dist_y)));// berechne distanz ohne *0.111 and without sqrt ... only for comparison
	//	};
	return round((unsigned long)sqrt((dist_x*dist_x)+(dist_y*dist_y))*0.111);// berechne distanz
};

/*******************************************************************
 * kern Funktion des gps,
 * gobale winkel var für den zeiger berechnen und vor allem
 * feststellen ob wir die ziel koodinaten erreicht haben
 * falls ja werden die funktionen für "lad das nächste" angetippt
 *******************************************************************/
void speedo_gps::calc_navi(){
	// differenz der Breitengrade in grad*1.000.000
	entf=calc_dist(navi_ziel_long,navi_ziel_lati);
	if(entf==0) entf++; // if anything is crashed, don't divide by zero!! this will makes it even worse !

	// winkel berechnen, klappt so nur in europa ;)  // long ist nach rechts links,lati oben und unten wir wollen den winkel zwischen dem lati/long also gegen/hypo = sin
	winkel=round(asin(abs(navi_ziel_lati-nmea_to_dec(float(gps_lati[gps_count])))*0.111/entf)/(2*M_PI)*360); // zu grad

	if((nmea_to_dec(float(gps_lati[gps_count]))>navi_ziel_lati) && (nmea_to_dec(float(gps_long[gps_count]))<navi_ziel_long)){ // unter uns und rechts ist das ziel
		winkel+=90;
	} else if((nmea_to_dec(float(gps_lati[gps_count]))>navi_ziel_lati) && (nmea_to_dec(float(gps_long[gps_count]))>navi_ziel_long)){ // unter uns und links ist das ziel
		winkel=270-winkel;
	} else if((nmea_to_dec(float(gps_lati[gps_count]))<navi_ziel_lati) && (nmea_to_dec(float(gps_long[gps_count]))>navi_ziel_long)){ // über uns und links ist das ziel
		winkel+=270;
	} else if((nmea_to_dec(float(gps_lati[gps_count]))<navi_ziel_lati) && (nmea_to_dec(float(gps_long[gps_count]))<navi_ziel_long)){ // über uns und rechts ist das ziel
		winkel=90-winkel;
	};
	winkel=winkel%360; // falls zu gro�? geworden
	//Serial.print("Von meiner Position: "); Serial.print(nmea_to_dec(float(gps_lati[gps_count]))); Serial.print(nmea_to_dec(float(gps_long[gps_count])));
	//Serial.print(" befindet sich das Ziel "); Serial.print(navi_ziel_lati); Serial.print(navi_ziel_long);
	//Serial.print(" in einem 0-Winkel von "); Serial.println(gps_winkel);
	//Soll fahrt Winkel - Fahrt winkel ergibt winkel im vergleich zu gerade aus ...
	winkel-=gps_course[gps_count];
	if(winkel<0){
		winkel+=360;
	};


	// debug
#ifdef NAVI_DEBUG
	pDebug->sprintp(PSTR("Aktuelle lati: "));
	Serial.print(nmea_to_dec(float(gps_lati[gps_count])));
	pDebug->sprintp(PSTR(" Ziel Lati "));
	Serial.println(navi_ziel_lati);
	pDebug->sprintp(PSTR("Aktuelle long: "));
	Serial.print(nmea_to_dec(float(gps_long[gps_count])));
	pDebug->sprintp(PSTR(" Ziel long "));
	Serial.println(navi_ziel_long);
	pDebug->sprintp(PSTR("Entfernung in km: "));
	Serial.println(entf);
#endif
	// debug
	// die gro�?e Frage des Weiterschaltens
	if(entf<15){ // verdammt nah dran, sofort weiterschalten
		inner_circle=false;
		navi_point++;
		generate_new_order();
	}
	else if(entf<30){ // wenn man näher als 30 meter am ziel ist, also quasi dran lang schrammt, vorbereitung treffen
		inner_circle=true;
	}
	else if(entf>60 && inner_circle){ // weiter als 60 meter vom ziel entfernt, aber schon im inneren zirkel gewesen weiterschalten
		inner_circle=false;
		navi_point++;
		generate_new_order();
	};
	// die gro�?e Frage des Weiterschaltens
};

// nmea format (9 47 3208 => 9 788680) umrechnen, eingabe als ul grad+6"nachkommastellen" ohne punkt getrennt
unsigned long speedo_gps::nmea_to_dec(unsigned long nmea){
	return floor(nmea/1000000.0)*1000000+round(mod(nmea,1000000.0)*10/6);
}

// gibt kein mod für ul ? son müll!
unsigned long speedo_gps::mod(unsigned long zahl,unsigned long teiler){
	return (unsigned long)(zahl-(floor(zahl/teiler)*teiler));
};

// gib distanz,richtung,stra�?e zurück
int speedo_gps::get_order(char char_buffer[], int* dist){
	// wenn kein gps signal am start war für mehr als 15 sec
	char_buffer[0]='\0'; // leeren
	if(valid>15){
		return -1;
	};
	int value=0;
	int value2=0;

	sprintf(char_buffer,"! calc failed !"); // das hier ist vorgabe, damit da nicht "no gps" stehen bleibt obwohl wir gps haben und nur die berechnung abgeschmiert ist

	if(entf>=10000){ // mehr als 10 km
		value=int(floor(entf/1000)); // wert als km
		//3+2+1+1+1+10+1+2=21+'\0'=22 -- 25 max
		sprintf(char_buffer,"%3ikm %c            %02i",value,(125+navi_ziel_rl),navi_point%100); // max 999km
	}
	else if(entf>=1000){ // mehr als 1 km
		value=int(floor(entf/1000)); // wert als km
		value2=int(floor((entf%1000)/100)); // wert als km
		sprintf(char_buffer,"%i.%ikm %c            %02i",value,value2,(125+navi_ziel_rl),navi_point%100); // max 9.9km
		value=value*10+value2;
	}
	else {  // weniger als 1000 m
		value=int(floor(entf/10)*10); // auf 10m runterbrechen
		sprintf(char_buffer," %3im %c            %02i",value,(125+navi_ziel_rl),navi_point%100); //max 999m
	};
	for(unsigned int i=0;i<10 && i<strlen(navi_ziel_name); i++){
		char_buffer[i+8]=navi_ziel_name[i];
	};

	*dist=value;
	return 0;
};


void speedo_gps::set_gps_mark(int type){
	note_this_place=type;
}

// die globalen variablen neu befüllen, auf basis des zuvor gesetzten navi_point
void speedo_gps::generate_new_order(){ // eine neue Order auslesen
	// da diese funktion nur aufgerufen wird wenn vorher der navi_pointer geändert wurde speichern wir hier den pointer um das so selten wie nötig zu machen
	byte tempByte = (navi_point & 0xFF);
	eeprom_write_byte((uint8_t *)147,tempByte);

	//////////// DEBUG /////////////////
#ifdef NAVI_DEBUG
	pDebug->sprintlnp(PSTR("Versuche NAVI.SMF zu oeffnen"));
	pConfig->ram_info();
#endif
	//////////// DEBUG /////////////////

	SdFile root;
	SdFile file;
	SdFile subdir;
	root.openRoot(&pSD->volume);

	if(!subdir.open(&root, NAVI_FOLDER, O_READ)) {
		pSD->sd_failed=true;
		pDebug->sprintlnp(PSTR("open subdir /config failed"));
	};
	char navi_filename[13];

	sprintf(navi_filename,"NAVI%i.SMF",active_file%100);

	//////////// DEBUG /////////////////
#ifdef NAVI_DEBUG
	Serial.println(navi_filename);
	pDebug->sprintp(PSTR("Punkt:"));
	Serial.println(navi_point);
#endif
	//////////// DEBUG /////////////////

	if(file.open(&subdir, navi_filename, O_READ)) {
		int16_t n,i;
		uint8_t buf[36];// immer 35 byte lesen, das ist genau eine anweisung (wobei das array wieder ein Feld grö�?er sein muss)
		// die ersten bytes sind sowas wie der titel, die können wir zur navigation nicht nutzen, weglesen
		// suche den ersten zeilen umbruch
		bool found=false;
		bool eof=false;
		int zeile=0;
		i=0;
		unsigned char char_buf[1]={0x00};
		////////// suche den anfang der richtigen zeile
		while(!found && !eof){					// solange suchen bis wir entweder den Datensatz oder das ende haben
			n = file.read(char_buf, 1);			// jeweils nur 1 char lesen
			if(n==1){							// true, if not end of file
				if(char_buf[0]==0x0A){			// find end of line
					if(i<35) buf[i]=0x00;		// if end reach, terminate string
					i=0;						// reset buf write pointer
					zeile++;					// increase number of read lines
					if(zeile==navi_point+2){	// if the NEXT line nr equels nevi_point+1, EDIT +1+1=+2, cause of "skip first line" -> point 0 is found as soon as you find line nr 2!
						found=true;				// we found the right line
					};
				} else {						// its not \n
					buf[i]=char_buf[0];			// so store it in the buffer
					if(i<35) i++;				// and increase the pointer until max
				};
			} else {							// if we were unable to read one further char
				eof=true;						// we have reached the eof before reading the target line
			};
		}
		file.close();							// close it, cause we could call this as loop
		subdir.close();
		root.close();

		//////////// DEBUG /////////////////
#ifdef NAVI_DEBUG
		Serial.print(zeile);
		pDebug->sprintlnp(PSTR(" Datensaetze durchsucht."));
#endif
		//////////// DEBUG /////////////////

		if(found) { 							// is set to true in previous
			navi_ziel_lati=0;
			navi_ziel_long=0;

			// lati/long einlesen
			for(int a=0;a<=8;a++){ // vorwärts
				//sprintf(serialbuffer,"Ich lese ein: %c und mache daraus %i",buf[a],buf[a]-48);
				//Serial.println(serialbuffer);
				navi_ziel_lati=navi_ziel_lati*10+(int(buf[a])-48);
				navi_ziel_long=navi_ziel_long*10+(int(buf[a+10])-48);
			};
			// ziel name
			for(int a=0;a<=9;a++){ // forwards -> 128/6=21  : 2.1km g helmholtzs 11 --> 10 buchstaben
				navi_ziel_name[a]=buf[a+22];
			};
			navi_ziel_name[10]='\0';

			// r oder l oder g
			navi_ziel_rl=int(buf[20])-48; // gradeaus(93+0x20=125),links,rechts: g=125+('0'-48),l=125+('1'-48)

			//////////// DEBUG /////////////////
#ifdef NAVI_DEBUG
			pDebug->sprintp(PSTR("Long: ")); Serial.print(navi_ziel_long); pDebug->sprintp(PSTR(" lati: ")); Serial.print(navi_ziel_lati);
			pDebug->sprintp(PSTR(" name: ")); Serial.print(navi_ziel_name);
			pDebug->sprintp(PSTR(" rlg: ")); Serial.println(navi_ziel_rl);
#endif
			//////////// DEBUG /////////////////
		} else {			// cool file handle

			//////////// DEBUG /////////////////
#ifdef NAVI_DEBUG
			pDebug->sprintlnp(PSTR("soviele punkte gibbet nicht"));
#endif
			//////////// DEBUG /////////////////

			navi_point=zeile-2; // set to max
			if(navi_point<0) navi_point=0; // hmm reason to stop?
			generate_new_order(); // das hier ist das zurücksetzen, wenn man über den letzten Punkt hinweg klickt
		};

	} else { // sd datei nicht gefunden
		sprintf(navi_ziel_name,"SD failed!");

		//////////// DEBUG /////////////////
#ifdef SD_DEBUG
		pDebug->sprintlnp(PSTR("Konnte Navigations Daten nicht laden"));
#endif
		//////////// DEBUG /////////////////
	};
};

/****************************************************************
 * Wird in der main loop aufgerufen,
 * quasi als "zeig mir alle werte die ich so kenne" - ding
 ***************************************************************/
void speedo_gps::loop(){
	for(int i=0;i<8;i++){ // ob das so schlau ist, 3 mal get_info aufzurufen ?!
		if(pSpeedo->disp_zeile_bak[i]!=get_info(i)){ // nur aktualisiern wenn sich was ändert
			char buffer[10];
			switch(i){
			case 0: sprintf(buffer,"%06lu",get_info(i)); break;
			case 1: sprintf(buffer,"%06lu",get_info(i)); break;
			case 2: sprintf(buffer,"%09lu{",get_info(i)); break;
			case 3: sprintf(buffer,"%09lu{",get_info(i)); break;
			case 4: sprintf(buffer,"%05lu dm",get_info(i)); break;
			case 5: sprintf(buffer,"%03i km/h",int(get_info(i))); break;
			case 6: sprintf(buffer,"#%i | %i",int(get_info(i)),int(get_info(8))); break;
			case 7: sprintf(buffer,"%i",gps_write_status); break; // fix
			};
			pOLED->string(pSpeedo->default_font,buffer,10,i,0,DISP_BRIGHTNESS,0);
			pSpeedo->disp_zeile_bak[i]=int(get_info(i));
		}
	};
};


/************************************************
 * Das speichern wird zukünftig die Config klasse übernehmen
 * wir triggern da das write und das wird uns hier aufrufen
 * um die infos zu bekommen
 ****************************************************/
int speedo_gps::get_logged_points(char* buffer,int a,int* nbytes){
	gps_write_status=9;
	if(a<=gps_count){
		if(gps_time[a]>240000000L) gps_time[a]=000000;
		if(gps_date[a]>311299) gps_date[a]=311299;
		if(gps_lati[a]>180000000) gps_lati[a]=0;	// NMEA Format!
		if(gps_long[a]>180000000) gps_long[a]=0;	// NMEA Format!
		if(gps_speed_arr[a]>300) gps_speed_arr[a]=300;
		if(gps_course[a]>3600) gps_course[a]=0;
		if(gps_alt[a]>50000 || gps_alt[a]<50000) gps_alt[a]=50000;
		if(gps_sats[a]>20) gps_sats[a]=20;
		if(gps_fix[a]>1) gps_fix[a]=2;
		if(gps_special[a]>9) gps_special[a]=9;

		if(use_compressed_log_format){
			/* compressed gps format contains just:
			 * gps_time: 23:59:59.900 => 235.959.900 => 4 Byte [1..4]
			 * gps_lati: 009456123 => 4 Byte [5..8]
			 * gps_long: 052144879 => 4 Byte [9..12]
			 * speed: 0..255 + [13,14]
			 * gps_special => 2 Byte <-- gps special is high nibble ob byte 13
			 * 4+4+4+2=14 + 1 (Spacer) = 15 Byte
			 */

			buffer[0]='*';
			buffer[1]=(gps_time[a]&0xff000000)>>24;
			buffer[2]=(gps_time[a]&0x00ff0000)>>16;
			buffer[3]=(gps_time[a]&0x0000ff00)>>8;
			buffer[4]=(gps_time[a]&0x000000ff)>>0;
			buffer[5]=(gps_lati[a]&0xff000000)>>24;
			buffer[6]=(gps_lati[a]&0x00ff0000)>>16;
			buffer[7]=(gps_lati[a]&0x0000ff00)>>8;
			buffer[8]=(gps_lati[a]&0x000000ff)>>0;
			buffer[9]=(gps_long[a]&0xff000000)>>24;
			buffer[10]=(gps_long[a]&0x00ff0000)>>16;
			buffer[11]=(gps_long[a]&0x0000ff00)>>8;
			buffer[12]=(gps_long[a]&0x000000ff)>>0;
			buffer[13]=(gps_speed_arr[a]&0x0f00)>>8 | (gps_special[a]&0x0f)<<4;
			buffer[14]=(gps_speed_arr[a]&0x00ff)>>0;
			*nbytes=15;
		} else {
			/* std gps format contains:
			 * gps_time: 9 digits, 19:23:45.451 => 192345451
			 * gps_date: 6 digits, 25.7.2013 => 250713
			 * gps_lati: 9 digits, 52.14,2356° => 052142356
			 * gps_long: 9 digits, 9.11,457 => 00911457
			 * gps_speed_arr: 3 digits, 278
			 * gps_course: 5 digits, deci deg "172.3"
			 * gps_alt: 5 digits, decimeter
			 * gps_sats: 2 digits, number of
			 * gps_fix: 1 digit, sec
			 * gps_special: 1 digit, marker 0..9
			 * 9+1+6+1+9+1+9+1+3+1+5+1+5+1+2+1+1+1+1+\n = 62
			 */
			sprintf(buffer,"%09lu,%06lu,%09lu,%09lu,%03i,%05u,%05lu,%02i,%i,%i\n",
					gps_time[a],gps_date[a],gps_lati[a],gps_long[a],gps_speed_arr[a],gps_course[a],gps_alt[a],gps_sats[a],gps_fix[a],gps_special[a]);
			*nbytes=62;
		}

		written_gps_points++;
		return 0;
	} else {
		return -1;
	};
	return -1;
};


void speedo_gps::SendByte(unsigned char data){
	while((UCSR1A & (1<< UDRE1)) == 0) {};
	UDR1=data;
};

/*! \brief Sends a string.
 *
 *  Loops thru a string and send each byte with uart_SendByte.
 *  If TX buffer is full it will hang until space.
 *
 *  \param Str  String to be sent.
 */


void speedo_gps::SendString(const char *Str){//2376 ->  2530
	while(pgm_read_byte(Str) != 0x00){
		//Serial.print(pgm_read_byte(Str));
		SendByte(pgm_read_byte(Str++));
	}

}

bool speedo_gps::get_drive_status(){
	if(motion_start<0){
		return false;
	} else {
		int sec_in_motion=(millis()/1000)-motion_start;
		if(sec_in_motion>5){
			return true;
		}
	}
	return false;
};

int speedo_gps::calc_gps_goodies(){
	if(get_info(9)>5){ return -1; }; // if there is no GPS than calculation is non sense
	gps_goody.latitude=pSensors->m_gps->nmea_to_dec(pSensors->m_gps->get_info(3));
	gps_goody.longitude=pSensors->m_gps->nmea_to_dec(pSensors->m_gps->get_info(2));
	gps_lati_cos=cos(floor(gps_goody.latitude/1000000.0)*2*M_PI/360)*100;
	return 0;
}


void speedo_gps::set_drive_status(int speed, int ss, int sat, char status){
	if(status=='A' && sat>5){ //measurement valid
		if(speed>=15){ // you are driving faster than 15 kmh
			if(motion_start==-1){
				motion_start=(millis()/1000)%32000;
			};
		} else {
			motion_start=-1;
		}
	} else {
		motion_start=-1;
	}
};

unsigned long speedo_gps::GpsTimeToTimeStamp(unsigned long input){
	// input is something like 151932100 at 15:19:32.100
	// output should be 15*3600000+19*60000+32100=55172100
	unsigned int min=(int)floor(input/100000)%100;
	unsigned int hour=floor(input/10000000);
	unsigned int sec_with_frac=input-(unsigned long)((hour*100+min)*100000);

	unsigned long return_value=((unsigned long)(hour*60+min))*60000+sec_with_frac;

	return return_value;
}
