PhilippSchmaelzle/speedoino/ATm2560_Firmware/temperature.cpp

/* Speedoino - This file is part of the firmware.
 * Copyright (C) 2011 Kolja Windeler
 *
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
 * You should have received a copy of the GNU General Public License
 * along with this program.  If not, see <http://www.gnu.org/licenses/>.
 */

#include "global.h"

speedo_temperature::speedo_temperature(){
	oil_temp_value_counter=0;
	oil_temp_value=0;
	oil_temp_fail_status=0; // 0 = no failed read, 1-5 = Number of shorts read, 6-9 = Number of open read

	water_temp_value_counter=0;
	water_temp_value=0;
	water_temp_fail_status=0; // 0 = no failed read, 1-5 = Number of shorts read, 6-9 = Number of open read

	air_temp_value=0;

	water_warning_temp=0; // 95 C
	oil_warning_temp=0; // 120 C
	// values for
	for(unsigned int j=0; j<sizeof(oil_r_werte)/sizeof(oil_r_werte[0]); j++){
		oil_r_werte[j]=0;
		oil_t_werte[j]=0;

		water_r_werte[j]=0;
		water_t_werte[0]=0;
	};
};

speedo_temperature::~speedo_temperature(){
};

int speedo_temperature::check_vars(){
	if(water_r_werte[0]==0 || water_t_werte[0]==0 || oil_t_werte[0]==0 || oil_r_werte[0]==0){
		// Temperatur und Widerstands LookUp
		// OIL
		int r_werte[19]={1000,700,550,400,330,250,230,210,195,150,140,135,110,100, 90, 80, 20, 15, 10}; // widerstandswerte
		int t_werte[19]={  27, 35, 45, 50, 55, 60, 65, 70, 75, 80, 85, 90, 95,100,105,110,115,120,125}; // passender Temperaturwert

		for(unsigned int j=0; j<sizeof(oil_r_werte)/sizeof(oil_r_werte[0]); j++){
			oil_r_werte[j]=r_werte[j];
			oil_t_werte[j]=t_werte[j];
		};

		// Water
		//TODO
		int r_werte2[19]={354,323,241,198,157,135,111,93,80,64,52,43,37,30, 23, 18, 15, 10,  9}; // widerstandswerte
		int t_werte2[19]={ 30, 35, 40, 45, 50, 55, 60,65,70,75,80,85,90,95,100,105,110,115,116}; // passender Temperaturwert
		for(unsigned int j=0; j<sizeof(water_r_werte)/sizeof(water_r_werte[0]); j++){
			water_r_werte[j]=r_werte2[j];
			water_t_werte[j]=t_werte2[j];
		};

		water_warning_temp=950; // 95 C
		oil_warning_temp=1200; // 120 C
		pDebug->sprintp(PSTR("temp failed"));
		return 1;
	};

	return 0;
}

void speedo_temperature::init(){
	I2c.begin();
	I2c.setSpeed(0); /// fast
	I2c.timeOut(100); // 100 ms to get Temperature
	pDebug->sprintlnp(PSTR("Temp init done."));
}

void speedo_temperature::read_oil_temp() {
	// werte in array speichern in °C*10 für Nachkommastelle
#ifdef TEMP_DEBUG
	Serial.println("\n\rTemp: Beginne Öl zu lesen");
#endif

	//// Widerstandsberechnung ////
	/*	Spannungsabgriff zwischen 2 Widerständen, R1 ggn 5V da drunter in Reihe "R".
	 *  R=U/I, U=R*I, I=U/R
	 *  Spannung über dem zu messenden Widerstand:  Uabgriff = R*I
	 *  I=5V/(R+R1)
	 *  Uabgriff = 5V*analogValue/1024 = R*5V/(R+R1)
	 *  5*analogValue/1024*R + 5*analogValue/1024*R1 = R*5
	 *  5*analogValue/1024*R1 = R*(5-5*analogValue/1024)
	 *  R= (5*analogValue/1024*R1)/(5-5*analogValue/1024) ; "5" Kürzen
	 *  R= (analogValue/1024*R1)/(1-1*analogValue/1024) ; "1024" nach unten
	 *  R= (analogValue*R1)/(1024-analogValue) ; "1024" nach unten
	 *   Widerstandsberechnung *////

	// werte auslesen
	unsigned int oil_value=analogRead(OIL_TEMP_PIN);
	int temp=(1024-oil_value)/10; // max 102
	if(temp>0 && temp<102){
		int r_temp=round((oil_value*22)/temp); // 22*1024 < 32000
		//Serial.print("Oel Wert eingelesen: "); Serial.print(oil_value); Serial.print(" zwischenschritt "); Serial.println(r_temp);
		// LUT  wert ist z.B. 94°C somit 102 ohm => dann wird hier in der for schleife bei i=13 ausgelößt, also guck ich mir den her + den davor an
		for(int i=0;i<19;i++){ // 0 .. 18 müssen durchsucht werden das sind die LUT positionen
			if(r_temp>=oil_r_werte[i]){ // den einen richtigen raussuchen
				int j=i-1;  if(j<0) j=0; // j=12
				int offset=r_temp-oil_r_werte[i]; // wieviel höher ist mein messwert als den, den ich nicht wollte => 102R-100R => 2R
				int differ_r=oil_r_werte[j]-oil_r_werte[i]; // wie weit sind die realen widerstands werte auseinander 10R
				int differ_t=oil_t_werte[i]-oil_t_werte[j]; // wie weit sind die realen temp werte auseinander 5°C
				int aktueller_wert=round(10*(oil_t_werte[i]-offset*differ_t/differ_r));
				oil_temp_value=pSensors->flatIt(aktueller_wert,&oil_temp_value_counter,20,oil_temp_value);

#ifdef TEMP_DEBUG
				Serial.print("Oel Wert eingelesen: ");
				Serial.print(oil_value);
				Serial.print(" und interpretiert ");
				Serial.print(aktueller_wert);
				Serial.print(" und geplaettet: ");
				Serial.println(int(round(oil_temp_value)));
#endif
				oil_temp_fail_status=0;
				break; // break the for loop
			};
		};
	} else if(temp==0) { // kein Sensor  0=(1024-x)/10		x>=1015
#ifdef TEMP_DEBUG
		Serial.print("@");
		Serial.print(millis());
		Serial.print(": oil Wert -> OPEN");
		Serial.print(" | Oil fail status:");
		Serial.println((int)oil_temp_fail_status);
#endif

		if(oil_temp_fail_status<6){
			oil_temp_fail_status=6;
		} else if(oil_temp_fail_status<9){
			oil_temp_fail_status++;
		}
	} else { // Kurzschluss nach masse: 102=(1024-x)/10  	x<=4
		if(oil_temp_fail_status<5){ // nach sechs maligem fehler => ausgabe!
			oil_temp_fail_status++;
		};

#ifdef TEMP_DEBUG
		Serial.print("@");
		Serial.print(millis());
		Serial.print(": oil Wert -> Short to GND");
		Serial.print(" | Oil fail status:");
		Serial.println((int)oil_temp_fail_status);
#endif
	}
};

void speedo_temperature::read_water_temp() {
	// werte in array speichern in °C*10 für Nachkommastelle
#ifdef TEMP_DEBUG
	Serial.println("\n\rTemp: Beginne Water zu lesen");
#endif

	// werte auslesen
	unsigned int water_value=analogRead(WATER_TEMP_PIN);
	/* kann bis zu 225.060 werden bei 40°C etwa 470 ohm: 470+220=690 Ohm, U/R=I => 5/690=0,007246377A, R*I=U, 1,594202899V, Wert=326
	 * wenn temp < 102 sein soll, dann ergibt 1020 schon ein error, bei 102=(1024-X)/10 => x <= 4
	 * Da haben wir also 4*5V/1024 über dem PT100 und den Rest über 390Ohm
	 * 0,01953125 V über dem PT100 und 4,98046875V über 390Ohm, -> PT100: 1,529411765 Ohm
	 */
	int temp=(1024-water_value)/10; // max 102
	if(temp>0 && temp<102){
		int r_temp=round((int)((unsigned long)(water_value*39)/temp)); // 39*1024 > 32000
		//Serial.print("Oel Wert eingelesen: "); Serial.print(oil_value); Serial.print(" zwischenschritt "); Serial.println(r_temp);
		// LUT  wert ist z.B. 94°C somit 102 ohm => dann wird hier in der for schleife bei i=13 ausgelößt, also guck ich mir den her + den davor an
		// wenn unser ermittelter R KLEINER ist als der kleinste R, dann haben wir da mehr grad als maximum und brauchen nicht interpolieren
		if(r_temp<water_r_werte[18]){
			water_temp_value=pSensors->flatIt(10*water_t_werte[18],&water_temp_value_counter,60,water_temp_value);
		} else {
			for(int i=0;i<19;i++){ // 0 .. 18 müssen durchsucht werden das sind die LUT positionen
				if(r_temp>=water_r_werte[i]){ // den einen richtigen raussuchen
					int j=i-1;  if(j<0) j=0; // j=12
					int offset=r_temp-water_r_werte[i]; // wieviel höher ist mein messwert als den, den ich nicht wollte => 102R-100R => 2R
					int differ_r=water_r_werte[j]-water_r_werte[i]; // wie weit sind die realen widerstands werte auseinander 10R
					int differ_t=water_t_werte[i]-water_t_werte[j]; // wie weit sind die realen temp werte auseinander 5°C
					int aktueller_wert=round(10*(water_t_werte[i]-offset*differ_t/differ_r));
					water_temp_value=pSensors->flatIt(aktueller_wert,&water_temp_value_counter,60,water_temp_value);

#ifdef TEMP_DEBUG
					Serial.print("Water Wert eingelesen: ");
					Serial.print(water_value);
					Serial.print(" und interpretiert als R ");
					Serial.print(r_temp);
					Serial.print(" und geplaettet: ");
					Serial.println(int(round(water_temp_value)));
#endif
					water_temp_fail_status=0;
					break; // break the for loop
				};
			};
		};
	} else if(temp==0) { // kein Sensor  0=(1024-x)/10		x>=1015
		if(water_temp_fail_status<6){
			water_temp_fail_status=6;
		} else if(water_temp_fail_status<9){
			water_temp_fail_status++;
		}
	} else { // Kurzschluss nach masse: 102=(1024-x)/10  	x<=4
		if(water_temp_fail_status<5){ // nach sechs maligem fehler => ausgabe!
			water_temp_fail_status++;
		};

#ifdef TEMP_DEBUG
		Serial.print("Water Wert Kurzschluss ggn Masse");
#endif
	}
};

void speedo_temperature::read_air_temp() {
	// get i2c tmp102 //
#ifdef TEMP_DEBUG
	Serial.println("beginne air read");
#endif
	int sensorAddress = 0b01001000;  // From datasheet sensor address is 0x91 shift the address 1 bit right
	byte msb;
	byte lsb;
	I2c.read(sensorAddress,0x00,2);
#ifdef TEMP_DEBUG
	Serial.println("request abgeschickt");
#endif

	if (I2c.available() >= 2){  // if two bytes were received
#ifdef TEMP_DEBUG
		Serial.println("2 Byte im Puffer");
#endif
		msb = I2c.receive();  // receive high byte (full degrees)
		lsb = I2c.receive();  // receive low byte (fraction degrees)
		air_temp_value = ((msb) << 3);  // MSB
		air_temp_value|= (lsb >> 5);    // LSB
		air_temp_value = round(air_temp_value*1.25); // round and save
#ifdef TEMP_DEBUG
		Serial.print("Air value "); Serial.println(air_temp_value);
#endif
	} else {
		air_temp_value = 999;
#ifdef TEMP_DEBUG
		Serial.println("ALARM keine Antwort vom I2C sensor!!");
#endif
	};
};


int speedo_temperature::get_air_temp(){
	if(air_temp_value>999) // notfall
		return 0;
	else
		return air_temp_value;
}

int speedo_temperature::get_oil_temp(){
	if(pSpeedo->trip_dist[2]==0 && get_air_temp()!=999 && oil_temp_value!=8888 && oil_temp_value!=9999) // wir sind heute noch exakt gar nicht gefahren
		return get_air_temp()-1;
	else
		return int(round(oil_temp_value));
}

int speedo_temperature::get_water_temp(){
	if(pSpeedo->trip_dist[2]==0  && get_air_temp()!=999 && water_temp_value!=8888 && water_temp_value!=9999) // wir sind heute noch exakt gar nicht gefahren
		return get_air_temp()-1;
	else
		return int(round(water_temp_value));
}
