PhilippSchmaelzle/speedoino/ATm2560_Firmware/display.cpp

/* Speedoino - This file is part of the firmware.
 * Copyright (C) 2011 Kolja Windeler
 *
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
 * You should have received a copy of the GNU General Public License
 * along with this program.  If not, see <http://www.gnu.org/licenses/>.
 */

#include "global.h"
#include <ssd0323.h>

speedo_disp::speedo_disp(void){
	phase=0;
	ref=0;
}

speedo_disp::~speedo_disp(){
};


void speedo_disp::draw_gps(unsigned char x,unsigned char y, unsigned char sats){
	send_command(0x15);
	send_command(x);
	send_command(x+3);
	send_command(0x75);
	send_command(y);
	send_command(y+7);
	char xy[2][4];
	xy[0][0]=0x00;
	xy[1][0]=0x00;
	xy[0][1]=0x00;
	xy[1][1]=0x00;
	xy[0][2]=0x00;
	xy[1][2]=0x00;
	xy[0][3]=0x00;
	xy[1][3]=0x00;

	// 4 symbols:
	// 0 GPS => cross
	// 3 GPS => empty (indicating minimal signal)
	// 4 GPS => single bow (indicating poor signal)
	// 5-X GPS => dual bow (indicating strong signal)

	if(sats==0){
		xy[0][0]=0x0F;		//	 X X
		xy[1][0]=0x0F;		//	  X
		//xy[0][1]=0x00;	//	 X X
		xy[1][1]=0xF0;		//
		xy[0][2]=0x0F;		//
		xy[1][2]=0x0F;		//
		//xy[0][3]=0x00;	//
		//xy[1][3]=0x00;	//
	} else if(sats==4){
		//xy[0][0]=0x00;	//
		//xy[1][0]=0x00;	//
		//xy[0][1]=0x00;	//	X
		//xy[1][1]=0x00;	//	 X
		xy[0][2]=0xF0;		//
		//xy[1][2]=0x00;	//
		xy[0][3]=0x0F;		//
		//xy[1][3]=0x00;	//
	} else if(sats>4){
		xy[0][0]=0xFF;		//	XX
		//xy[1][0]=0x00;	//	  X
		//xy[0][1]=0x00;	//	X  X
		xy[1][1]=0xF0;		//	 X X
		xy[0][2]=0xF0;		//
		xy[1][2]=0x0F;		//
		xy[0][3]=0x0F;		//
		xy[1][3]=0x0F;		//
	};


	send_char(0x00);  send_char(0x00);  send_char(xy[0][0]);  send_char(xy[1][0]);	//
	send_char(0x00);  send_char(0x00);  send_char(xy[0][1]);  send_char(xy[1][1]);	//
	send_char(0x0F);  send_char(0x00);  send_char(xy[0][2]);  send_char(xy[1][2]);	// x
	send_char(0xF0);  send_char(0xF0);  send_char(xy[0][3]);  send_char(xy[1][3]);	//x x
	send_char(0xF0);  send_char(0x0F);  send_char(0x00);  	  send_char(0x00);		//x  x
	send_char(0xF0);  send_char(0x00);  send_char(0xF0);	  send_char(0x00);		//x   x
	send_char(0x0F);  send_char(0x00);  send_char(0x0F);	  send_char(0x00);		// x   x
	send_char(0x00);  send_char(0xFF);  send_char(0xF0);	  send_char(0x00);		//  xxx
};

void speedo_disp::draw_oil(unsigned char x,unsigned char y){
	send_command(0x15);
	send_command(x);
	send_command(x+9);
	send_command(0x75);
	send_command(y);
	send_command(y+7);
	send_char(0xFF); send_char(0xF0); send_char(0x0F); send_char(0xFF); send_char(0x00); send_char(0x00); send_char(0x00); send_char(0x00); send_char(0x00); send_char(0x00);
	send_char(0xF0); send_char(0x0F); send_char(0x00); send_char(0xF0); send_char(0x00); send_char(0x00); send_char(0x0F); send_char(0xFF); send_char(0xF0); send_char(0x00);
	send_char(0xF0); send_char(0x0F); send_char(0xFF); send_char(0xFF); send_char(0xFF); send_char(0x0F); send_char(0xF0); send_char(0xF0); send_char(0x00); send_char(0x00);
	send_char(0x0F); send_char(0x0F); send_char(0x00); send_char(0x00); send_char(0x00); send_char(0xF0); send_char(0x0F); send_char(0x00); send_char(0xF0); send_char(0x00);
	send_char(0x00); send_char(0xFF); send_char(0x00); send_char(0x00); send_char(0x00); send_char(0x00); send_char(0xF0); send_char(0x0F); send_char(0xFF); send_char(0x00);
	send_char(0x00); send_char(0x0F); send_char(0x00); send_char(0x00); send_char(0x00); send_char(0x0F); send_char(0x00); send_char(0xFF); send_char(0x70); send_char(0xF0);
	send_char(0x00); send_char(0x00); send_char(0xFF); send_char(0xFF); send_char(0xFF); send_char(0xF0); send_char(0x00); send_char(0xFF); send_char(0x77); send_char(0xF0);
	send_char(0x00); send_char(0x00); send_char(0x00); send_char(0x00); send_char(0x00); send_char(0x00); send_char(0x00); send_char(0x0F); send_char(0xFF); send_char(0x00);
};

void speedo_disp::draw_water(unsigned char x,unsigned char y){
	send_command(0x15);
	send_command(x);
	send_command(x+9);
	send_command(0x75);
	send_command(y);
	send_command(y+7);
	send_char(0x00);  send_char(0x77);  send_char(0x00);  send_char(0xFF);  send_char(0xFF);  send_char(0xFF);  send_char(0xF0);  send_char(0x00);  send_char(0x00);  send_char(0x00);
	send_char(0x00);  send_char(0x77);  send_char(0x00);  send_char(0x00);  send_char(0x0F);  send_char(0x00);  send_char(0x00);  send_char(0x00);  send_char(0x00);  send_char(0x00);
	send_char(0x00);  send_char(0x77);  send_char(0xF0);  send_char(0x0F);  send_char(0xFF);  send_char(0xFF);  send_char(0x00);  send_char(0x00);  send_char(0x00);  send_char(0x00);
	send_char(0x00);  send_char(0x77);  send_char(0xFF);  send_char(0xFF);  send_char(0xFF);  send_char(0xFF);  send_char(0xFF);  send_char(0xFF);  send_char(0x00);  send_char(0x00);
	send_char(0x00);  send_char(0x77);  send_char(0xFF);  send_char(0xFF);  send_char(0xFF);  send_char(0xFF);  send_char(0xFF);  send_char(0xFF);  send_char(0xF0);  send_char(0x00);
	send_char(0x00);  send_char(0x77);  send_char(0xF0);  send_char(0x0F);  send_char(0xFF);  send_char(0xFF);  send_char(0x00);  send_char(0x0F);  send_char(0xF0);  send_char(0x00);
	send_char(0x00);  send_char(0x77);  send_char(0x00);  send_char(0x00);  send_char(0x00);  send_char(0x00);  send_char(0x00);  send_char(0x0F);  send_char(0xF0);  send_char(0x00);
	send_char(0x00);  send_char(0x77);  send_char(0x00);  send_char(0x00);  send_char(0x00);  send_char(0x00);  send_char(0x00);  send_char(0x00);  send_char(0x00);  send_char(0x00);
};

void speedo_disp::draw_air(unsigned char x,unsigned char y){
	send_command(0x15);
	send_command(x);
	send_command(x+2);
	send_command(0x75);
	send_command(y);
	send_command(y+7);
	send_char(0x00);  send_char(0xF0);  send_char(0x00);
	send_char(0x00);  send_char(0xFF);  send_char(0xF0);
	send_char(0x00);  send_char(0xF0);  send_char(0x00);
	send_char(0x00);  send_char(0xFF);  send_char(0xF0);
	send_char(0x00);  send_char(0xF0);  send_char(0x00);
	send_char(0x0F);  send_char(0xFF);  send_char(0x00);
	send_char(0xFF);  send_char(0xFF);  send_char(0xF0);
	send_char(0x0F);  send_char(0xFF);  send_char(0x00);
};

void speedo_disp::draw_fuel(unsigned char x,unsigned char y){
	send_command(0x15);
	send_command(x);
	send_command(x+3);
	send_command(0x75);
	send_command(y);
	send_command(y+6);
	send_char(0x0F);  send_char(0xFF);  send_char(0xF0);  send_char(0x0F);
	send_char(0x0F);  send_char(0x00);  send_char(0xF0);  send_char(0xF0);
	send_char(0x0F);  send_char(0x00);  send_char(0xF0);  send_char(0xF0);
	send_char(0x0F);  send_char(0xFF);  send_char(0xF0);  send_char(0xF0);
	send_char(0x0F);  send_char(0xFF);  send_char(0xFF);  send_char(0x00);
	send_char(0x0F);  send_char(0xFF);  send_char(0xF0);  send_char(0x00);
	send_char(0xFF);  send_char(0xFF);  send_char(0xFF);  send_char(0x00);
};

void speedo_disp::draw_clock(unsigned char x,unsigned char y){
	send_command(0x15);
	send_command(x);
	send_command(x+3);
	send_command(0x75);
	send_command(y);
	send_command(y+7);
	send_char(0x00);  send_char(0xFF);  send_char(0xF0);  send_char(0x00);
	send_char(0x0F);  send_char(0x0F);  send_char(0x0F);  send_char(0x00);
	send_char(0xF0);  send_char(0x0F);  send_char(0x00);  send_char(0xF0);
	send_char(0xF0);  send_char(0x0F);  send_char(0xF0);  send_char(0xF0);
	send_char(0xF0);  send_char(0x00);  send_char(0x00);  send_char(0xF0);
	send_char(0x0F);  send_char(0x00);  send_char(0x0F);  send_char(0x00);
	send_char(0x00);  send_char(0xFF);  send_char(0xF0);  send_char(0x00);
};

void speedo_disp::draw_blitzer(unsigned char x,unsigned char y){
	send_command(0x15);
	send_command(x);
	send_command(x+4);
	send_command(0x75);
	send_command(y);
	send_command(y+14);
	send_char(0xFF); send_char(0xFF); send_char(0xFF); send_char(0xFF); send_char(0xF0);
	send_char(0xFF); send_char(0xF0); send_char(0x00); send_char(0xFF); send_char(0xF0);
	send_char(0xFF); send_char(0x00); send_char(0x00); send_char(0x0F); send_char(0xF0);
	send_char(0xFF); send_char(0x00); send_char(0x00); send_char(0x0F); send_char(0xF0);
	send_char(0xFF); send_char(0x00); send_char(0x00); send_char(0x0F); send_char(0xF0);
	send_char(0xFF); send_char(0xF0); send_char(0x00); send_char(0xFF); send_char(0xF0);
	send_char(0xFF); send_char(0xFF); send_char(0xFF); send_char(0xFF); send_char(0xF0);
	send_char(0x00); send_char(0x00); send_char(0xF0); send_char(0x00); send_char(0x00);
	send_char(0x00); send_char(0x00); send_char(0xF0); send_char(0x00); send_char(0x00);
	send_char(0x00); send_char(0x00); send_char(0xF0); send_char(0x00); send_char(0x00);
	send_char(0x00); send_char(0x00); send_char(0xF0); send_char(0x00); send_char(0x00);
	send_char(0x00); send_char(0x00); send_char(0xF0); send_char(0x00); send_char(0x00);
	send_char(0x00); send_char(0x00); send_char(0xF0); send_char(0x00); send_char(0x00);
	send_char(0x00); send_char(0x00); send_char(0xF0); send_char(0x00); send_char(0x00);
}

void speedo_disp::draw_arrow(int arrow, int spalte, int zeile){
	pOLED->string(pSpeedo->default_font,"   ",spalte,zeile,0,0,0); // 3x3 Buchstaben, 6x8
	pOLED->string(pSpeedo->default_font,"   ",spalte,zeile+1,0,0,0); // 18x24
	pOLED->string(pSpeedo->default_font,"   ",spalte,zeile+2,0,0,0);
	if((pSensors->get_speed(false)>=3) && (arrow>-1)){ // nur den Winkel "goto" einzeichnen wenn die Geschwindigkeit >=3 kmh ist
		// TODO: hier einen schickeren Winkel zeichnen...
		// ein Strich im winkel pSensors->m_gps->winkel mit der länge l nach oben und unten
		int m_x=(spalte+1)*6+3,m_y=(zeile+1)*8+4,l=8; // m_x=spalte*8+2, m_y=zeile*8+4 // spalte=1, zeile=2
		int sp_x=round(m_x+sin(arrow*2*M_PI/360)*l);
		int sp_y=round(m_y-cos(arrow*2*M_PI/360)*l);
		int end_x=round(m_x-sin(arrow*2*M_PI/360)*l);
		int end_y=round(m_y+cos(arrow*2*M_PI/360)*l);
		pOLED->line(sp_x,sp_y,end_x,end_y,10); // neuen Winkel malen

		// spitze "einfärben" Spitze: round(m_x+sin(pSensors->m_gps->winkel)*l),round(m_y-cos(pSensors->m_gps->winkel)*l)
		int pf_length=8;
		int temp_winkel=(arrow+30)%360;
		end_x=round(sp_x-sin(temp_winkel*2*M_PI/360)*pf_length);
		end_y=round(sp_y+cos(temp_winkel*2*M_PI/360)*pf_length);
		pOLED->line(sp_x,sp_y,end_x,end_y,15); // neuen Winkel malen

		temp_winkel=(arrow+330)%360; // was das gleiche ist wie -30° und check obs unter null ist
		end_x=round(sp_x-sin(temp_winkel*2*M_PI/360)*pf_length);
		end_y=round(sp_y+cos(temp_winkel*2*M_PI/360)*pf_length);
		pOLED->line(sp_x,sp_y,end_x,end_y,15); // neuen Winkel malen

		//l++;
		//pOLED->set2pixels(round(m_x+sin(pSensors->m_gps->winkel*2*M_PI/360)*l),round(m_y-cos(pSensors->m_gps->winkel*2*M_PI/360)*l),15,15);
		//pOLED->set2pixels(round(m_x+sin(pSensors->m_gps->winkel*2*M_PI/360)*l),round(m_y-cos(pSensors->m_gps->winkel*2*M_PI/360)*l+1),15,15);
	};
	// schreibe winkel
}

// grafix has to be stored at /gfx/
int speedo_disp::sd2ssd(char filename[10],int frame){
	send_command(0x15);
	send_command(0x00);
	send_command(0x7F);
	send_command(0x75);
	send_command(0x00);
	send_command(0x3F);

	SdFile root;
	SdFile file;
	SdFile subdir;
	root.openRoot(&pSD->volume);

	if(!subdir.open(&root, "gfx", O_READ))    {  return 1; };
	if(!file.open(&subdir, filename, O_READ)) {  return 2; };
	unsigned long frame_seeker=(unsigned long)frame*64*64;
	if(!file.seekSet(frame_seeker))			  {  return 3; }; // ein bild ist 64*64 Byte groß, da wir 64 lines zu je 64*2*4 Bit Breite haben

	uint8_t buf[65];
	//int n;
	//while ((n = file.read(buf, sizeof(byte)*64)) > 0) {
	for (int zeile=0;	(file.read(buf, sizeof(byte)*64)>0)	&& zeile<64;	zeile++ ) {
		for(int j=0;j<64;j++){
			send_char(buf[j]);
		};
	};
	file.close();
	subdir.close();
	root.close();
	return 0;
};

void speedo_disp::string_P_centered(const char* text, uint8_t line){
	string_P_centered(text,line,false);
}

void speedo_disp::string_P_centered(const char* text, uint8_t line, bool inverted){
	if(strlen_P(text)>20){
		return;
	};

	uint16_t front_color=0x0f;
	uint16_t back_color=0x00;
	uint16_t start_pos=0;
	uint16_t length_of_char=22;

	if(inverted){
		front_color=0x00;
		back_color=0x0f;
		if(strlen_P(text)<=17){ // 6*2pixel == 2 chars. 21 Chars - 2*2 = 17chars max
			length_of_char=17;
			start_pos=2;
			pOLED->highlight_bar(0,line*8,128,8);
		} else {
			pOLED->filled_rect(0,line*8,128,8,0x0f);
		}
	}
	char text_char[length_of_char]; // full display width +1
	strcpy_P(text_char,text);
	pMenu->center_me(text_char,length_of_char); // full display width
	pOLED->string(pSpeedo->default_font,text_char,start_pos,line,back_color,front_color,0);
}

// aufruf parameter:
void speedo_disp::show_storry(const char* storry,const char* title){
	show_storry(storry,title,0x00);
}

void speedo_disp::show_storry(const char* storry,const char* title, uint8_t type){
	char storry_char[strlen_P(storry)+1];
	char title_char[strlen_P(title)+1];

	strcpy_P(storry_char,storry);
	strcpy_P(title_char,title);

	show_storry(storry_char,strlen_P(storry),title_char,strlen_P(title),type);
}

void speedo_disp::show_storry(char storry[],unsigned int storry_length,char title[],unsigned int title_length){
	show_storry(storry,storry_length,title, title_length, 0x00);
}
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
