PhilippSchmaelzle/speedoino/(notices)

Notices in the files:
ATm2560_Firmware/file_manager_v2.cpp:
This program is free software: you can redistribute it and/or modify
it under the terms of the GNU General Public License as published by
the Free Software Foundation, either version 3 of the License, or
(at your option) any later version.
SmartSpeedo_avr/inc/pins_arduino.c:
Public License along with this library; if not, write to the
Free Software Foundation, Inc., 59 Temple Place, Suite 330,
Boston, MA 02111-1307 USA
parts and their libraries:
STM32F407Vx_LQFP100: Copyright 2012 by Ersan Günes, Quantitec, info@quantitec.de
